skot/MujinaControl-S19/docs/fan-bulk-capacitors.md

# Fan supply bulk capacitors

C289 and C290 are Panasonic EEHZC1E101XP (catalog C178640), 100 uF ±20%, 25 V hybrid aluminum electrolytics. Both positive pins connect to protected +12V_FAN downstream of Q1; negative pins connect to GND. Existing ceramics C283–C285 are retained. C289 serves fans 1–2, C290 fans 3–4.

The manufacturer specifies 30 milliohm maximum ESR and 1.4 A RMS ripple at 100 kHz, -55 to +125 C operation, and 4000 h endurance at 125 C. Ripple rating is frequency-dependent; the catalog's 210 mA at 100 Hz is not the 100 kHz rating. These capacitors reduce fast supply disturbances; they do not supply sustained fan startup current. Check rail transients and capacitor heating with the actual fans and supply, including simultaneous start and hot plug. Added nominal stored energy at 12 V is 14.4 mJ total; no controlled-inrush function is added.

Selected package: D8, 6.3 mm diameter, 7.7 ±0.3 mm body height, 6.6 ±0.2 mm base, 7.8 mm maximum terminal span. Local KiCad footprint Capacitor_SMD:CP_Elec_6.3x7.7 uses 3.5 x 1.6 mm pads at x = ±2.7 mm. It covers the two leads (0.65 ±0.1 mm wide), including the 7.8 mm terminal envelope. Courtyard includes the 6.6 mm base. The included STEP is a generic matching-size KiCad envelope, not a manufacturer-certified detailed model.

Physical polarity map (component/top view): unstriped positive lead = symbol pin 1 = footprint pad 1 at (-2.7,0); striped negative lead = symbol pin 2 = footprint pad 2 at (+2.7,0). Bottom-view manufacturer drawing reverses the view; the positive bevel and negative stripe establish polarity, not left/right in the bottom view. Two electrical leads, two symbol pins, two electrical pads; no duplicated or mechanical pads. Library data was queried, and disposable native symbol/footprint instances were rendered and inspected under build/MujinaControl-S19/fan-bulk/pin-check.

Sources: [manufacturer specifications](https://na.industrial.panasonic.com/products/capacitors/lineup/aluminum-electrolytic-capacitors/series/80/model/126), [ZC datasheet, 2025-09-01, pp. 1–2](https://industrial.panasonic.com/cdbs/www-data/pdf/RDD0000/ABA0000C1228.pdf). Fab lookup on 2026-11-09T19:28:08Z reported 3272 pieces, $0.3848 at quantity 1, extended/economic assembly; availability and price may change.

Schematic saved and verified: all original components and 192 original pin partitions retained; two new passive branches added. ERC has no errors and two existing DISPLAY_SCL/SDA isolated-label warnings. Readability has no errors and 71 retained cross-group-wire advisories.

PCB placement and connections completed on 2026-11-09. Starting from the user's rough placement, C289 is at (128.9,57.5) mm, 180 degrees; C290 is at (117.7,57.42) mm, 0 degrees. C289 is the right-hand bulk capacitor (fan 1/2 bank); C290 is the left-hand capacitor (fan 3/4 bank). Only these two footprints moved. D231, D232, D233 and L210 reference fields were repositioned; their physical placement and all pre-existing traces/vias were preserved.

Each positive pad uses three parallel 0.45/0.30 mm filled/capped vias in the pad and a short 1.0 mm B.Cu branch into the existing +12V_FAN pour. Each ground pad uses three matching vias into both existing GND planes. Four tracks and twelve vias were added. Native connectivity readback confirms both positive pads reach Q1's source and all fan power pins; both negative pads reach all fan ground pins. The two capacitor branches carry ripple/charging current, not the four fans' continuous supply current.

Sizing screen: 1.4 A RMS capacitor ripple rating, 35 um external copper, 1.0 mm trace width, no more than 2 mm branch length, 10 C rise target. The conservative IPC-2221 external-trace relation gives about 2.39 A at 10 C rise. At 20 C copper resistivity, the longest branch is approximately 0.99 milliohm. Three parallel vias add approximately 0.36 milliohm using a 1.6 mm board and an assumed 25 um plated barrel; the combined drop is about 1.88 mV at 1.4 A. This is a screening calculation, not measured thermal/inrush qualification or confirmation of delivered plating thickness.

Verification: 257 footprints; only C289/C290 changed position/orientation. Full native object comparison preserved all original copper; session-generated board/custom-field/custom-pad-shape IDs were normalized when comparing reopened documents. Filled zones were saved. Native DRC: 108 to 85 findings, no new findings, no capacitor-related violations. Unconnected items: 246 to 242; neither capacitor has a remaining airwire. Existing Q1 ki_fp_filters parity warning remains. Schematic was unchanged during PCB work. Board-wide routing remains unfinished.

Evidence: build/MujinaControl-S19/fan-bulk-routing/audit.json, final-drc.json, routing-applied.json and fan-capacitors.png. Saved board was displayed in the canonical viewer and checked against the history checkpoint.
