skot/MujinaControl-S19/3d/kicad/SOT-363_SC-70-6.step

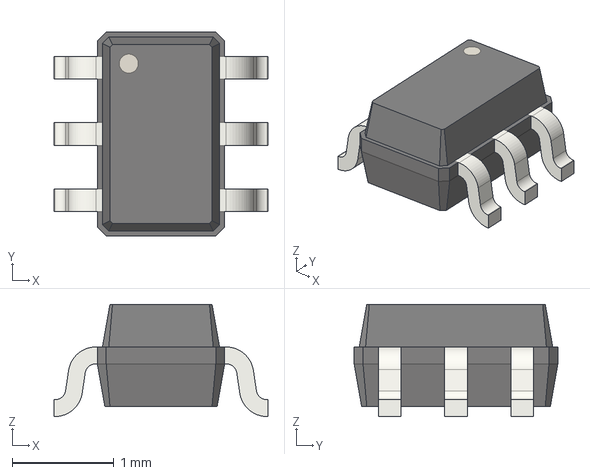
[picture p3: CAD file, 2026-11-10]
3d/kicad/SOT-363_SC-70-6.step
2.10 x 2.00 x 1.10 mm
