skot/MujinaControl-S19/3d/proxies/L_0201_0603Metric.step

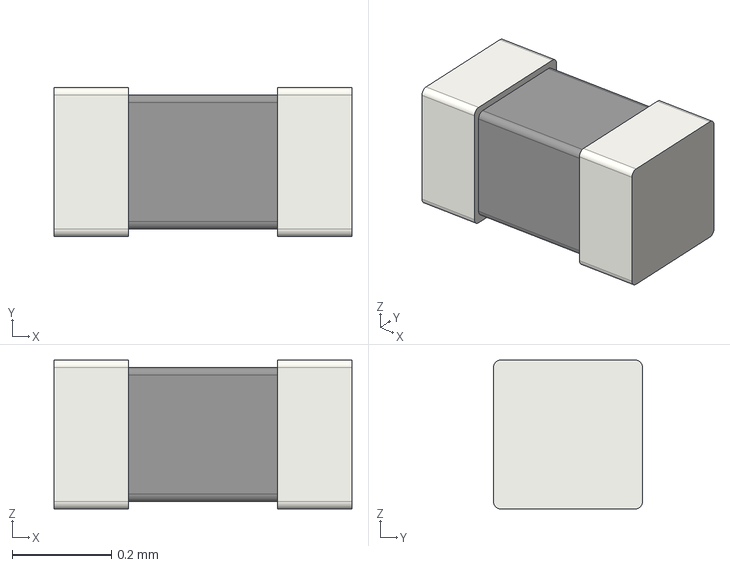
[picture p4: CAD file, 2026-11-07]
3d/proxies/L_0201_0603Metric.step
0.6 x 0.3 x 0.3 mm
