skot/MujinaControl-S19/models/CP_Elec_6.3x7.7.step

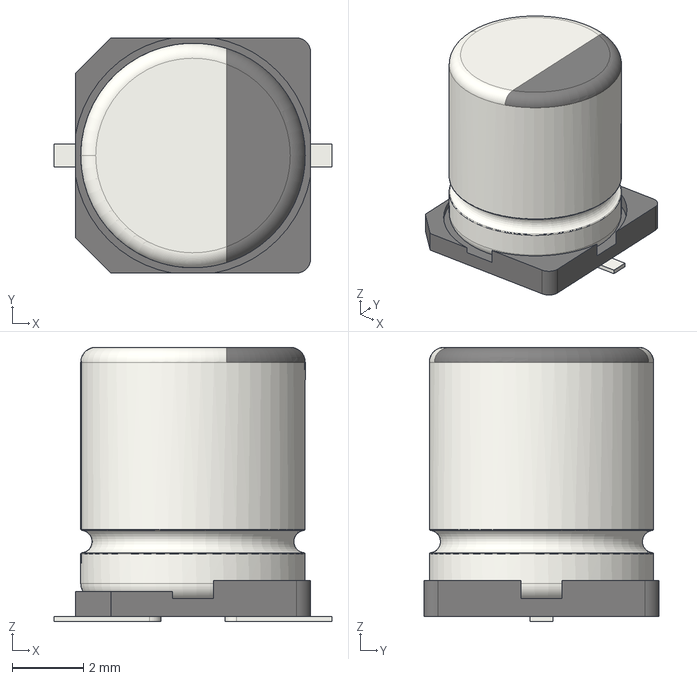
[picture p5: CAD file, 2026-11-10]
models/CP_Elec_6.3x7.7.step
7.80 x 6.60 x 7.70 mm
