skot/MujinaControl-S19/3d/bitcrane/CONN-TH_X2026WV-2-09D-46SN.step

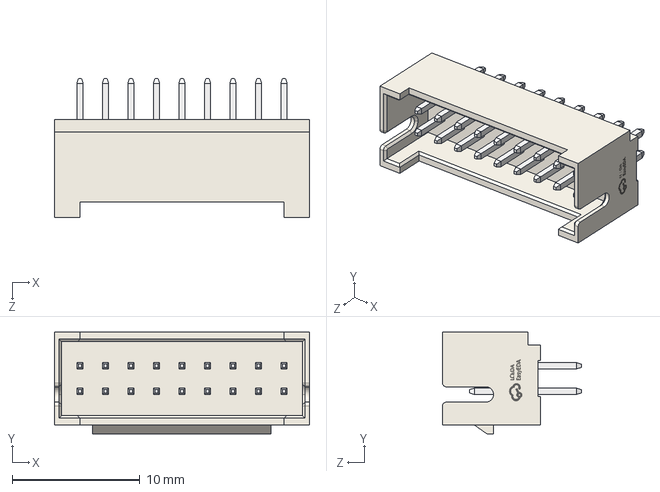
[picture p6: CAD file, 2026-11-07]
3d/bitcrane/CONN-TH_X2026WV-2-09D-46SN.step
20.0 x 8.00 x 10.9 mm
