skot/MujinaControl-S19/3d/kicad/PinHeader_2x20_P2.54mm_Vertical.step

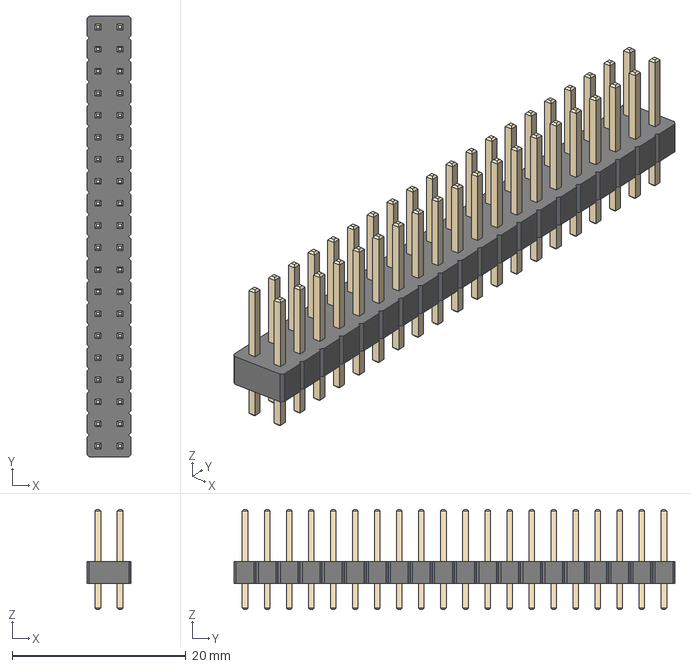
[picture p7: CAD file, 2026-11-10]
3d/kicad/PinHeader_2x20_P2.54mm_Vertical.step
5.08 x 50.8 x 11.5 mm
