skot/MujinaControl-S19/3d/raven/Rockchip_QFN-128-1EP_12.3x12.3mm_P0.35mm_EP7x7mm.step

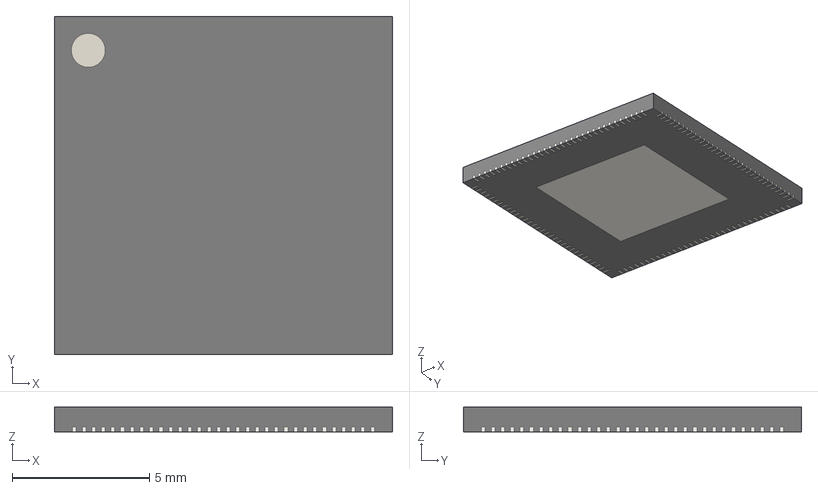
[picture p8: CAD file, 2026-11-02]
3d/raven/Rockchip_QFN-128-1EP_12.3x12.3mm_P0.35mm_EP7x7mm.step
12.3 x 12.3 x 0.9 mm
