skot/MujinaControl-S19/models/IND-SMD_L2.0-W1.6-H1.1.step

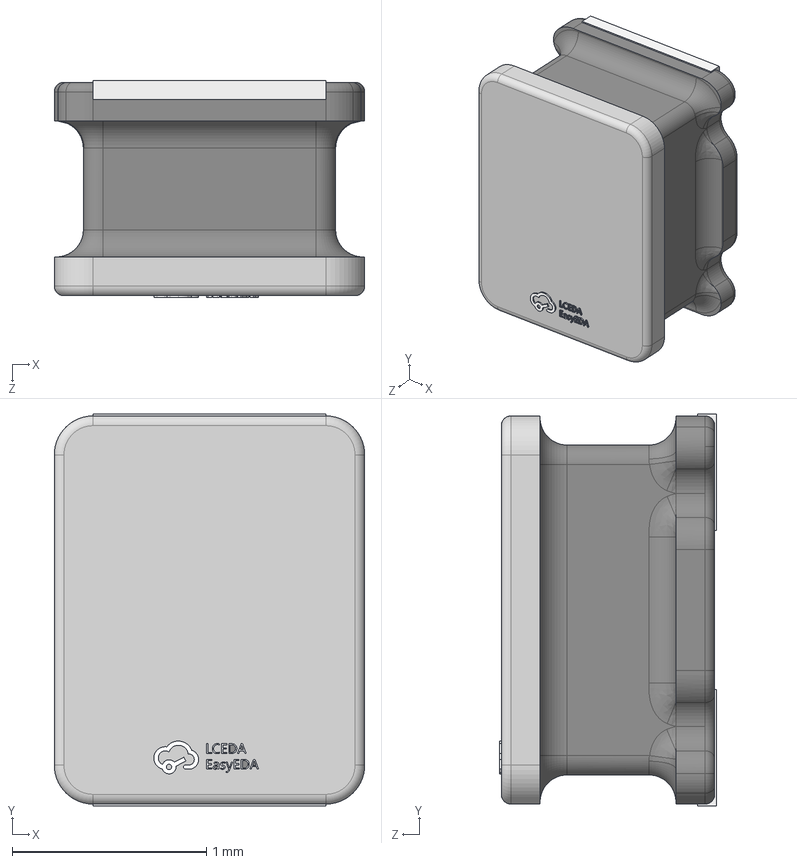
[picture p9: CAD file, 2026-11-10]
models/IND-SMD_L2.0-W1.6-H1.1.step
1.60 x 2.02 x 1.12 mm
