skot/MujinaControl-S19/3d/bitcrane/CONN-TH_MX4.20-WI-2x2P.step

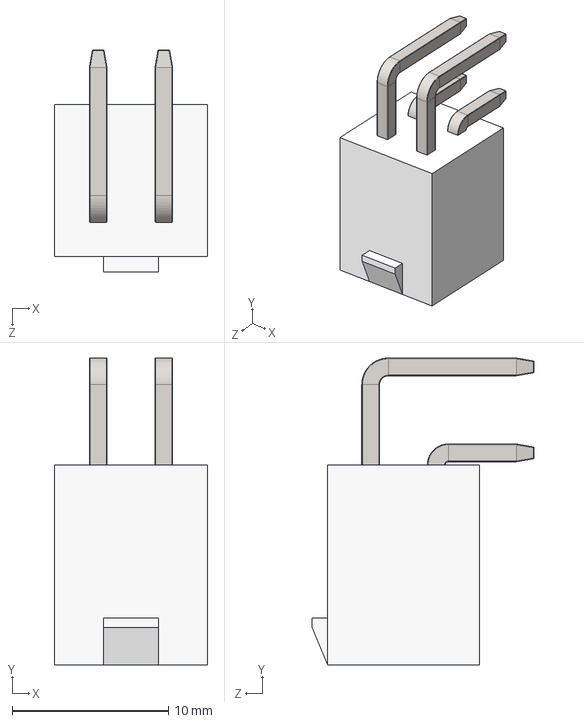
[picture p10: CAD file, 2026-11-07]
3d/bitcrane/CONN-TH_MX4.20-WI-2x2P.step
9.80 x 19.6 x 14.2 mm
