skot/MujinaControl-S19/3d/kicad/R_0402_1005Metric.step

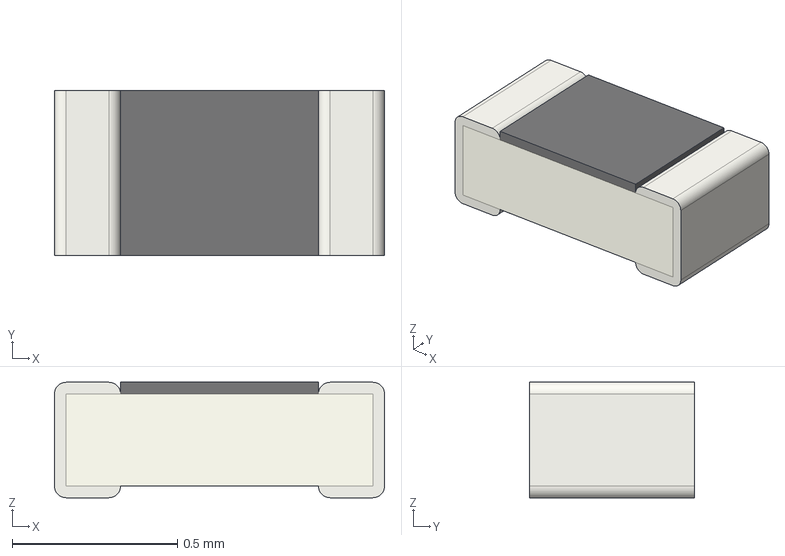
[picture p11: CAD file, 2026-11-07]
3d/kicad/R_0402_1005Metric.step
1.00 x 0.5 x 0.35 mm
