skot/MujinaControl-S19/3d/bitcrane/SW-SMD_L3.9-W2.9-H2.0-LS4.8.step

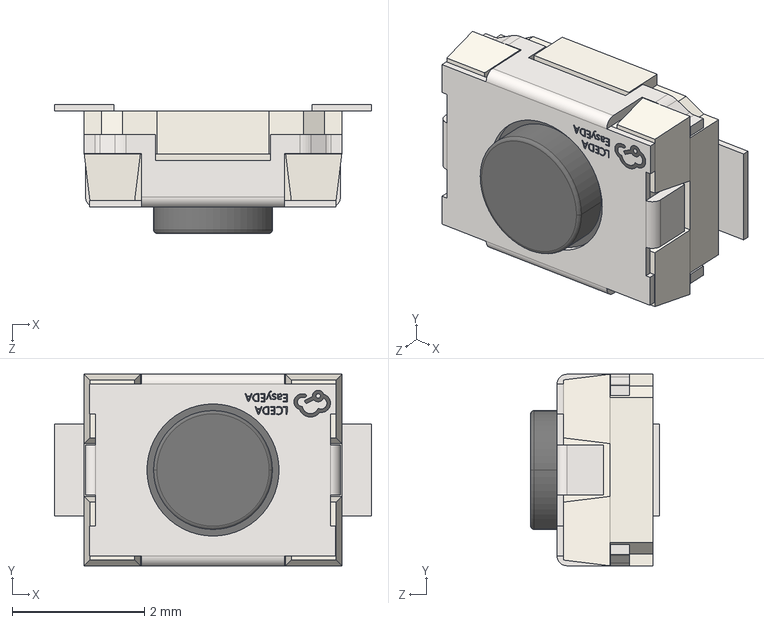
[picture p13: CAD file, 2026-11-07]
3d/bitcrane/SW-SMD_L3.9-W2.9-H2.0-LS4.8.step
4.80 x 2.90 x 1.95 mm
