skot/MujinaControl-S19/3d/kicad/C_1808_4520Metric.step

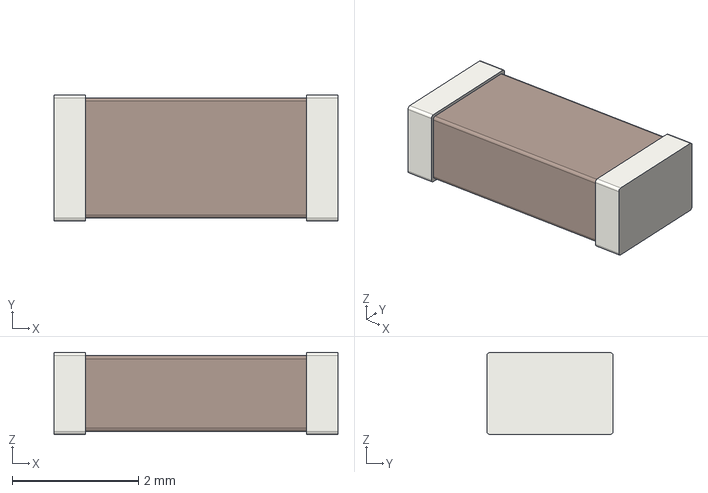
[picture p14: CAD file, 2026-11-07]
3d/kicad/C_1808_4520Metric.step
4.50 x 2.00 x 1.30 mm
