skot/MujinaControl-S19/models/SOT-583-8_L2.1-W1.2-P0.50-LS1.6-BR.step

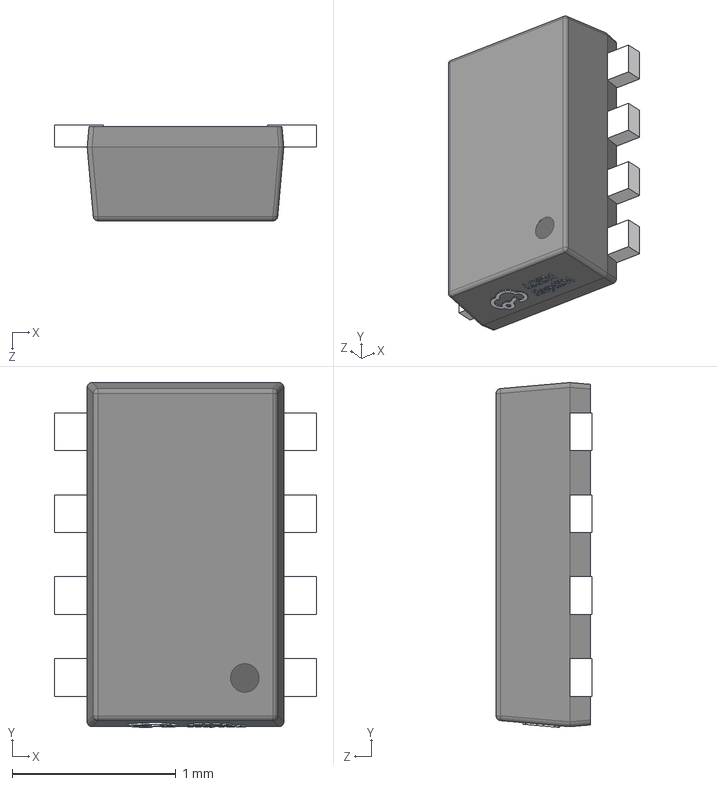
[picture p15: CAD file, 2026-11-10]
models/SOT-583-8_L2.1-W1.2-P0.50-LS1.6-BR.step
1.60 x 2.10 x 0.585 mm
