skot/MujinaControl-S19/3d/bitcrane/CONN-TH_50362462.step

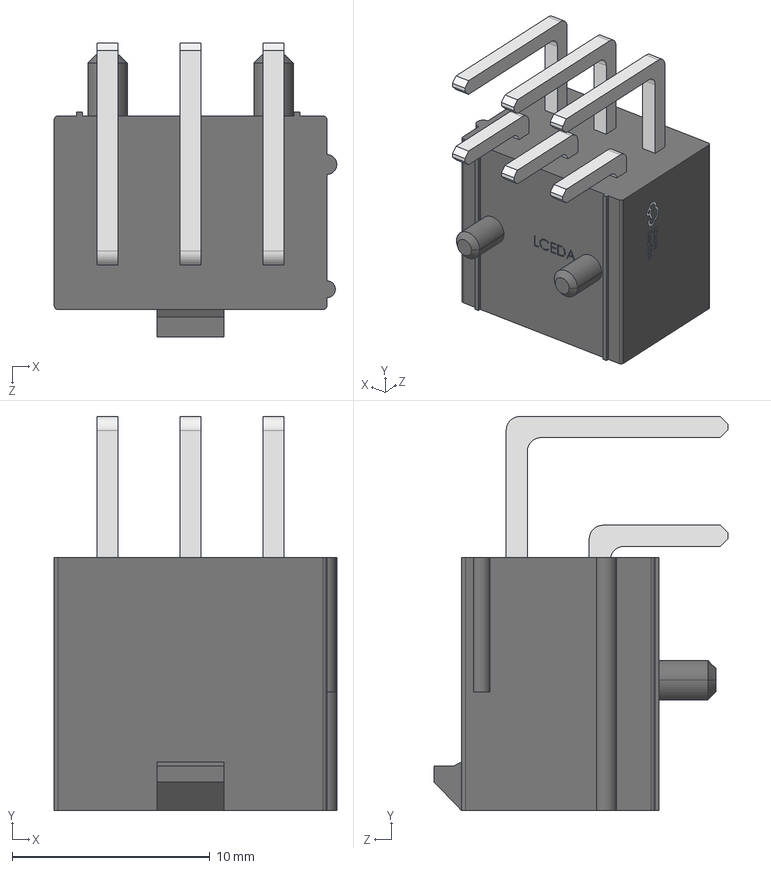
[picture p16: CAD file, 2026-11-07]
3d/bitcrane/CONN-TH_50362462.step
14.3 x 19.9 x 14.9 mm
