skot/MujinaControl-S19/3d/kicad/Crystal_SMD_3225-4Pin_3.2x2.5mm.step

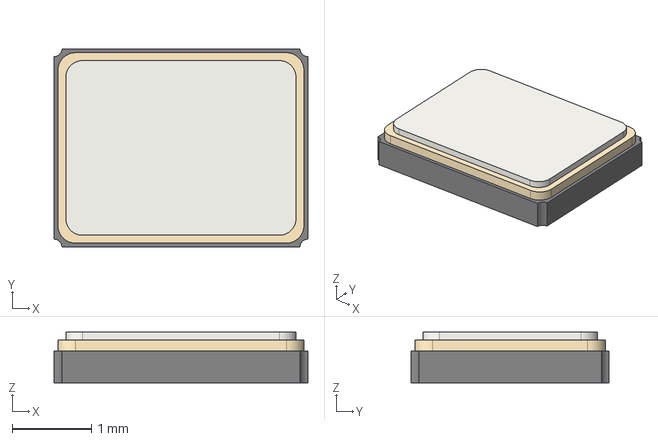
[picture p17: CAD file, 2026-11-07]
3d/kicad/Crystal_SMD_3225-4Pin_3.2x2.5mm.step
3.20 x 2.50 x 0.64 mm
