skot/MujinaControl-S19/3d/bitcrane/CONN-TH_4P-P2.54_HCTL_HC-2510-4AW.step

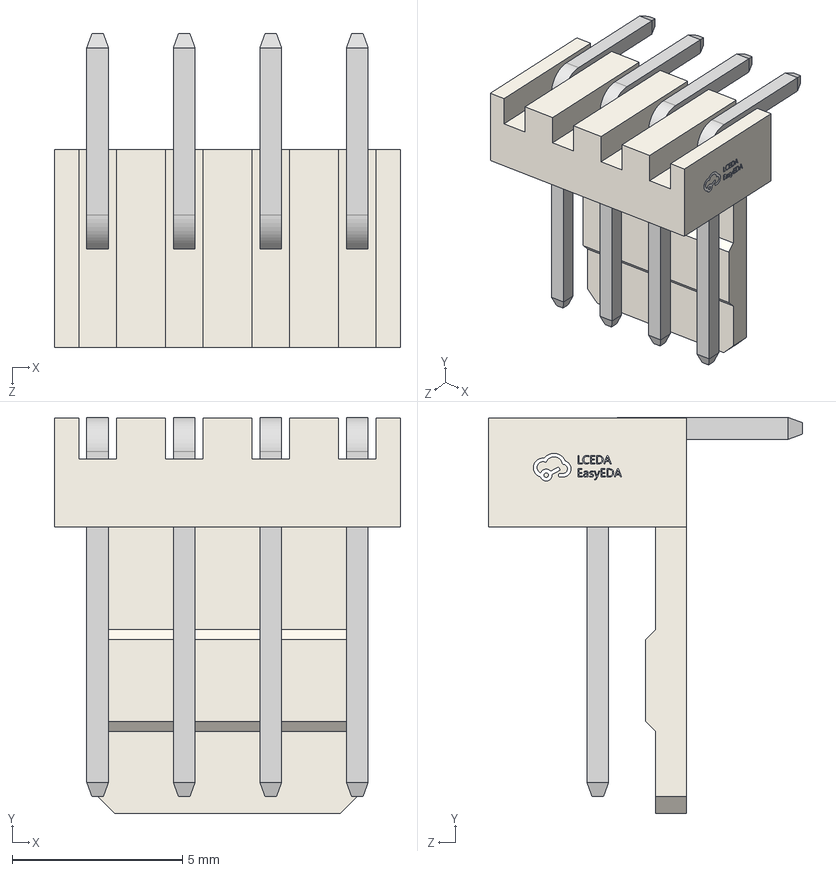
[picture p18: CAD file, 2026-11-07]
3d/bitcrane/CONN-TH_4P-P2.54_HCTL_HC-2510-4AW.step
10.2 x 11.6 x 9.20 mm
