skot/MujinaControl-S19/3d/kicad/C_1210_3225Metric.step

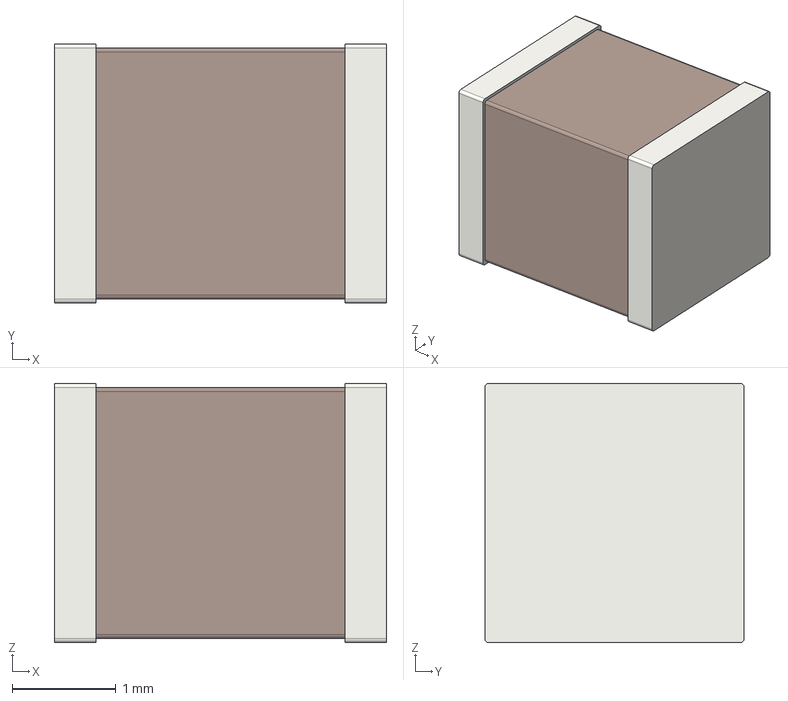
[picture p19: CAD file, 2026-11-07]
3d/kicad/C_1210_3225Metric.step
3.20 x 2.50 x 2.50 mm
