skot/MujinaControl-S19/3d/bitcrane/CONN-TH_6P-P2.00_PHD-2X3A.step

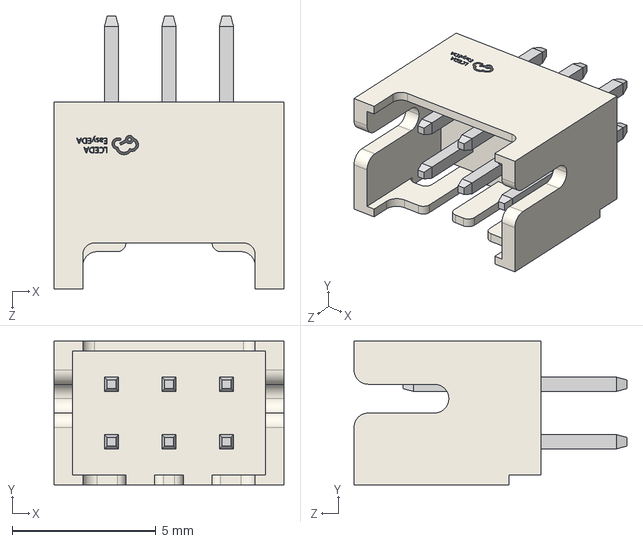
[picture p20: CAD file, 2026-11-07]
3d/bitcrane/CONN-TH_6P-P2.00_PHD-2X3A.step
8.00 x 5.00 x 9.50 mm
