skot/MujinaControl-S19/3d/kicad/C_0805_2012Metric.step

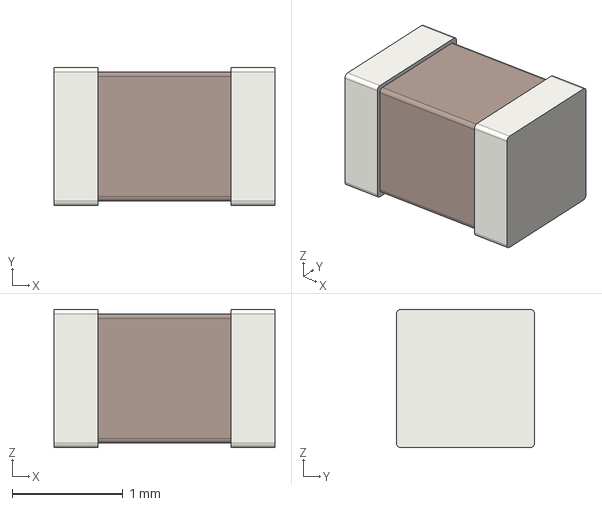
[picture p21: CAD file, 2026-11-07]
3d/kicad/C_0805_2012Metric.step
2.00 x 1.25 x 1.25 mm
