skot/MujinaControl-S19/3d/kicad/TSOT-23-6.step

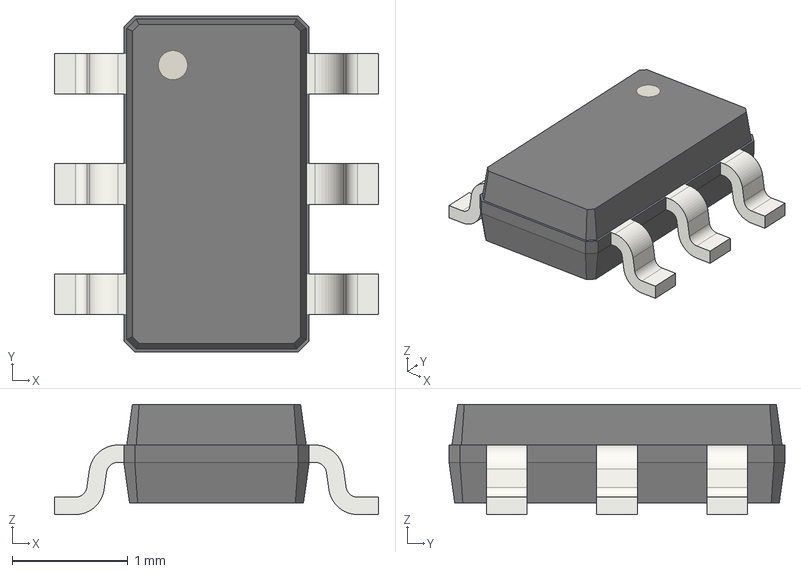
[picture p22: CAD file, 2026-11-07]
3d/kicad/TSOT-23-6.step
2.80 x 2.90 x 0.95 mm
