skot/MujinaControl-S19/3d/kicad/SOT-23.step

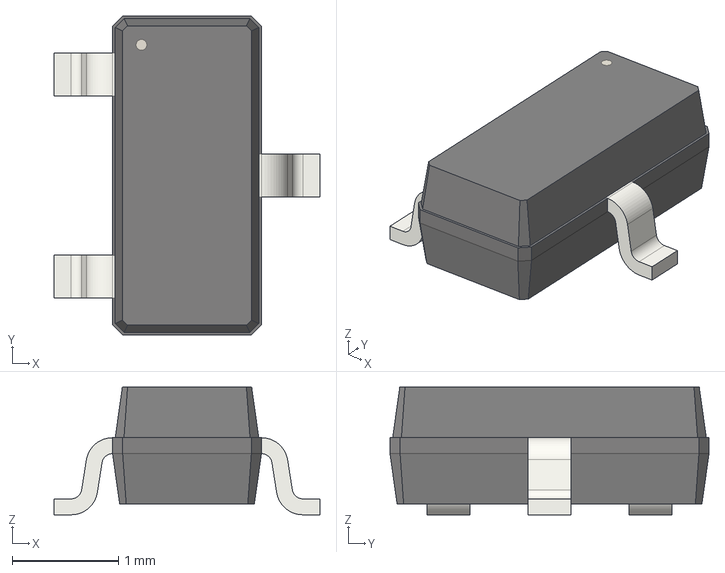
[picture p23: CAD file, 2026-11-07]
3d/kicad/SOT-23.step
2.50 x 3.00 x 1.20 mm
