skot/MujinaControl-S19/3d/kicad/SOT-23-6.step

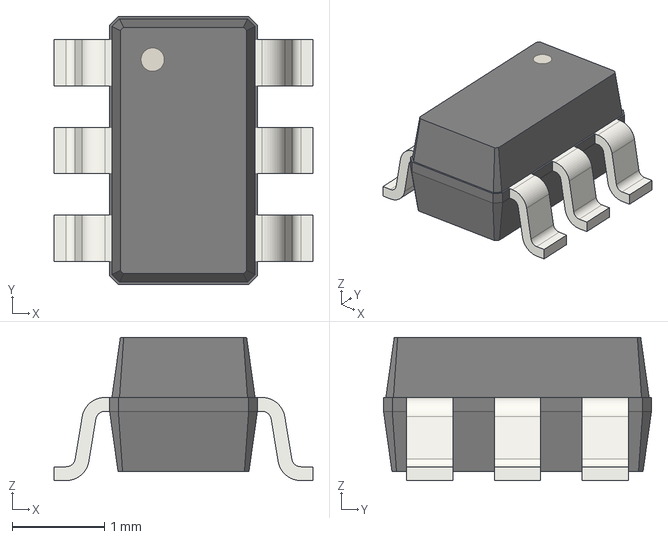
[picture p24: CAD file, 2026-11-07]
3d/kicad/SOT-23-6.step
2.80 x 2.90 x 1.55 mm
