skot/MujinaControl-S19/3d/kicad/L_APV_ANR6028.step

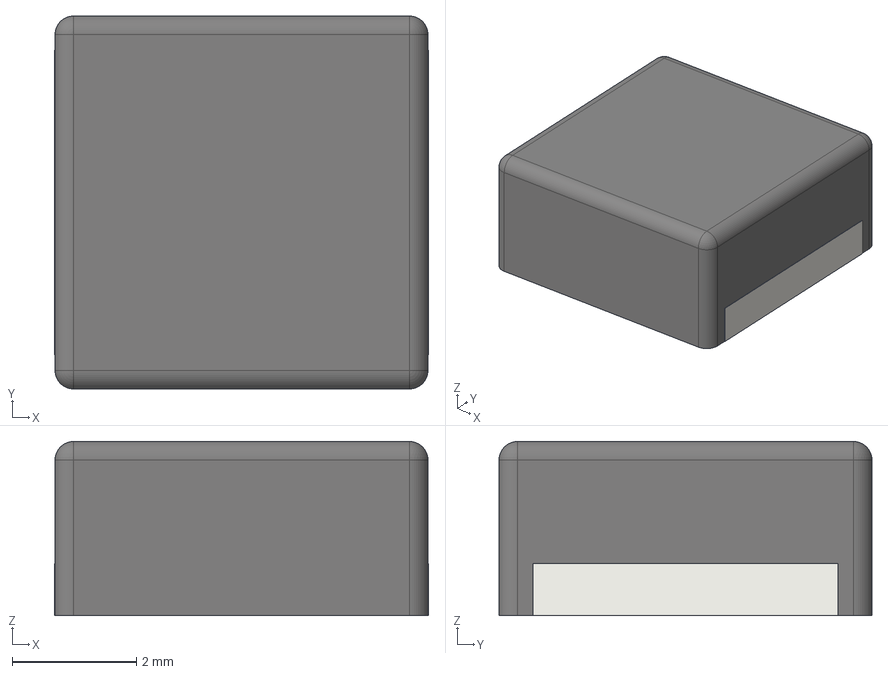
[picture p25: CAD file, 2026-11-07]
3d/kicad/L_APV_ANR6028.step
6.02 x 6.00 x 2.80 mm
