skot/MujinaControl-S19/3d/kicad/Crystal_SMD_3215-2Pin_3.2x1.5mm.step

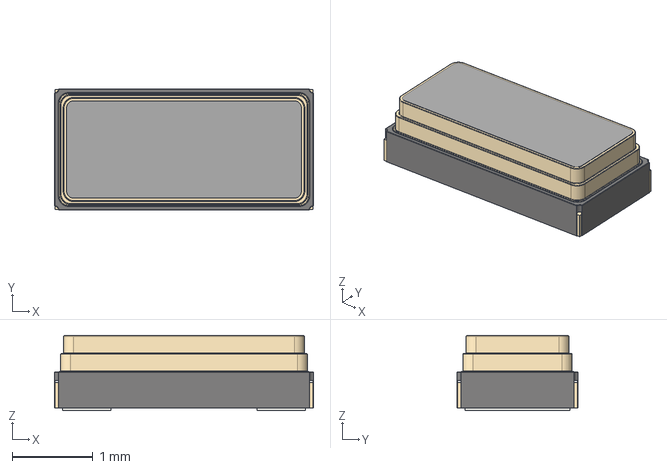
[picture p26: CAD file, 2026-11-07]
3d/kicad/Crystal_SMD_3215-2Pin_3.2x1.5mm.step
3.20 x 1.50 x 0.93 mm
