skot/MujinaControl-S19/3d/kicad/PinHeader_1x03_P2.54mm_Vertical.step

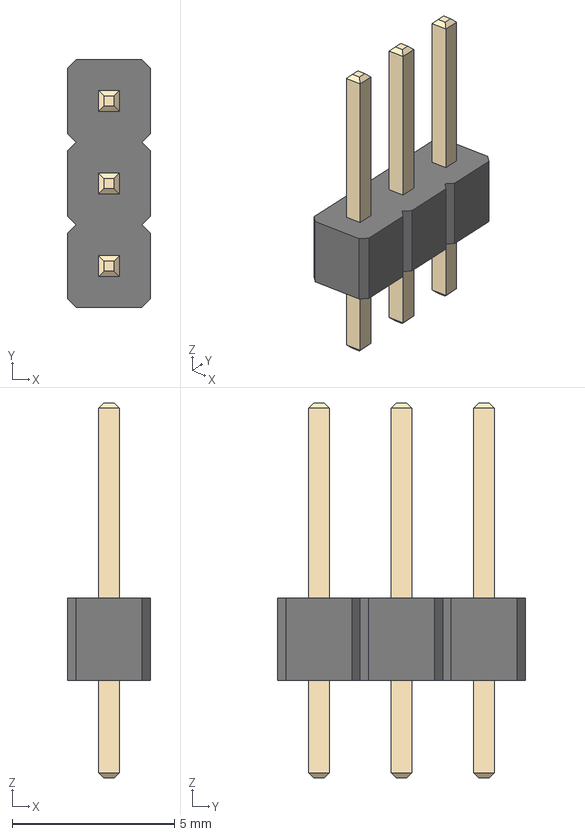
[picture p27: CAD file, 2026-11-07]
3d/kicad/PinHeader_1x03_P2.54mm_Vertical.step
2.54 x 7.62 x 11.5 mm
