skot/MujinaControl-S19/3d/kicad/D_SOD-523.step

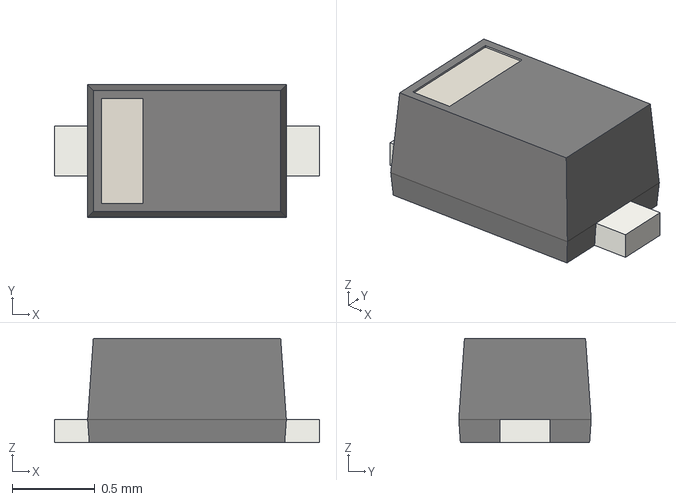
[picture p28: CAD file, 2026-11-07]
3d/kicad/D_SOD-523.step
1.60 x 0.8 x 0.63 mm
