skot/MujinaControl-S19/3d/kicad/D_SOD-123.step

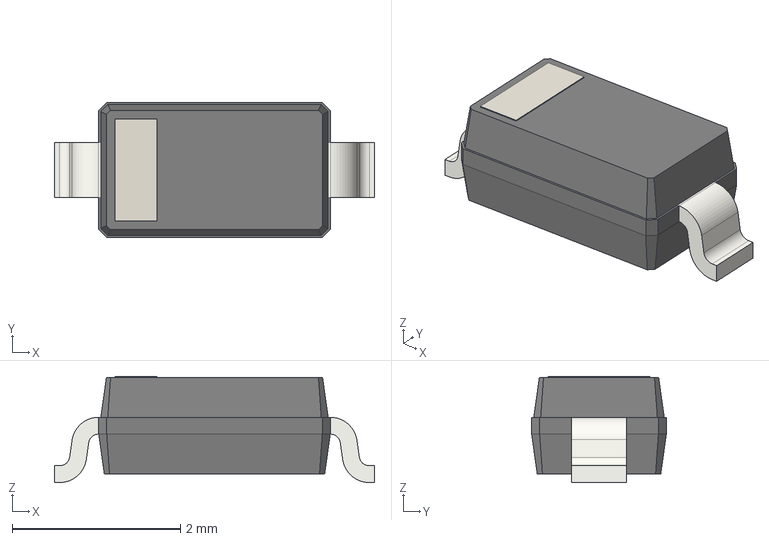
[picture p29: CAD file, 2026-11-07]
3d/kicad/D_SOD-123.step
3.80 x 1.60 x 1.26 mm
