skot/MujinaControl-S19/3d/kicad/microSD_HC_Hirose_DM3D-SF.step

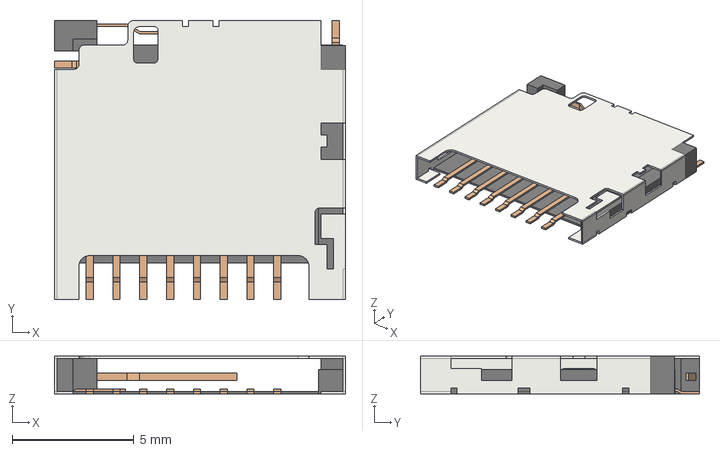
[picture p30: CAD file, 2026-11-07]
3d/kicad/microSD_HC_Hirose_DM3D-SF.step
11.9 x 11.5 x 1.55 mm
