skot/MujinaControl-S19/3d/kicad/C_0402_1005Metric.step

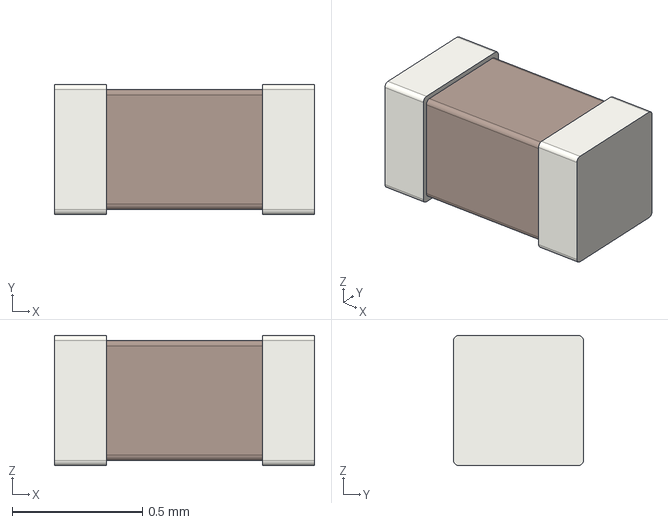
[picture p31: CAD file, 2026-11-07]
3d/kicad/C_0402_1005Metric.step
1.00 x 0.5 x 0.5 mm
