skot/MujinaControl-S19/3d/kicad/LED_0603_1608Metric.step

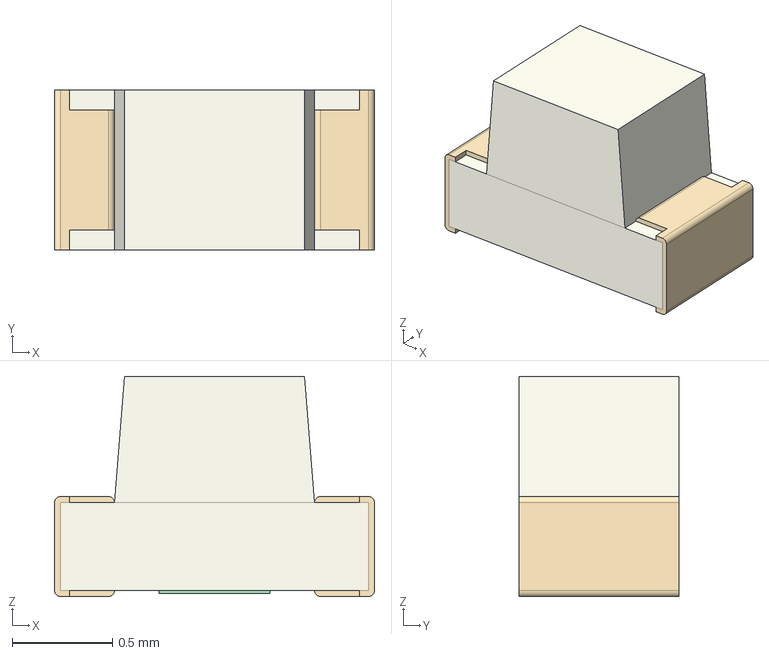
[picture p33: CAD file, 2026-11-07]
3d/kicad/LED_0603_1608Metric.step
1.60 x 0.8 x 1.10 mm
