skot/MujinaControl-S19/3d/kicad/Diodes_PowerDI3333-8.step

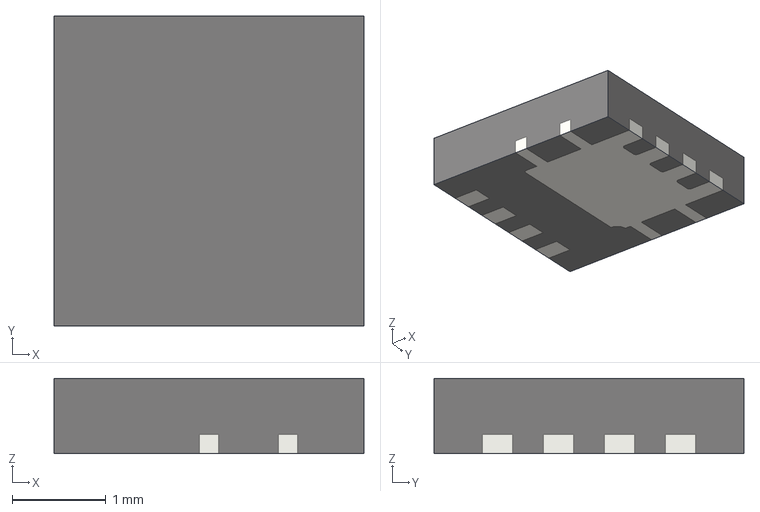
[picture p34: CAD file, 2026-11-07]
3d/kicad/Diodes_PowerDI3333-8.step
3.30 x 3.30 x 0.8 mm
