skot/MujinaControl-S19/3d/kicad/L_Bourns-SRN4018.step

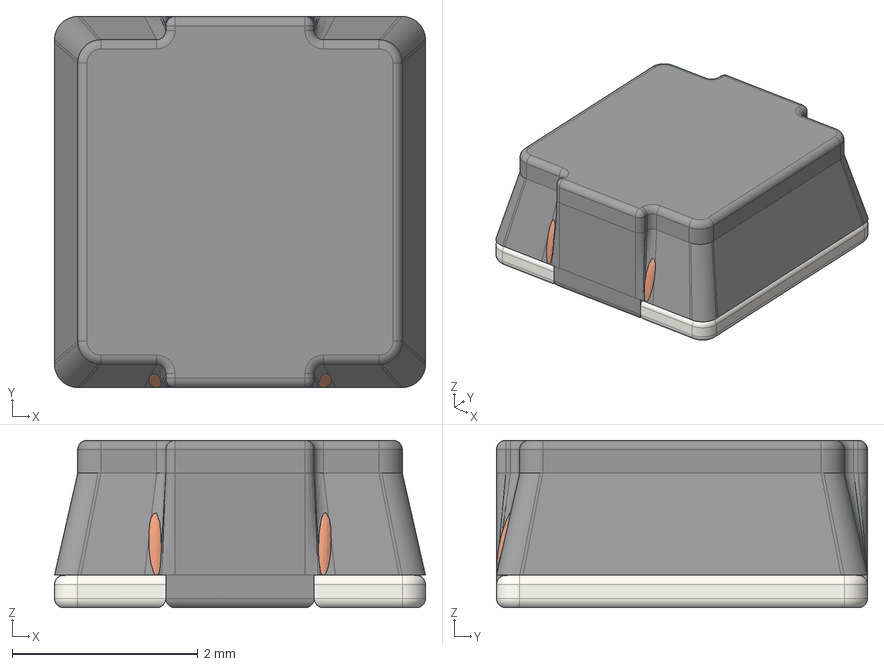
[picture p35: CAD file, 2026-11-07]
3d/kicad/L_Bourns-SRN4018.step
4.00 x 4.00 x 1.80 mm
