skot/MujinaControl-S19/3d/kicad/PinHeader_1x04_P2.54mm_Vertical.step

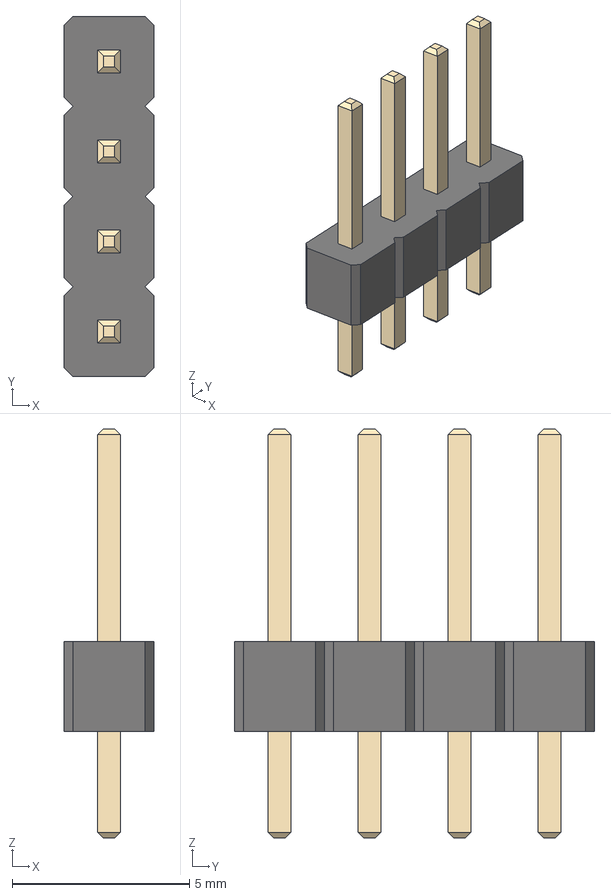
[picture p36: CAD file, 2026-11-07]
3d/kicad/PinHeader_1x04_P2.54mm_Vertical.step
2.54 x 10.2 x 11.5 mm
