skot/MujinaControl-S19/3d/kicad/D_SMB.step

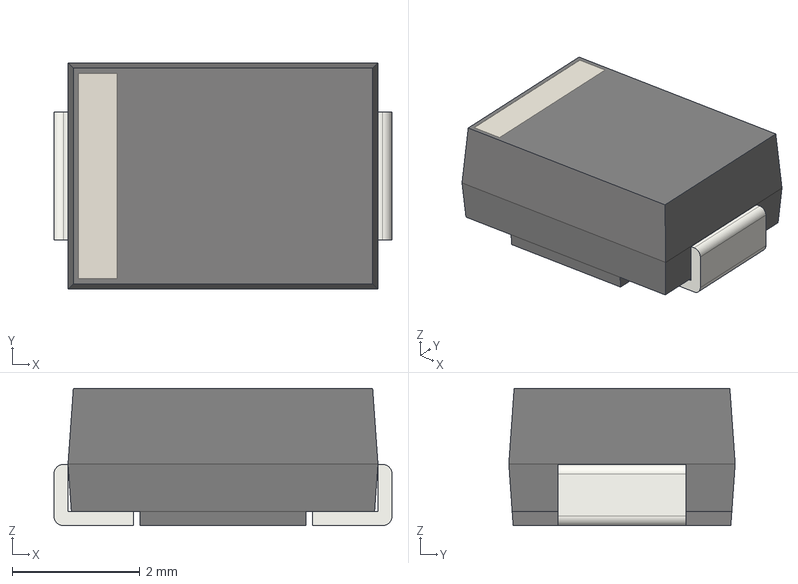
[picture p37: CAD file, 2026-11-07]
3d/kicad/D_SMB.step
5.30 x 3.55 x 2.15 mm
