skot/MujinaControl-S19/(list of files, cad)

Other CAD files:
3d/kicad/L_0402_1005Metric.step
3d/raven/HR911105A.step
