skot/MujinaControl-S19/MujinaControl-S19.kicad_pcb

## KiCad design MujinaControl-S19.kicad_pcb (2026-11-12)

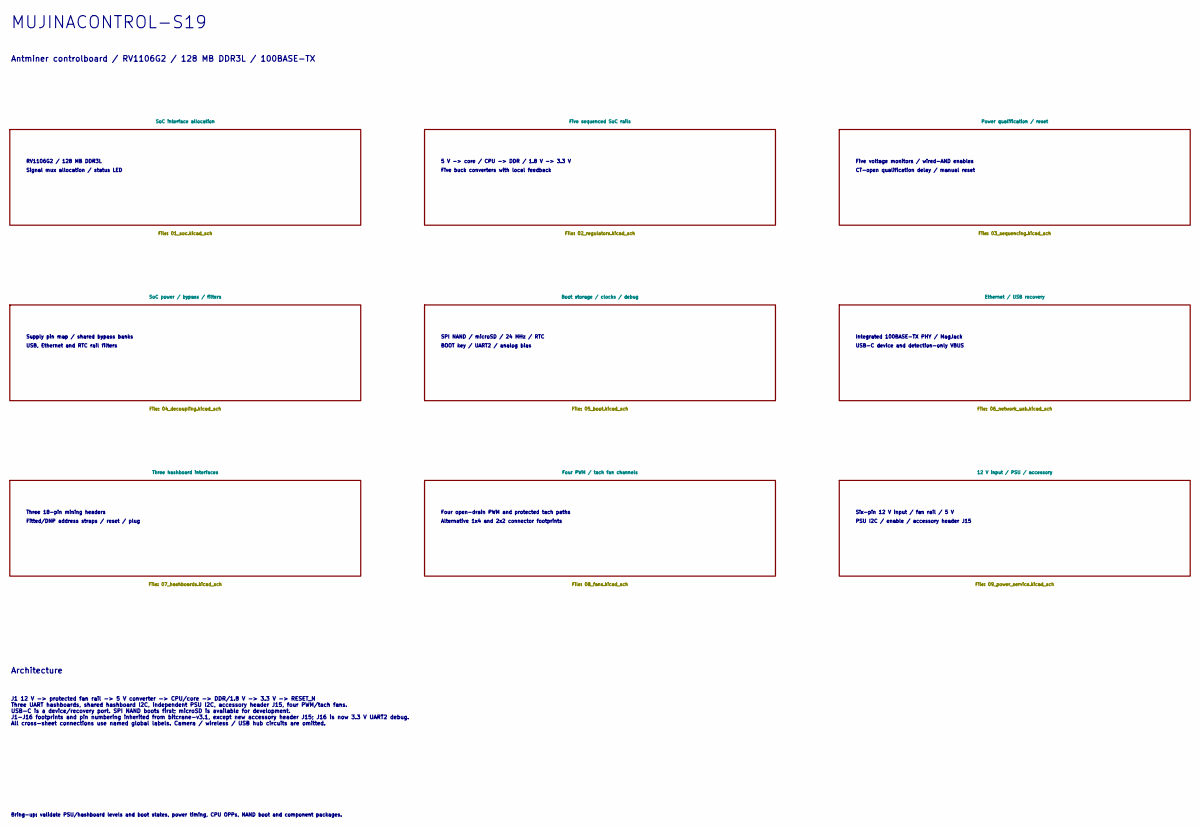
[picture p38: schematic MujinaControl-S19.kicad_sch, MujinaControl-S19 / System overview]

Notes on the sheet:
USB, Ethernet and RTC rail filters
Integrated 100BASE-TX PHY / MagJack
Five voltage monitors / wired-AND enables
PSU I2C / enable / accessory header J15
MUJINACONTROL-S19
5 V -> core / CPU -> DDR / 1.8 V -> 3.3 V
Architecture
Five buck converters with local feedback
BOOT key / UART2 / analog bias
Alternative 1x4 and 2x2 connector footprints
USB-C device and detection-only VBUS
SPI NAND / microSD / 24 MHz / RTC
J1 12 V -> protected fan rail -> 5 V converter -> CPU/core -> DDR/1.8 V -> 3.3 V -> RESET_N Three UART hashboards, shared hashboard I2C, independent PSU I2C, accessory header J15, four PWM/tach fans. USB-C is a device/recovery port. SPI NAND boots first; microSD is available for development. J1-J16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
Supply pin map / shared bypass banks
Antminer controlboard / RV1106G2 / 128 MB DDR3L / 100BASE-TX
CT-open qualification delay / manual reset
Fitted/DNP address straps / reset / plug
RV1106G2 / 128 MB DDR3L
Bring-up: validate PSU/hashboard levels and boot states, power timing, CPU OPPs, NAND boot and component packages.
Signal mux allocation / status LED
Three 18-pin mining headers
Four open-drain PWM and protected tach paths
Six-pin 12 V input / fan rail / 5 V

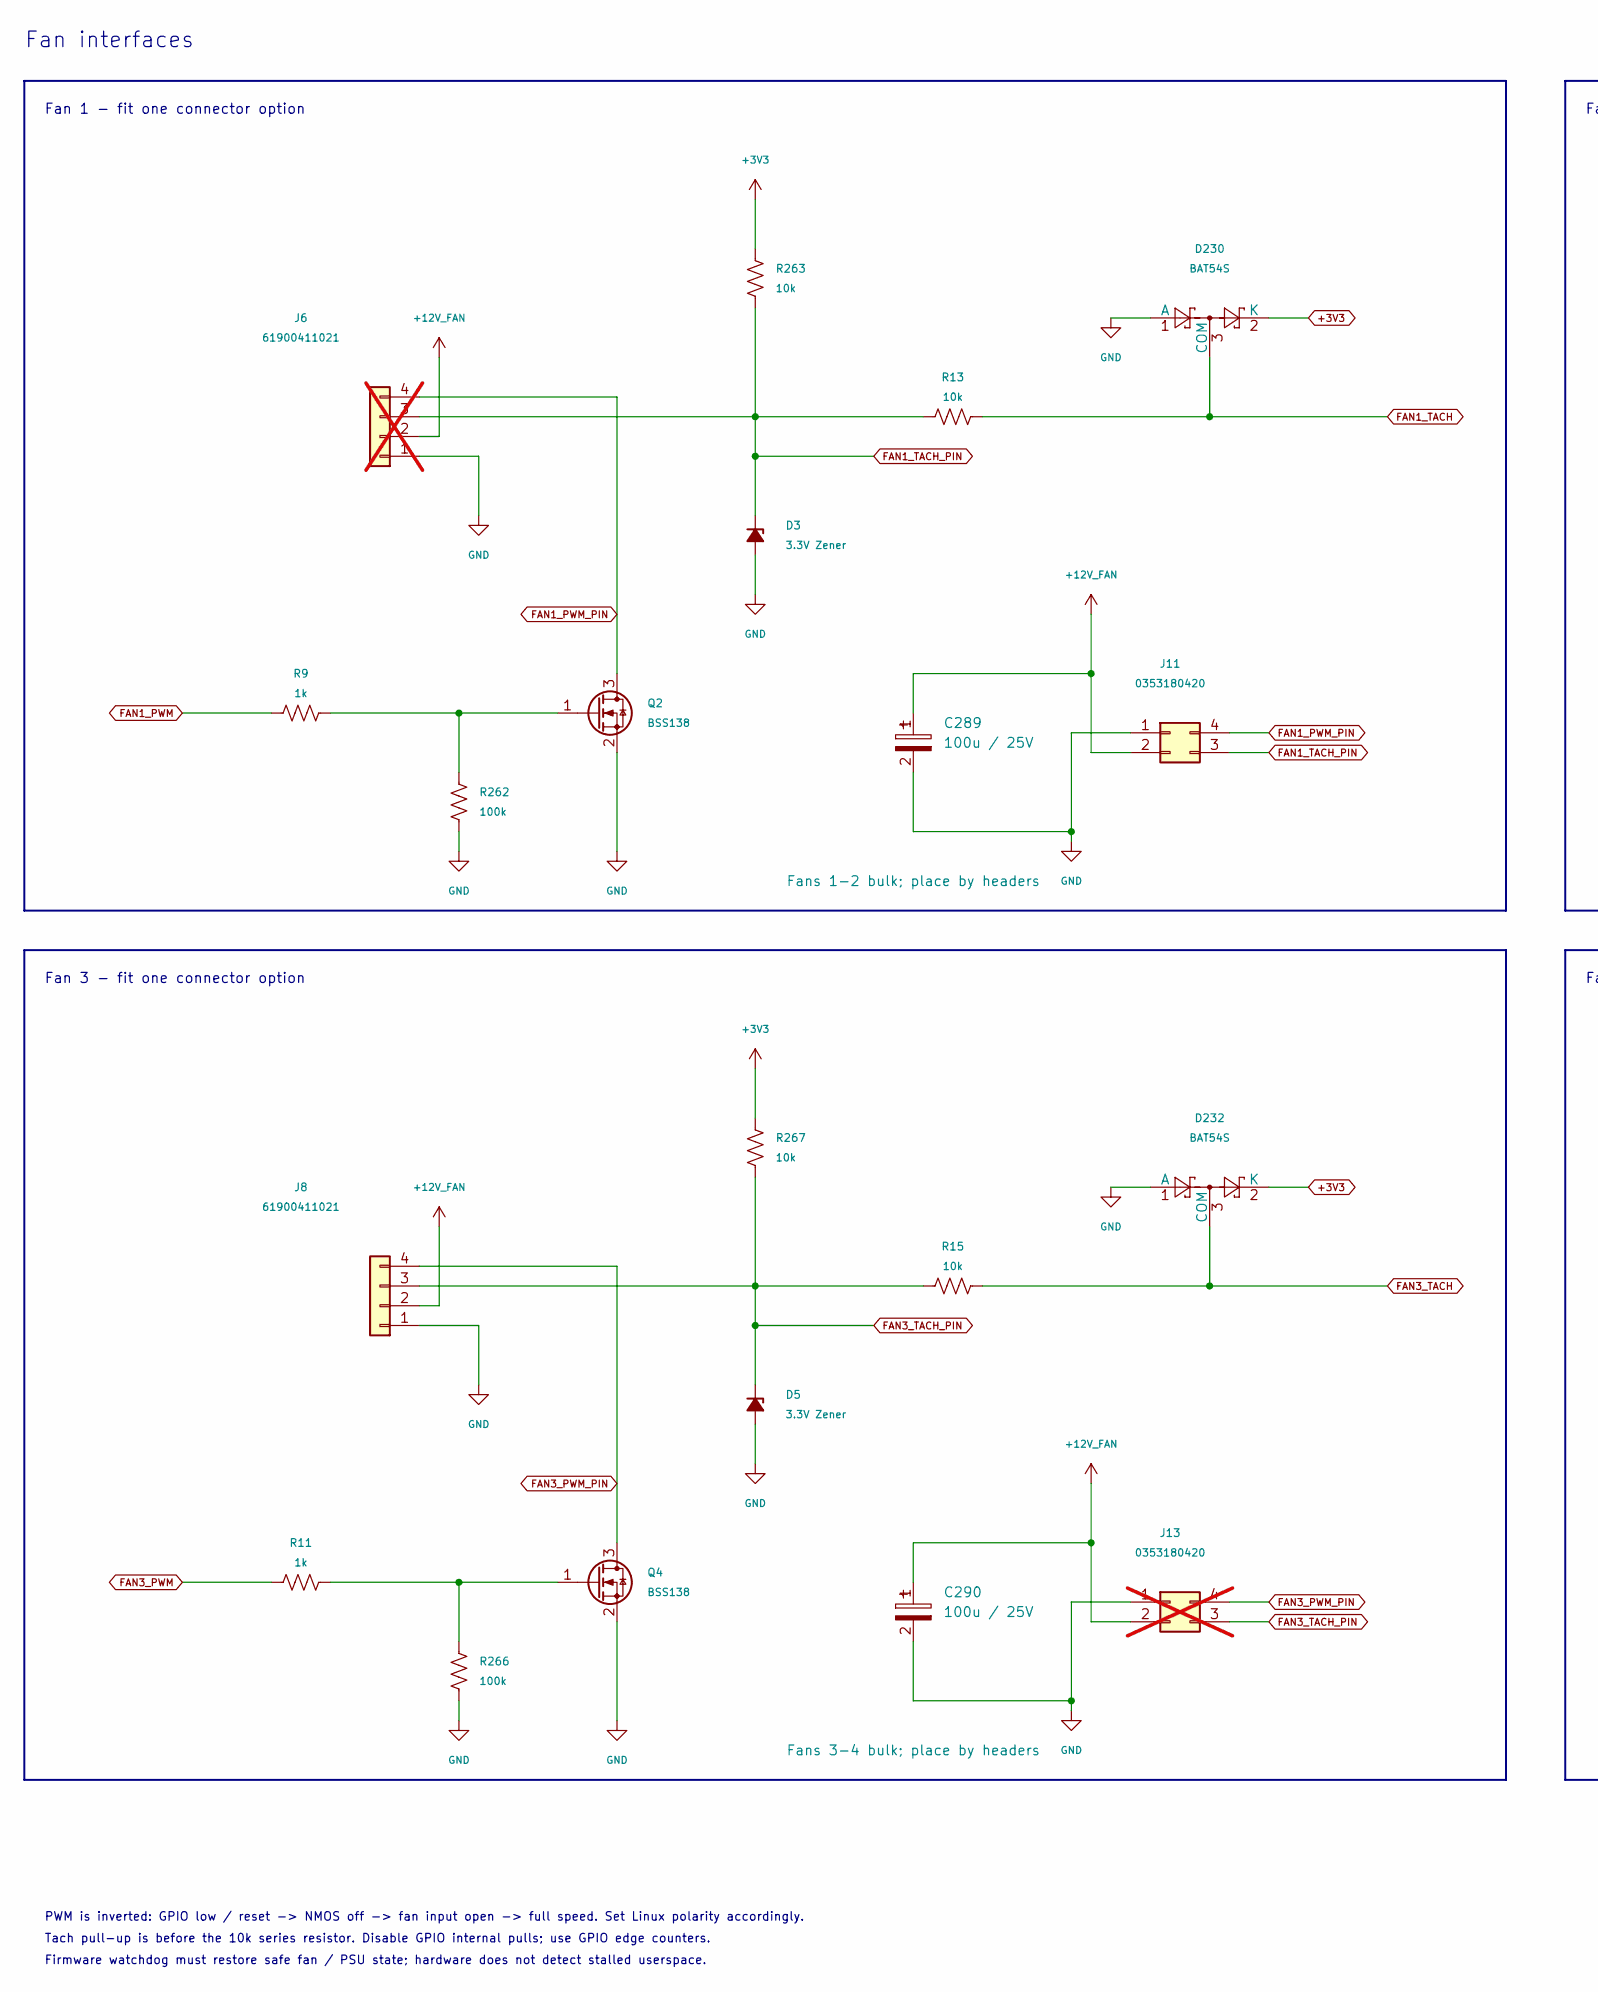
[picture p39: schematic 08_fans.kicad_sch, MujinaControl-S19 / Fan interfaces, part in row 1, column 1]

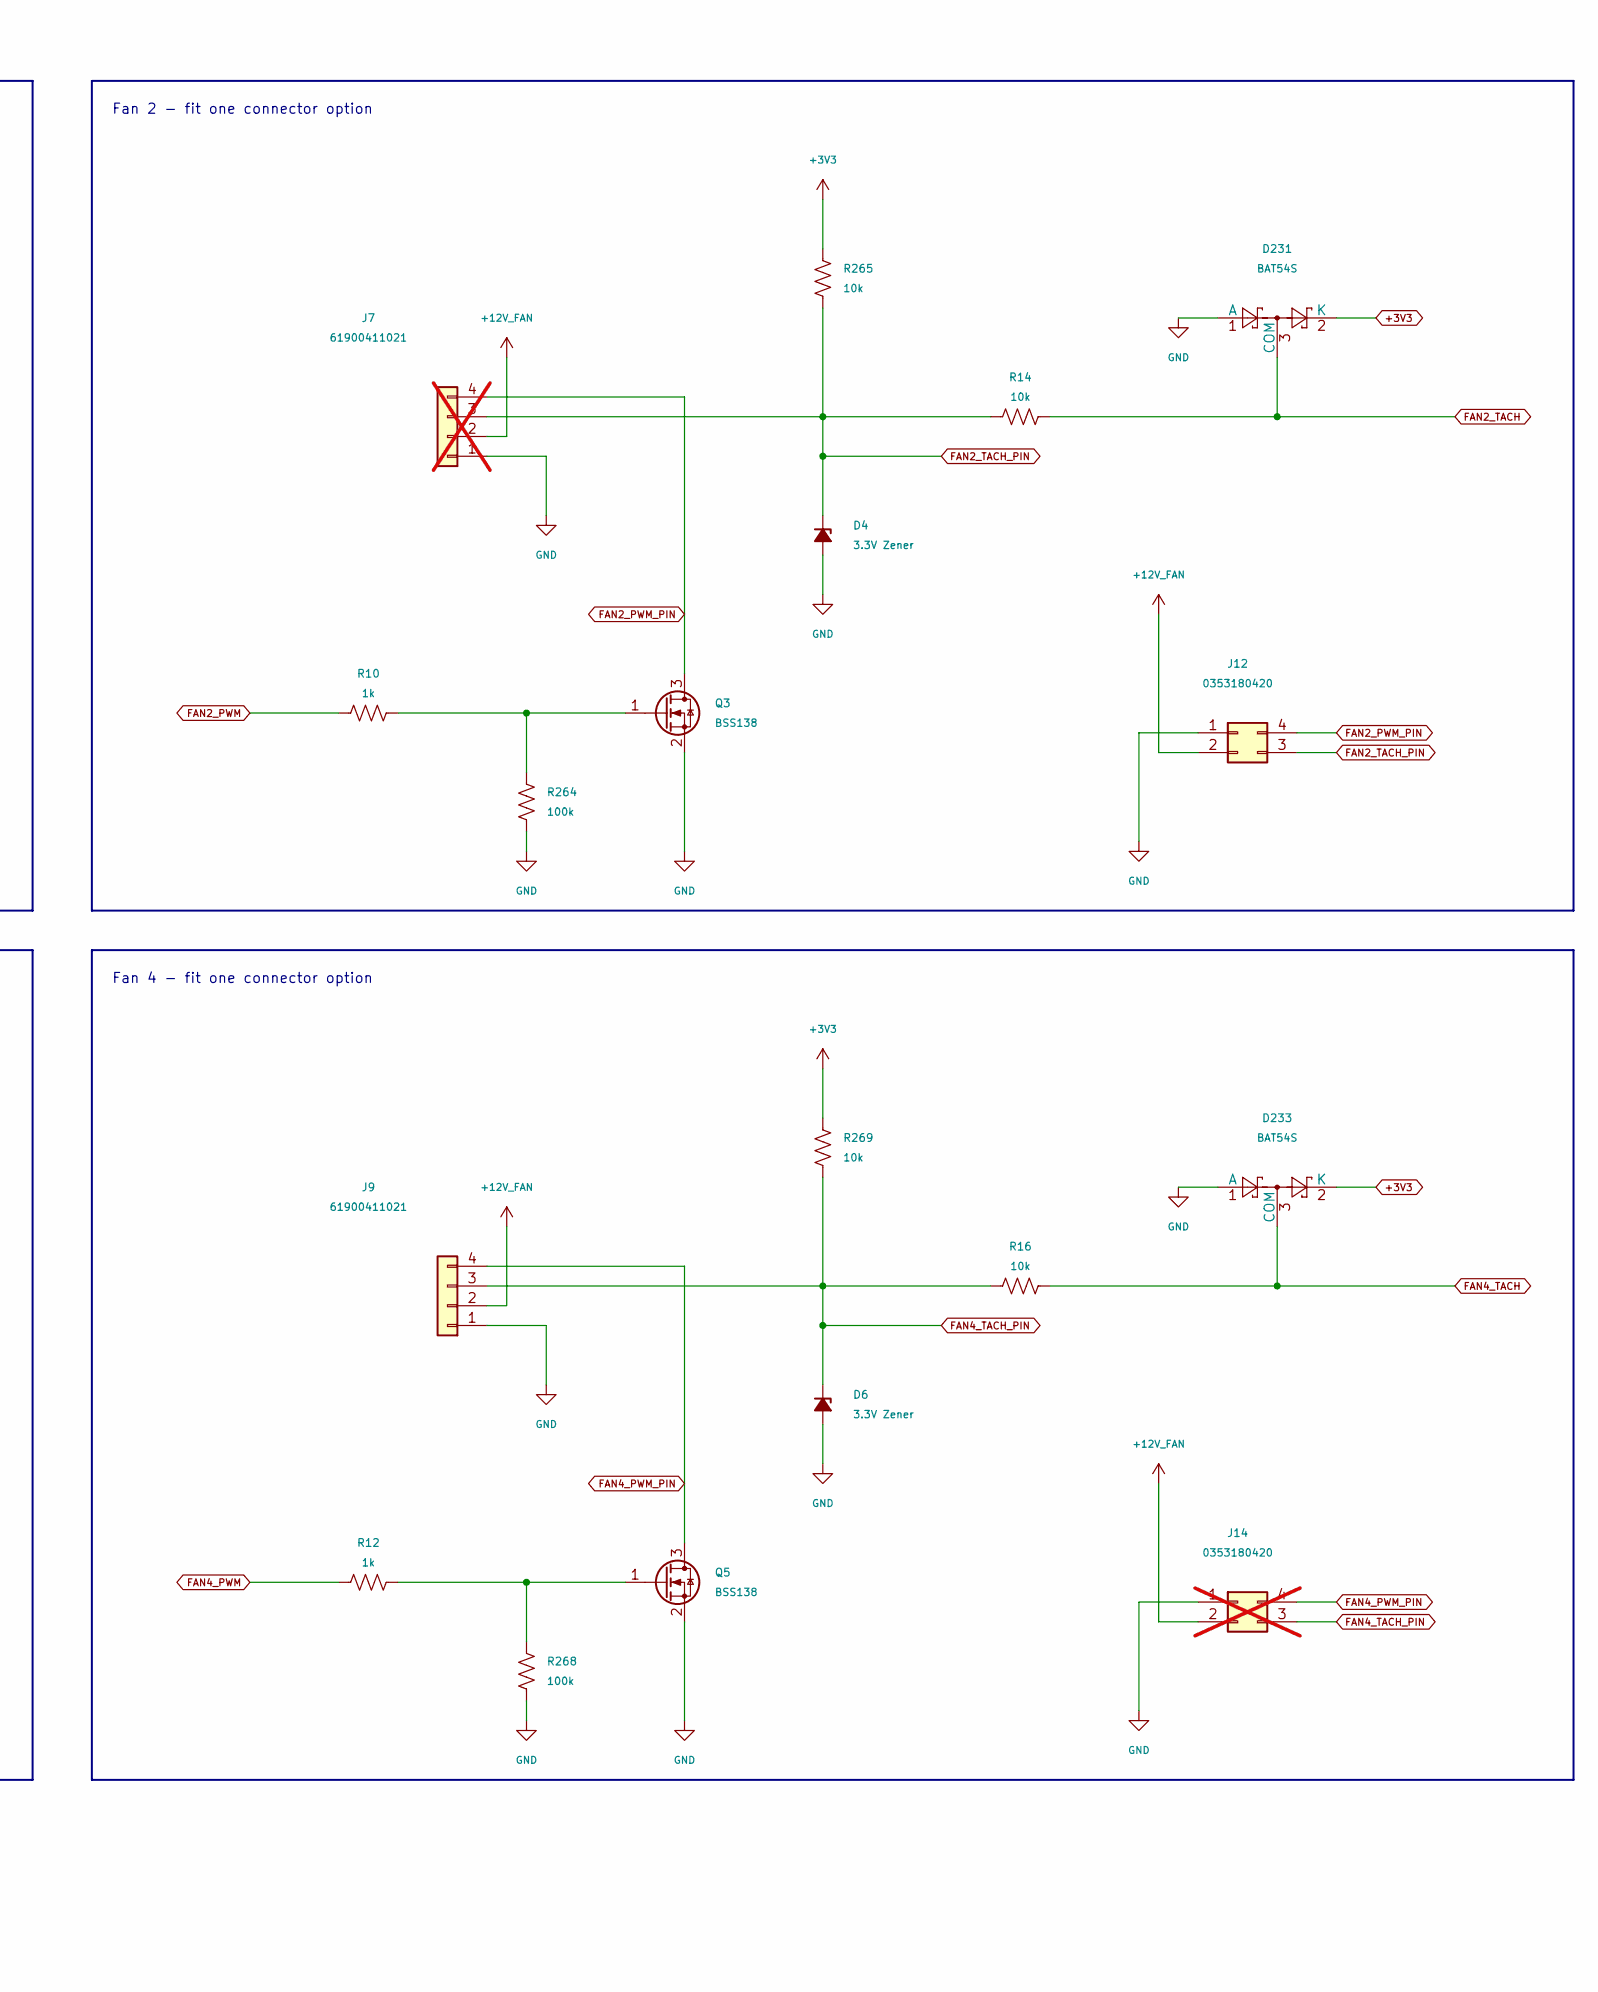
[picture p40: schematic 08_fans.kicad_sch, MujinaControl-S19 / Fan interfaces, part in row 1, column 2]

Parts:
C289, C290: 100u / 25V; CP_Elec_6.3x7.7; MPN EEHZC1E101XP; LCSC C178640
D3, D4, D5, D6: 3.3V Zener; D_SOD-123; MPN BZT52C3V3; LCSC C19077396
D230, D231, D232, D233: BAT54S; SOT-23; MPN BAT54S; LCSC C7420333
J6, J7: 61900411021; CONN-TH_4P-P2.54_HCTL_HC-2510-4AW; MPN HC-2510-4AW; LCSC C2982043; not fitted
J8, J9: 61900411021; CONN-TH_4P-P2.54_HCTL_HC-2510-4AW; MPN HC-2510-4AW; LCSC C2982043
J11, J12: 0353180420; CONN-TH_4P-P4.20_5557-2X2AW; MPN 4.2-2*2AW; LCSC C54909
J13, J14: 0353180420; CONN-TH_4P-P4.20_5557-2X2AW; MPN 4.2-2*2AW; LCSC C54909; not fitted
Q2, Q3, Q4, Q5: BSS138; SOT-23; MPN BSS138; LCSC C7420339
R9, R10, R11, R12: 1k; R_0402_1005Metric; MPN 0402WGF1001TCE; LCSC C11702
R13, R14, R15, R16, R263, R265, R267, R269: 10k; R_0402_1005Metric; MPN 0402WGF1002TCE; LCSC C25744
R262, R264, R266, R268: 100k; R_0402_1005Metric; MPN 0402WGF1003TCE; LCSC C25741

Connections:
+3V3: D230.2 (K), D231.2 (K), D232.2 (K), D233.2 (K), R263.1, R265.1, R267.1, R269.1; also elsewhere on the board
+12V_FAN: C289.1, C290.1, J6.2, J7.2, J8.2, J9.2, J11.2, J12.2, J13.2, J14.2; also elsewhere on the board
FAN1_PWM: R9.1; also elsewhere on the board
FAN1_PWM_PIN: J6.4, J11.4, Q2.3 (D)
FAN1_TACH: D230.3 (COM), R13.2; also elsewhere on the board
FAN1_TACH_PIN: D3.1 (K), J6.3, J11.3, R13.1, R263.2
FAN2_PWM: R10.1; also elsewhere on the board
FAN2_PWM_PIN: J7.4, J12.4, Q3.3 (D)
FAN2_TACH: D231.3 (COM), R14.2; also elsewhere on the board
FAN2_TACH_PIN: D4.1 (K), J7.3, J12.3, R14.1, R265.2
FAN3_PWM: R11.1; also elsewhere on the board
FAN3_PWM_PIN: J8.4, J13.4, Q4.3 (D)
FAN3_TACH: D232.3 (COM), R15.2; also elsewhere on the board
FAN3_TACH_PIN: D5.1 (K), J8.3, J13.3, R15.1, R267.2
FAN4_PWM: R12.1; also elsewhere on the board
FAN4_PWM_PIN: J9.4, J14.4, Q5.3 (D)
FAN4_TACH: D233.3 (COM), R16.2; also elsewhere on the board
FAN4_TACH_PIN: D6.1 (K), J9.3, J14.3, R16.1, R269.2
GND: C289.2, C290.2, D3.2 (A), D4.2 (A), D5.2 (A), D6.2 (A), D230.1 (A), D231.1 (A), D232.1 (A), D233.1 (A), J6.1, J7.1, J8.1, J9.1, J11.1, J12.1, J13.1, J14.1, Q2.2 (S), Q3.2 (S), Q4.2 (S), Q5.2 (S), R262.2, R264.2, R266.2, R268.2; also elsewhere on the board
unnamed: Q2.1 (G), R9.2, R262.1
unnamed: Q3.1 (G), R10.2, R264.1
unnamed: Q4.1 (G), R11.2, R266.1
unnamed: Q5.1 (G), R12.2, R268.1

Notes on the sheet:
Fan 4 - fit one connector option
Tach pull-up is before the 10k series resistor. Disable GPIO internal pulls; use GPIO edge counters.
Firmware watchdog must restore safe fan / PSU state; hardware does not detect stalled userspace.
Fan interfaces
PWM is inverted: GPIO low / reset -> NMOS off -> fan input open -> full speed. Set Linux polarity accordingly.
Fan 2 - fit one connector option
Fan 1 - fit one connector option
Fan 3 - fit one connector option

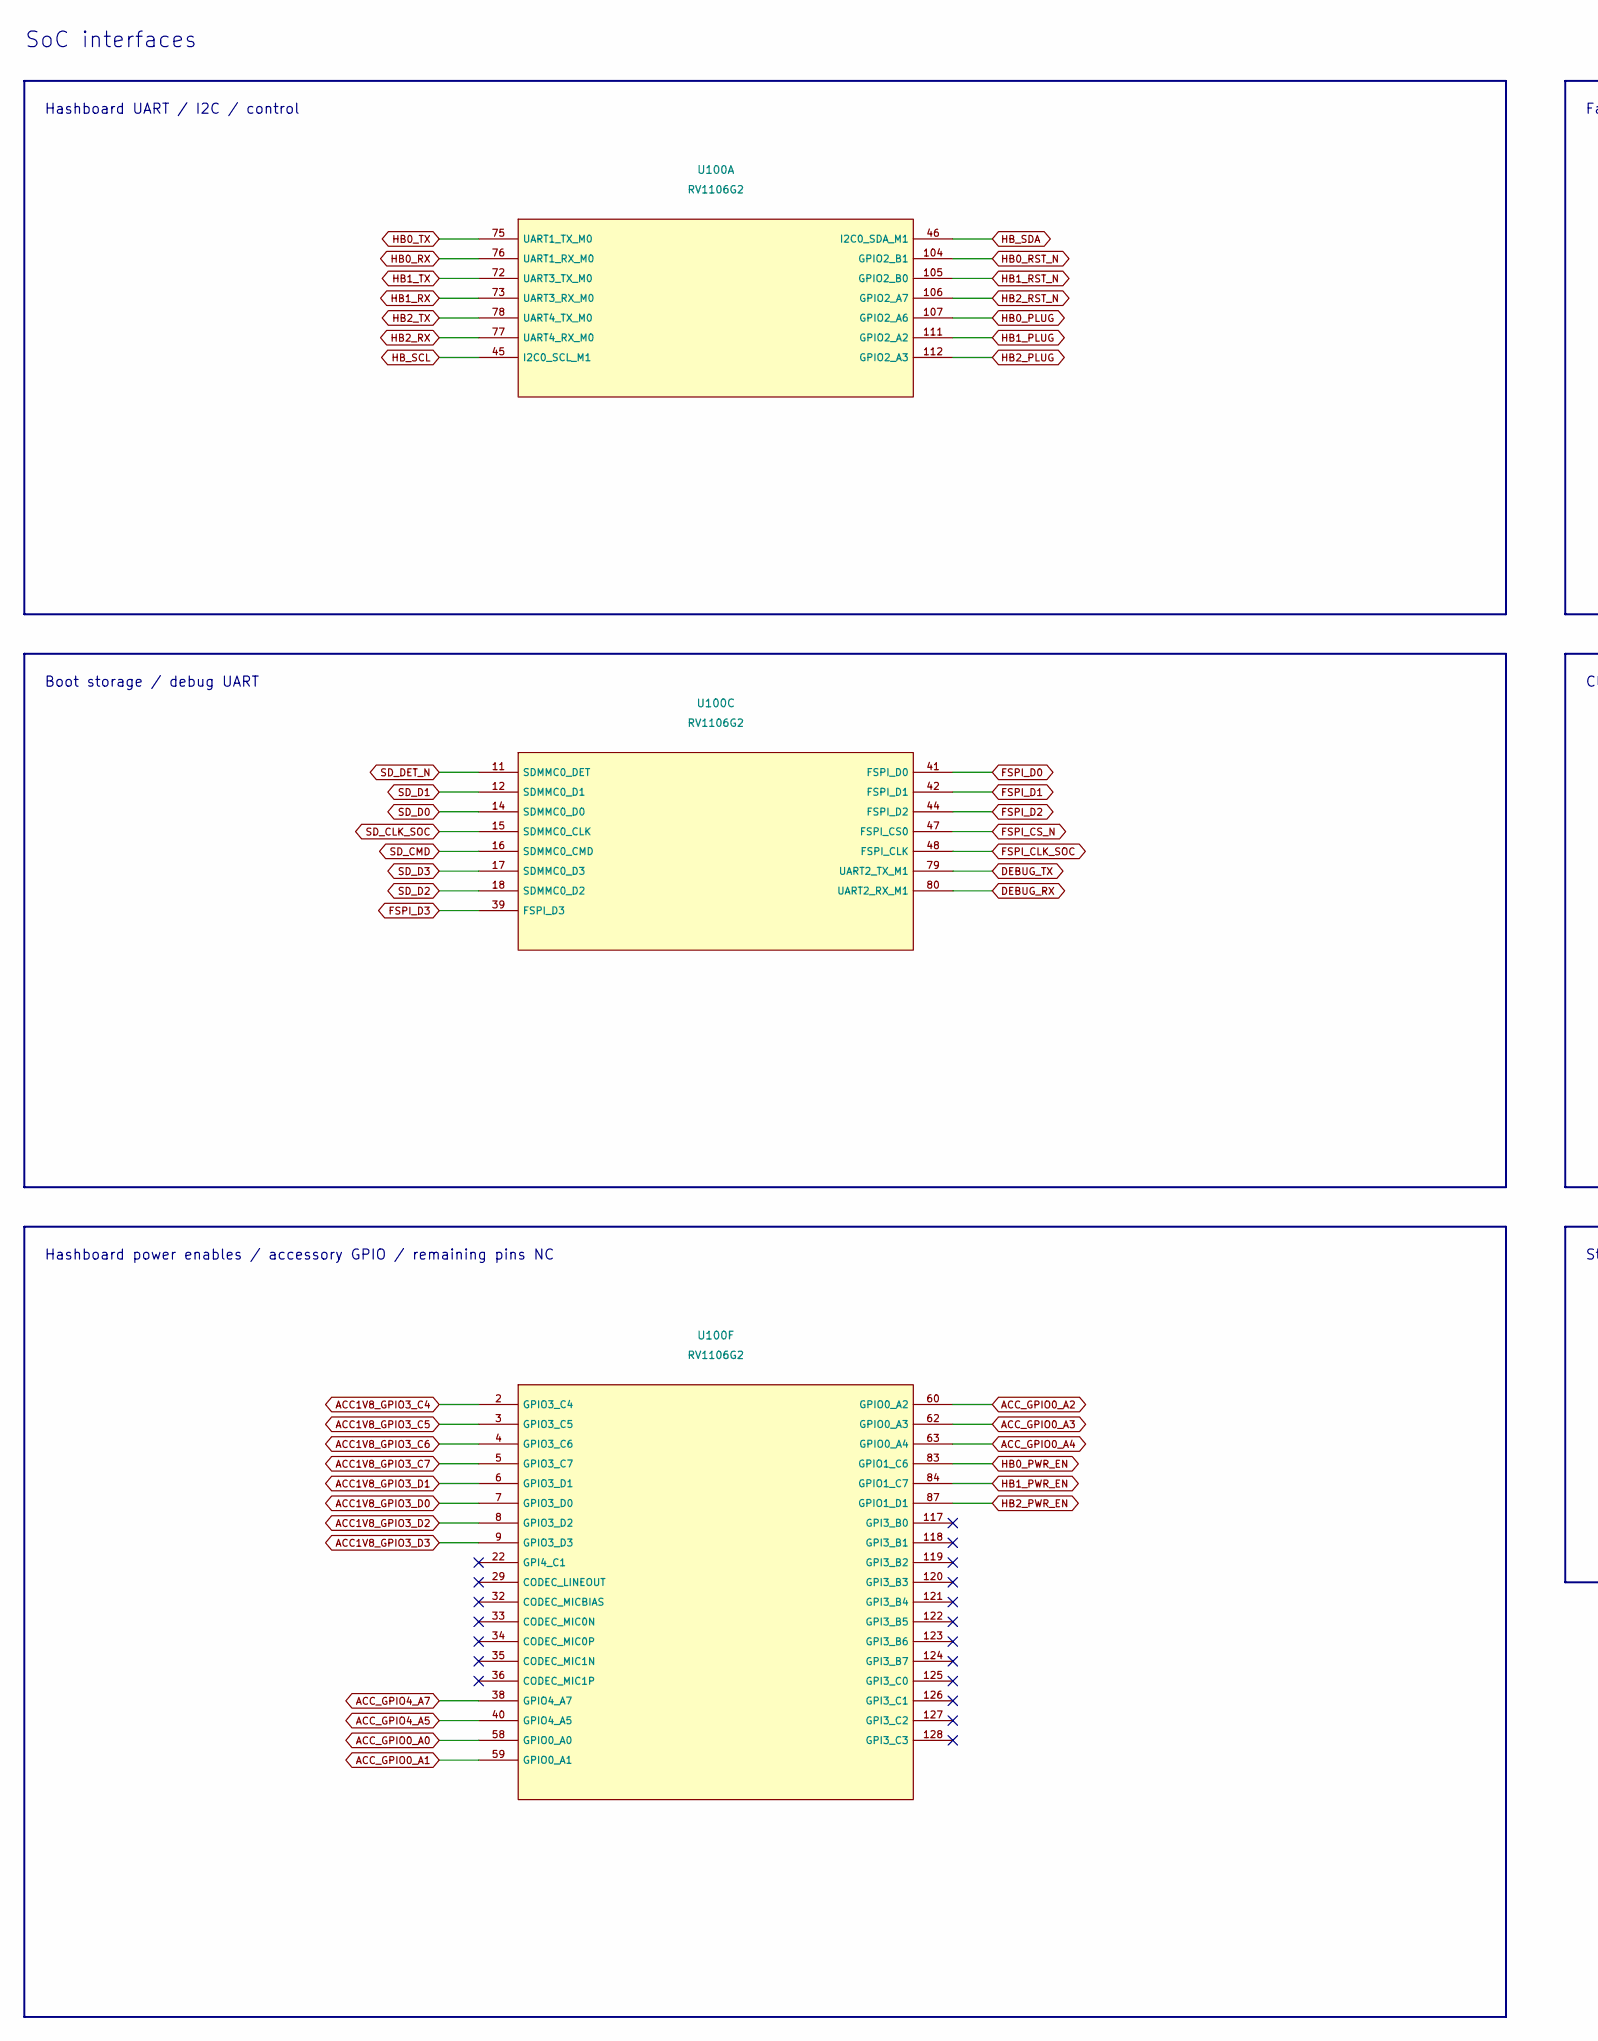
[picture p41: schematic 01_soc.kicad_sch, MujinaControl-S19 / SoC interfaces, part in row 1, column 1]

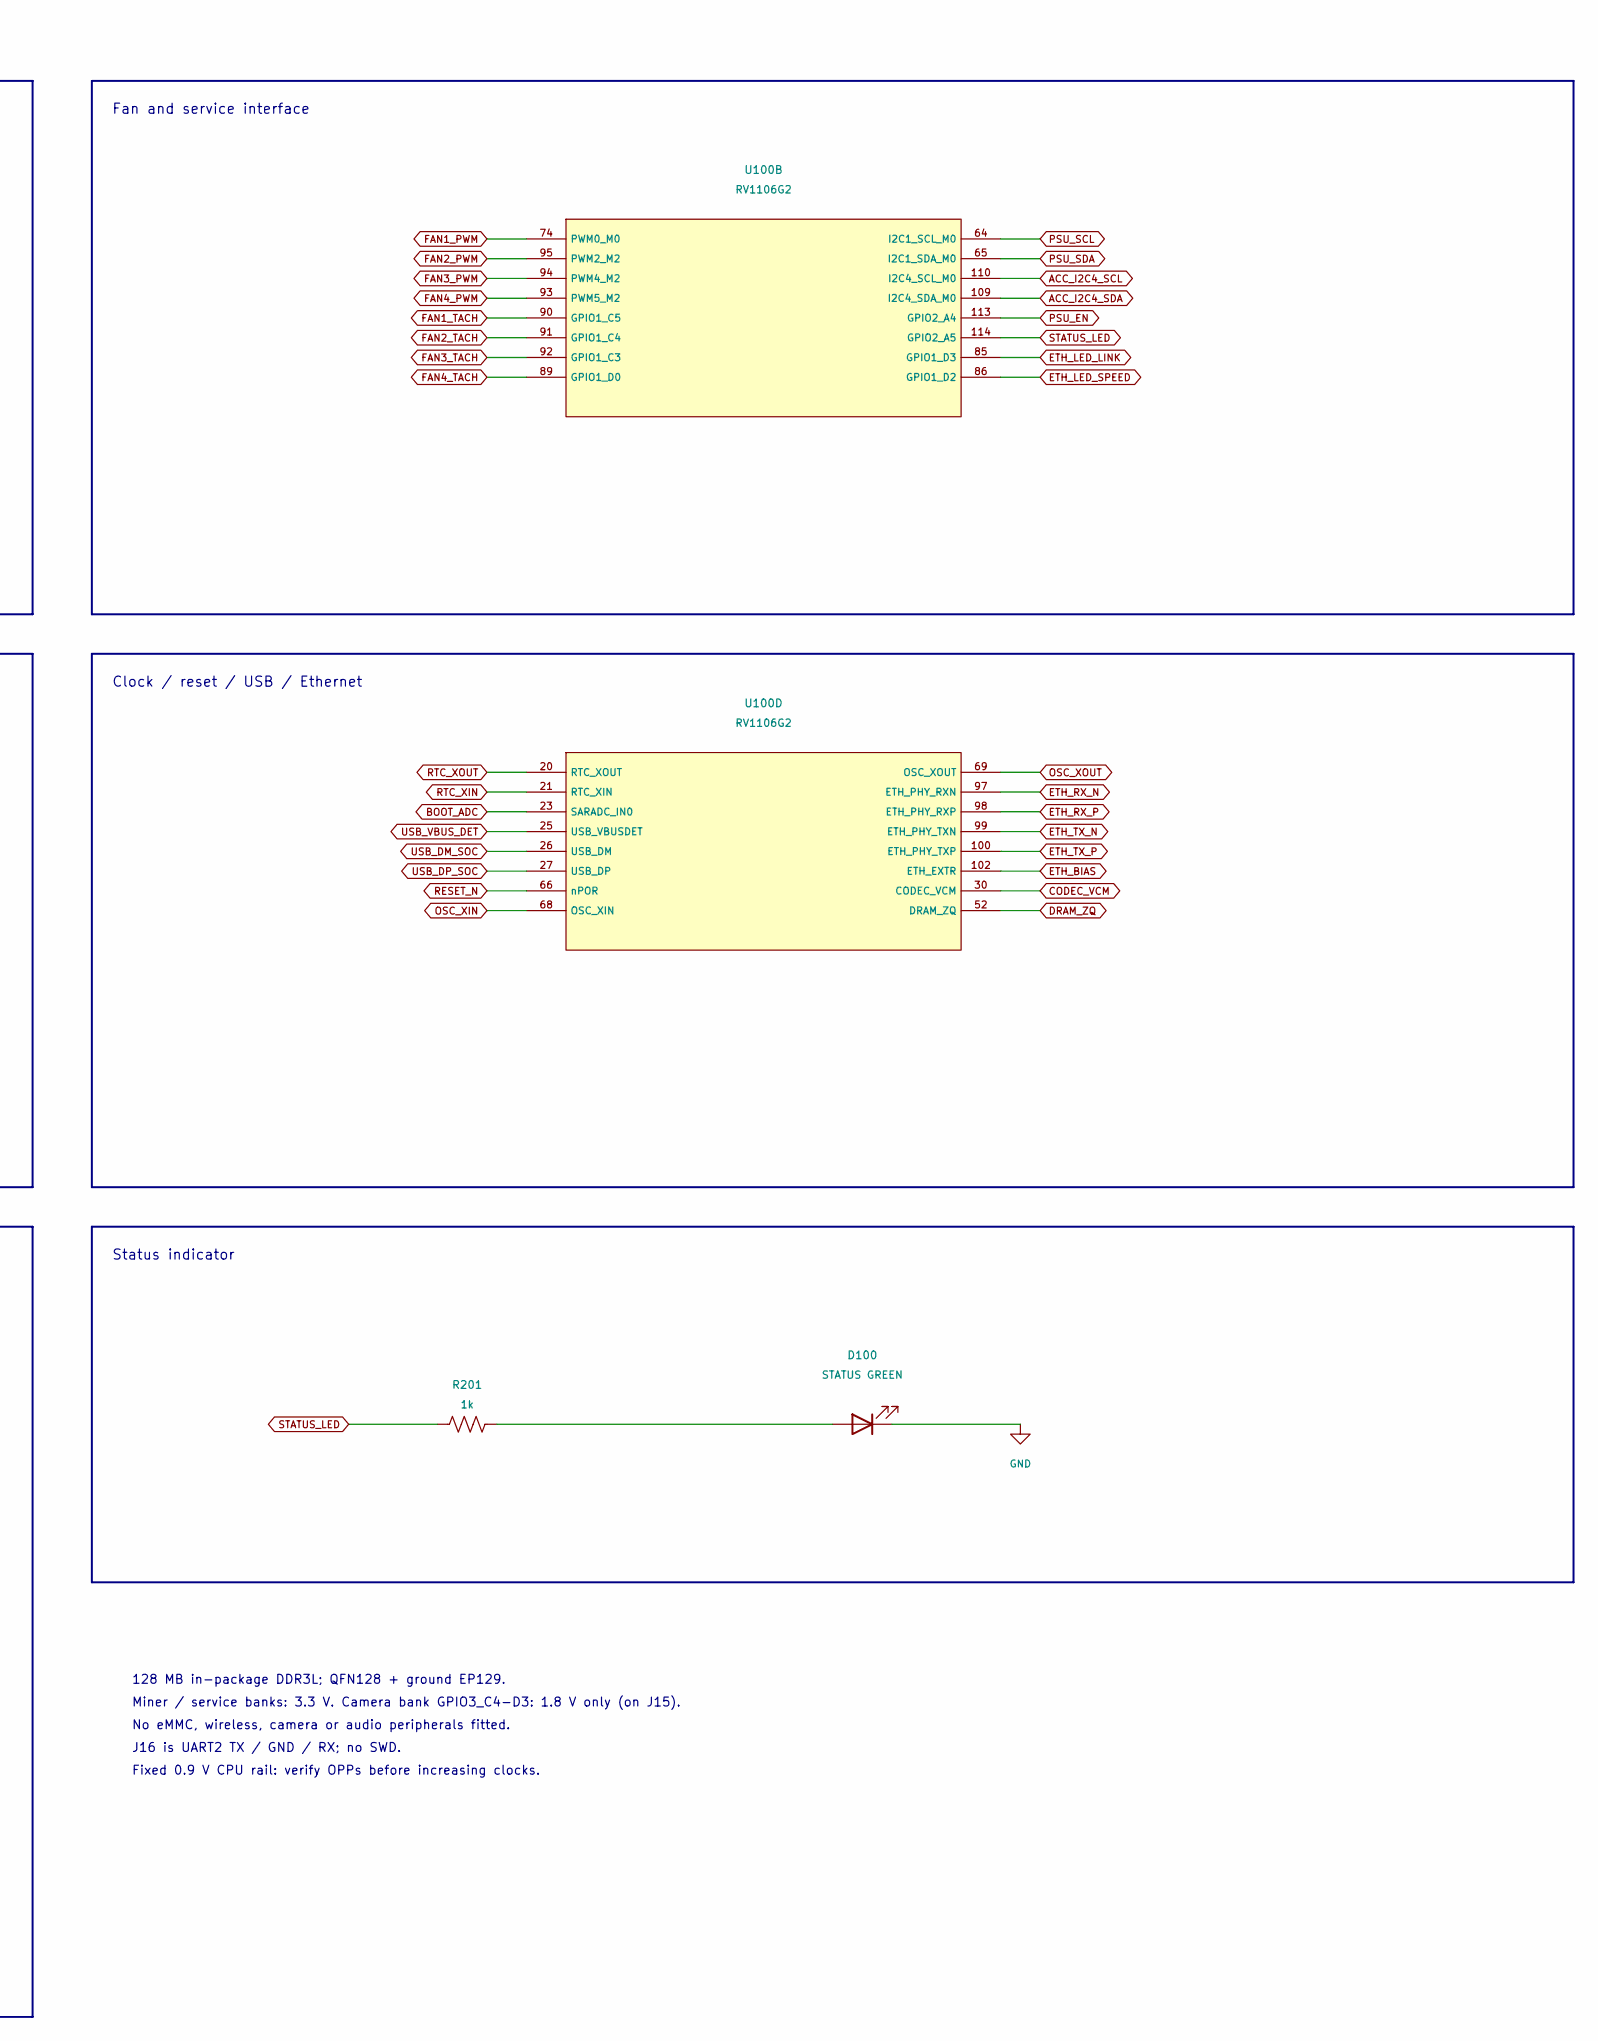
[picture p42: schematic 01_soc.kicad_sch, MujinaControl-S19 / SoC interfaces, part in row 1, column 2]

Parts:
D100: STATUS GREEN; LED_0603_1608Metric; MPN LTST-C190KGKT; LCSC C125094
R201: 1k; R_0402_1005Metric; MPN 0402WGF1001TCE; LCSC C11702
U100: RV1106G2; Rockchip_QFN-128-1EP_12.3x12.3mm_P0.35mm_EP7x7mm; MPN RV1106G2; LCSC C5272606

Connections:
ACC1V8_GPIO3_C4: U100.2 (GPIO3_C4); also elsewhere on the board
ACC1V8_GPIO3_C5: U100.3 (GPIO3_C5); also elsewhere on the board
ACC1V8_GPIO3_C6: U100.4 (GPIO3_C6); also elsewhere on the board
ACC1V8_GPIO3_C7: U100.5 (GPIO3_C7); also elsewhere on the board
ACC1V8_GPIO3_D0: U100.7 (GPIO3_D0); also elsewhere on the board
ACC1V8_GPIO3_D1: U100.6 (GPIO3_D1); also elsewhere on the board
ACC1V8_GPIO3_D2: U100.8 (GPIO3_D2); also elsewhere on the board
ACC1V8_GPIO3_D3: U100.9 (GPIO3_D3); also elsewhere on the board
ACC_GPIO0_A0: U100.58 (GPIO0_A0); also elsewhere on the board
ACC_GPIO0_A1: U100.59 (GPIO0_A1); also elsewhere on the board
ACC_GPIO0_A2: U100.60 (GPIO0_A2); also elsewhere on the board
ACC_GPIO0_A3: U100.62 (GPIO0_A3); also elsewhere on the board
ACC_GPIO0_A4: U100.63 (GPIO0_A4); also elsewhere on the board
ACC_GPIO4_A5: U100.40 (GPIO4_A5); also elsewhere on the board
ACC_GPIO4_A7: U100.38 (GPIO4_A7); also elsewhere on the board
ACC_I2C4_SCL: U100.110 (I2C4_SCL_M0); also elsewhere on the board
ACC_I2C4_SDA: U100.109 (I2C4_SDA_M0); also elsewhere on the board
BOOT_ADC: U100.23 (SARADC_IN0); also elsewhere on the board
CODEC_VCM: U100.30 (CODEC_VCM); also elsewhere on the board
DEBUG_RX: U100.80 (UART2_RX_M1); also elsewhere on the board
DEBUG_TX: U100.79 (UART2_TX_M1); also elsewhere on the board
DRAM_ZQ: U100.52 (DRAM_ZQ); also elsewhere on the board
ETH_BIAS: U100.102 (ETH_EXTR); also elsewhere on the board
ETH_LED_LINK: U100.85 (GPIO1_D3); also elsewhere on the board
ETH_LED_SPEED: U100.86 (GPIO1_D2); also elsewhere on the board
ETH_RX_N: U100.97 (ETH_PHY_RXN); also elsewhere on the board
ETH_RX_P: U100.98 (ETH_PHY_RXP); also elsewhere on the board
ETH_TX_N: U100.99 (ETH_PHY_TXN); also elsewhere on the board
ETH_TX_P: U100.100 (ETH_PHY_TXP); also elsewhere on the board
FAN1_PWM: U100.74 (PWM0_M0); also elsewhere on the board
FAN1_TACH: U100.90 (GPIO1_C5); also elsewhere on the board
FAN2_PWM: U100.95 (PWM2_M2); also elsewhere on the board
FAN2_TACH: U100.91 (GPIO1_C4); also elsewhere on the board
FAN3_PWM: U100.94 (PWM4_M2); also elsewhere on the board
FAN3_TACH: U100.92 (GPIO1_C3); also elsewhere on the board
FAN4_PWM: U100.93 (PWM5_M2); also elsewhere on the board
FAN4_TACH: U100.89 (GPIO1_D0); also elsewhere on the board
FSPI_CLK_SOC: U100.48 (FSPI_CLK); also elsewhere on the board
FSPI_CS_N: U100.47 (FSPI_CS0); also elsewhere on the board
FSPI_D0: U100.41 (FSPI_D0); also elsewhere on the board
FSPI_D1: U100.42 (FSPI_D1); also elsewhere on the board
FSPI_D2: U100.44 (FSPI_D2); also elsewhere on the board
FSPI_D3: U100.39 (FSPI_D3); also elsewhere on the board
GND: D100.1 (K); also elsewhere on the board
HB0_PLUG: U100.107 (GPIO2_A6); also elsewhere on the board
HB0_PWR_EN: U100.83 (GPIO1_C6); also elsewhere on the board
HB0_RST_N: U100.104 (GPIO2_B1); also elsewhere on the board
HB0_RX: U100.76 (UART1_RX_M0); also elsewhere on the board
HB0_TX: U100.75 (UART1_TX_M0); also elsewhere on the board
HB1_PLUG: U100.111 (GPIO2_A2); also elsewhere on the board
HB1_PWR_EN: U100.84 (GPIO1_C7); also elsewhere on the board
HB1_RST_N: U100.105 (GPIO2_B0); also elsewhere on the board
HB1_RX: U100.73 (UART3_RX_M0); also elsewhere on the board
HB1_TX: U100.72 (UART3_TX_M0); also elsewhere on the board
HB2_PLUG: U100.112 (GPIO2_A3); also elsewhere on the board
HB2_PWR_EN: U100.87 (GPIO1_D1); also elsewhere on the board
HB2_RST_N: U100.106 (GPIO2_A7); also elsewhere on the board
HB2_RX: U100.77 (UART4_RX_M0); also elsewhere on the board
HB2_TX: U100.78 (UART4_TX_M0); also elsewhere on the board
HB_SCL: U100.45 (I2C0_SCL_M1); also elsewhere on the board
HB_SDA: U100.46 (I2C0_SDA_M1); also elsewhere on the board
unnamed: D100.2 (A), R201.2
OSC_XIN: U100.68 (OSC_XIN); also elsewhere on the board
OSC_XOUT: U100.69 (OSC_XOUT); also elsewhere on the board
PSU_EN: U100.113 (GPIO2_A4); also elsewhere on the board
PSU_SCL: U100.64 (I2C1_SCL_M0); also elsewhere on the board
PSU_SDA: U100.65 (I2C1_SDA_M0); also elsewhere on the board
RESET_N: U100.66 (nPOR); also elsewhere on the board
RTC_XIN: U100.21 (RTC_XIN); also elsewhere on the board
RTC_XOUT: U100.20 (RTC_XOUT); also elsewhere on the board
SD_CLK_SOC: U100.15 (SDMMC0_CLK); also elsewhere on the board
SD_CMD: U100.16 (SDMMC0_CMD); also elsewhere on the board
SD_D0: U100.14 (SDMMC0_D0); also elsewhere on the board
SD_D1: U100.12 (SDMMC0_D1); also elsewhere on the board
SD_D2: U100.18 (SDMMC0_D2); also elsewhere on the board
SD_D3: U100.17 (SDMMC0_D3); also elsewhere on the board
SD_DET_N: U100.11 (SDMMC0_DET); also elsewhere on the board
STATUS_LED: R201.1, U100.114 (GPIO2_A5)
USB_DM_SOC: U100.26 (USB_DM); also elsewhere on the board
USB_DP_SOC: U100.27 (USB_DP); also elsewhere on the board
USB_VBUS_DET: U100.25 (USB_VBUSDET); also elsewhere on the board

Notes on the sheet:
Clock / reset / USB / Ethernet
Status indicator
Fixed 0.9 V CPU rail: verify OPPs before increasing clocks.
Miner / service banks: 3.3 V. Camera bank GPIO3_C4-D3: 1.8 V only (on J15).
Hashboard UART / I2C / control
No eMMC, wireless, camera or audio peripherals fitted.
Boot storage / debug UART
Hashboard power enables / accessory GPIO / remaining pins NC
J16 is UART2 TX / GND / RX; no SWD.
Fan and service interface
128 MB in-package DDR3L; QFN128 + ground EP129.
SoC interfaces
