skot/MujinaControl-S19/MujinaControl-S19.kicad_pcb

## KiCad design MujinaControl-S19.kicad_pcb (continued)

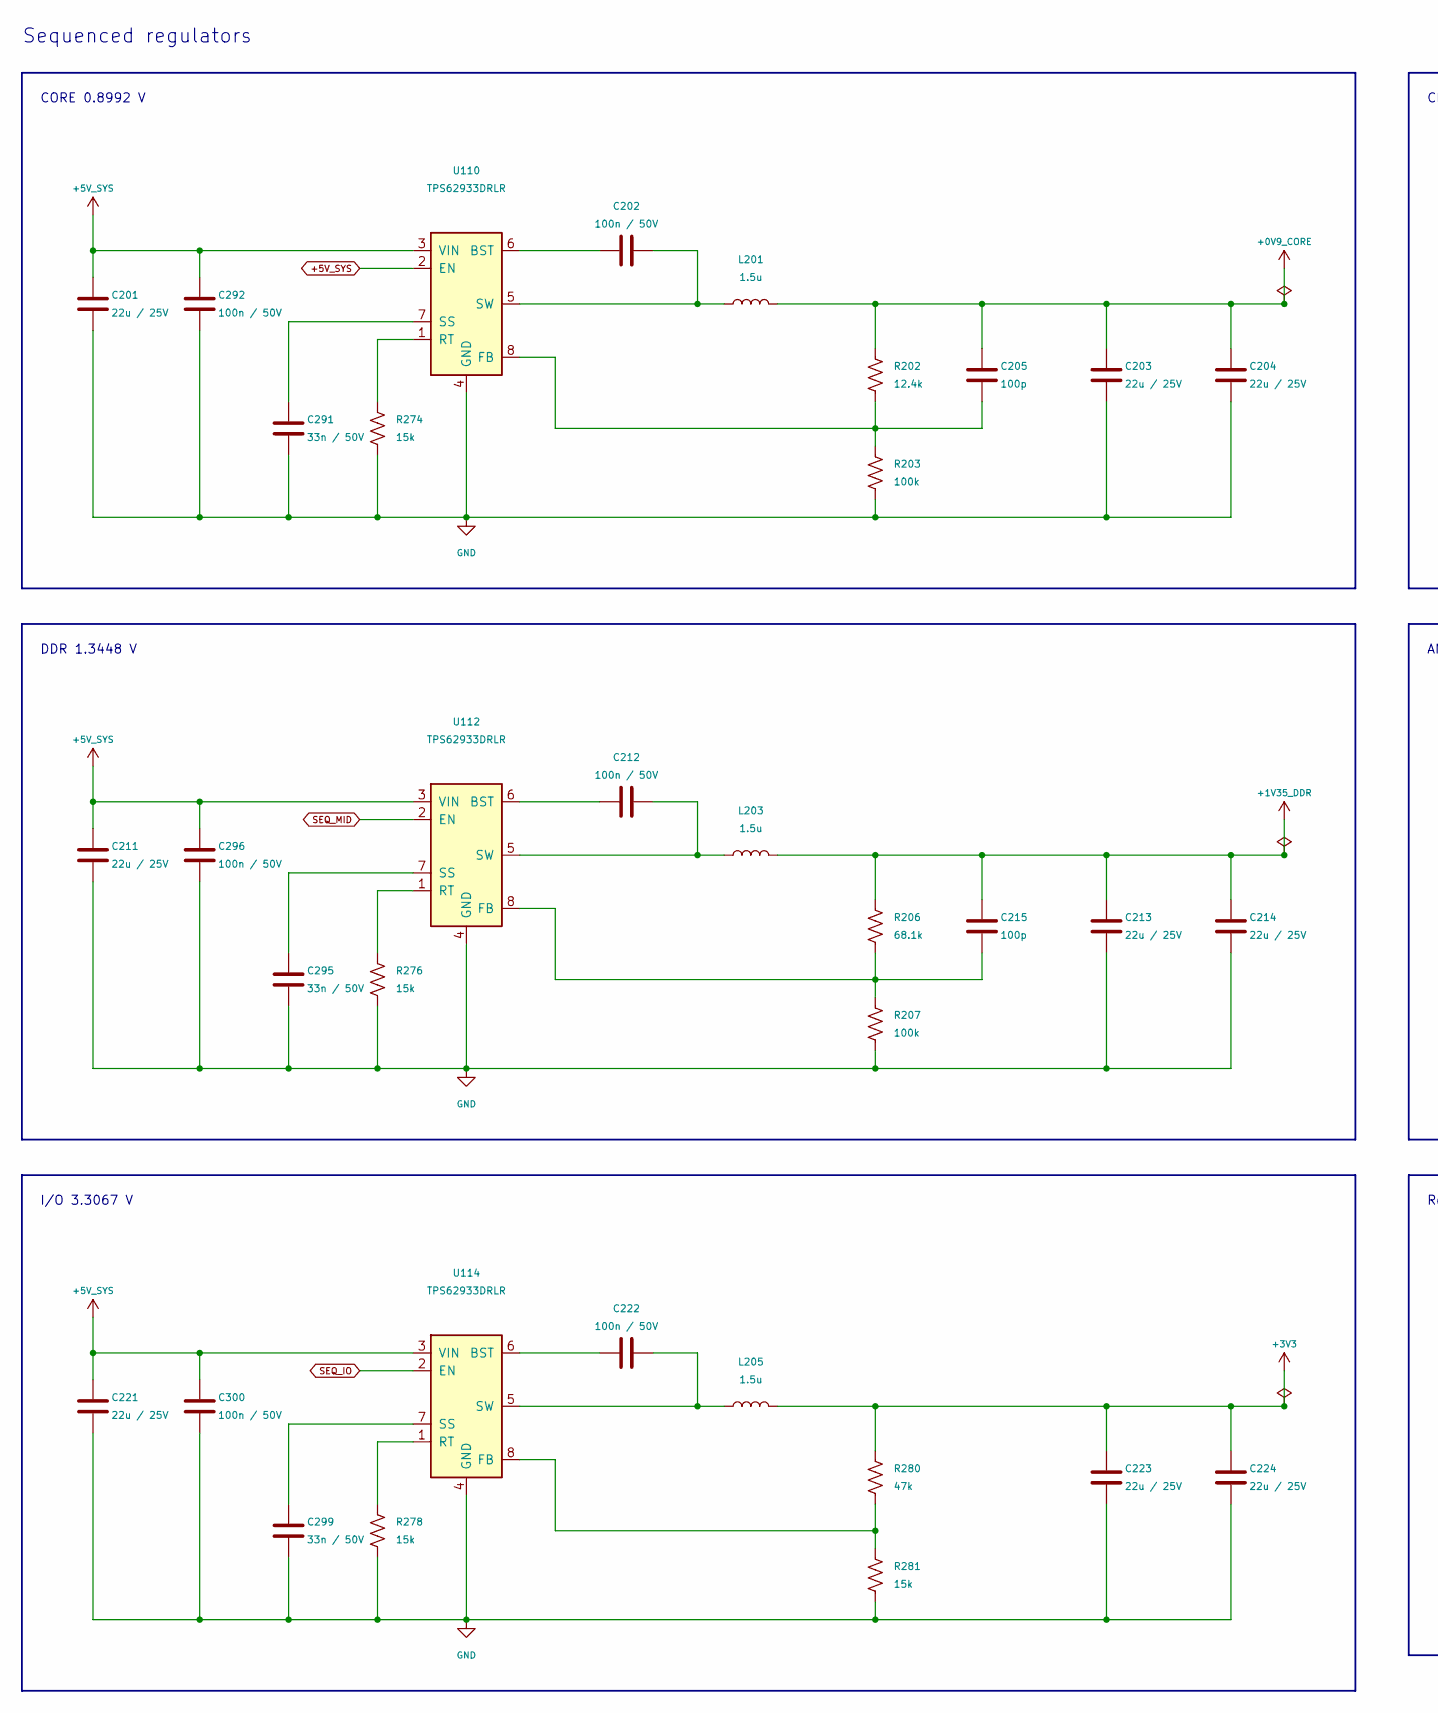
[picture p43: schematic 02_regulators.kicad_sch, MujinaControl-S19 / Sequenced regulators, part in row 1, column 1]

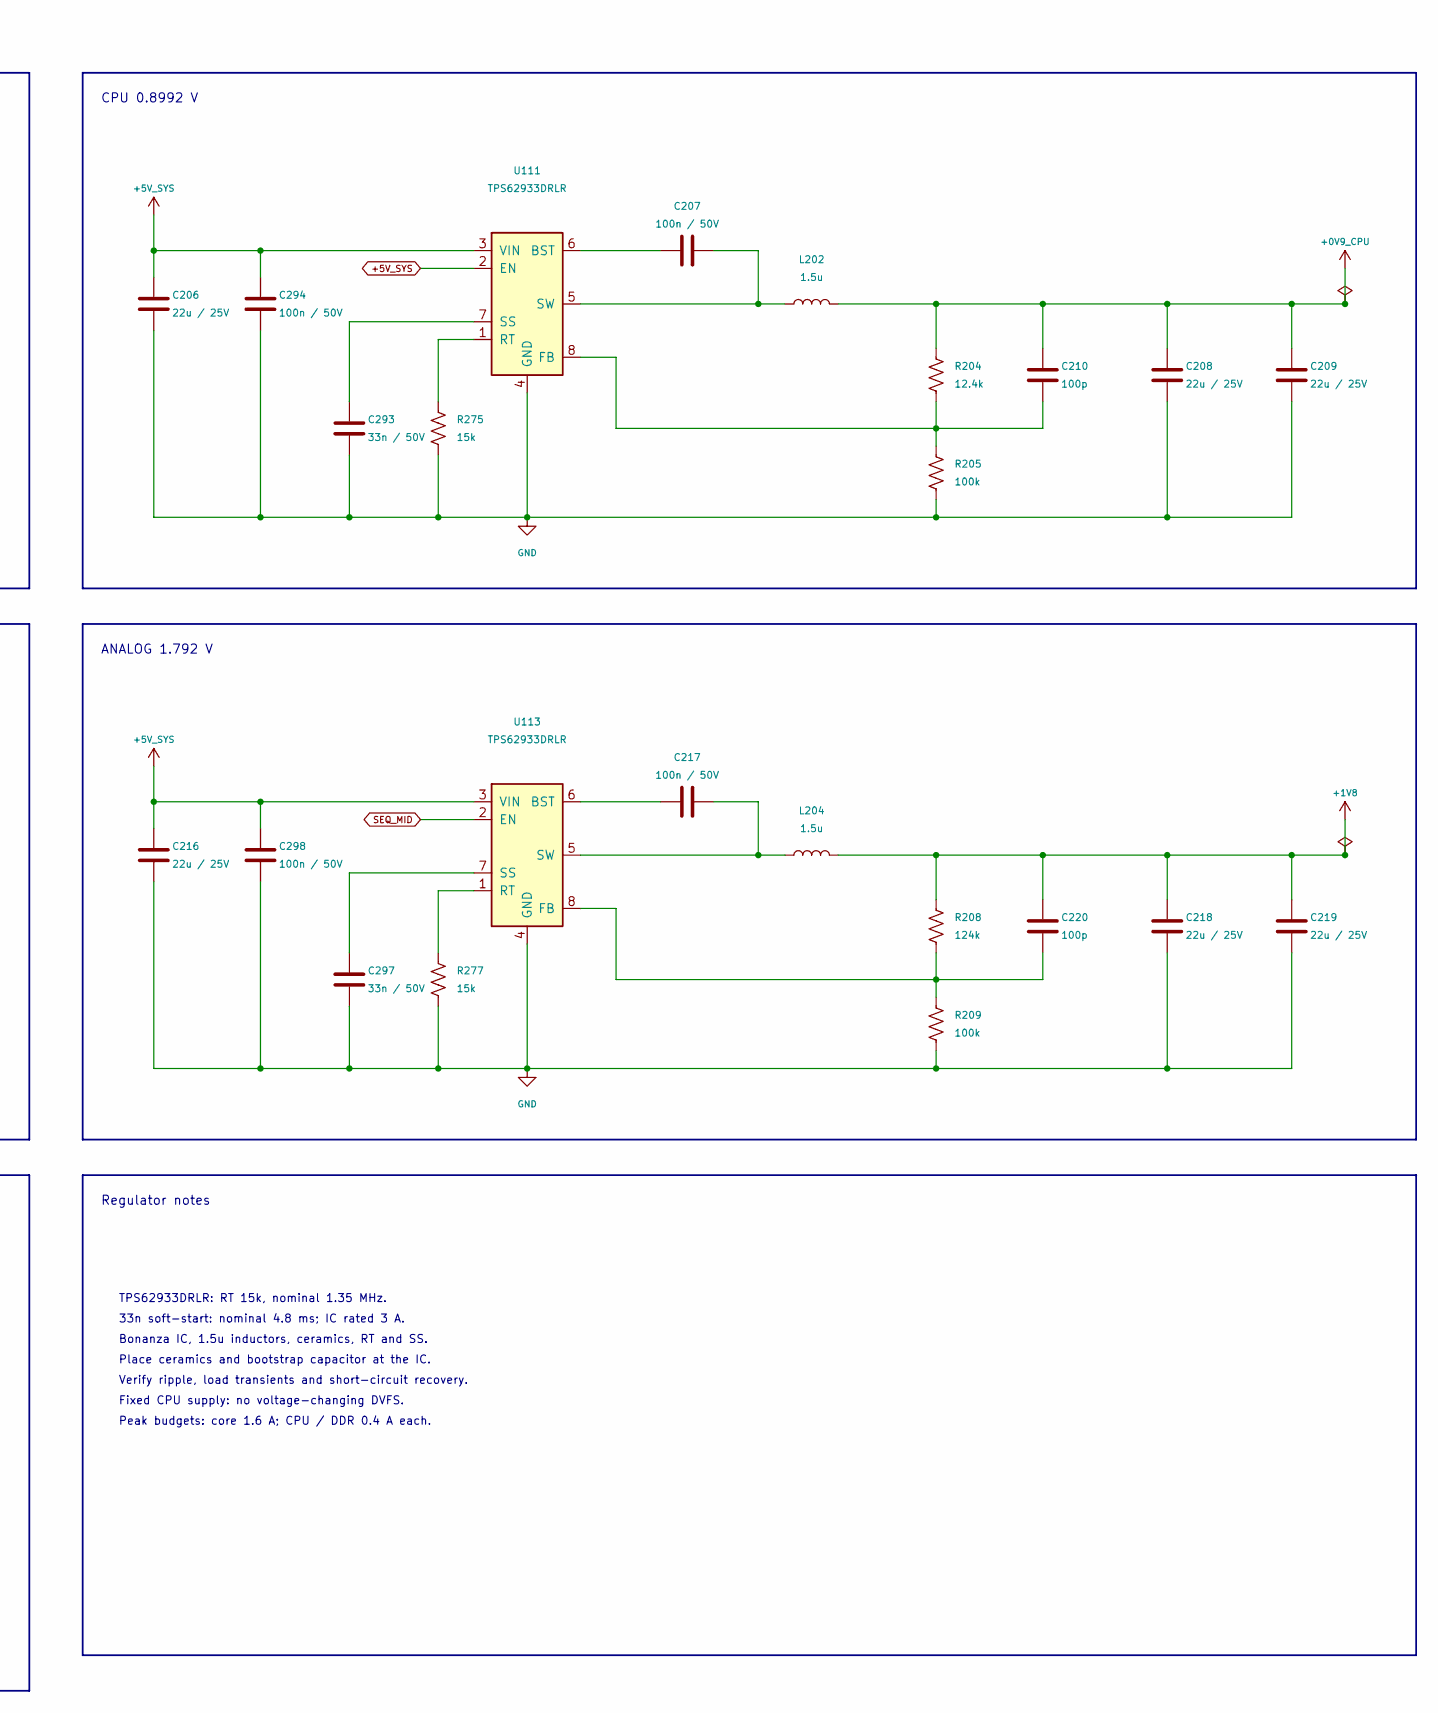
[picture p44: schematic 02_regulators.kicad_sch, MujinaControl-S19 / Sequenced regulators, part in row 1, column 2]

Parts:
C201, C203, C204, C206, C208, C209, C211, C213, C214, C216, C218, C219, C221, C223, C224: 22u / 25V; C_0805_2012Metric; MPN CL21A226MAQNNNE; LCSC C45783
C202, C207, C212, C217, C222, C292, C294, C296, C298, C300: 100n / 50V; C_0402_1005Metric; MPN CL05B104KB54PNC; LCSC C307331
C205, C210, C215, C220: 100p; C_0402_1005Metric; MPN 0402CG101J500NT; LCSC C1546
C291, C293, C295, C297, C299: 33n / 50V; C_0603_1608Metric; MPN CL10B333KB8NNNC; LCSC C21117
L201, L202, L203, L204, L205: 1.5u; IND-SMD_L2.0-W1.6; MPN FTC201612S1R5MBCA; LCSC C5832350
R202, R204: 12.4k; R_0402_1005Metric; MPN RC0402FR-0712K4L; LCSC C138060
R203, R205, R207, R209: 100k; R_0402_1005Metric; MPN 0402WGF1003TCE; LCSC C25741
R206: 68.1k; R_0402_1005Metric; MPN RC0402FR-0768K1L; LCSC C276276
R208: 124k; R_0402_1005Metric; MPN 0402WGF1243TCE; LCSC C36777
R274, R275, R276, R277, R278, R281: 15k; R_0402_1005Metric; MPN 0402WGF1502TCE; LCSC C25756
R280: 47k; R_0402_1005Metric; MPN 0402WGF4702TCE; LCSC C25792
U110, U111, U112, U113, U114: TPS62933DRLR; SOT-583-8_L2.1-W1.2-P0.50-LS1.6-BR; MPN TPS62933DRLR; LCSC C3200405

Connections:
+0V9_CORE: C203.1, C204.1, C205.1, L201.2, R202.1; also elsewhere on the board
+0V9_CPU: C208.1, C209.1, C210.1, L202.2, R204.1; also elsewhere on the board
+1V8: C218.1, C219.1, C220.1, L204.2, R208.1; also elsewhere on the board
+1V35_DDR: C213.1, C214.1, C215.1, L203.2, R206.1; also elsewhere on the board
+3V3: C223.1, C224.1, L205.2, R280.1; also elsewhere on the board
+5V_SYS: C201.1, C206.1, C211.1, C216.1, C221.1, C292.1, C294.1, C296.1, C298.1, C300.1, U110.2 (EN), U110.3 (VIN), U111.2 (EN), U111.3 (VIN), U112.3 (VIN), U113.3 (VIN), U114.3 (VIN); also elsewhere on the board
GND: C201.2, C203.2, C204.2, C206.2, C208.2, C209.2, C211.2, C213.2, C214.2, C216.2, C218.2, C219.2, C221.2, C223.2, C224.2, C291.2, C292.2, C293.2, C294.2, C295.2, C296.2, C297.2, C298.2, C299.2, C300.2, R203.2, R205.2, R207.2, R209.2, R274.2, R275.2, R276.2, R277.2, R278.2, R281.2, U110.4 (GND), U111.4 (GND), U112.4 (GND), U113.4 (GND), U114.4 (GND); also elsewhere on the board
unnamed: C202.1, U110.6 (BST)
unnamed: C205.2, R202.2, R203.1, U110.8 (FB)
unnamed: R274.1, U110.1 (RT)
unnamed: C291.1, U110.7 (SS)
unnamed: C202.2, L201.1, U110.5 (SW)
unnamed: C207.1, U111.6 (BST)
unnamed: C210.2, R204.2, R205.1, U111.8 (FB)
unnamed: R275.1, U111.1 (RT)
unnamed: C293.1, U111.7 (SS)
unnamed: C207.2, L202.1, U111.5 (SW)
unnamed: C212.1, U112.6 (BST)
unnamed: C215.2, R206.2, R207.1, U112.8 (FB)
unnamed: R276.1, U112.1 (RT)
unnamed: C295.1, U112.7 (SS)
unnamed: C212.2, L203.1, U112.5 (SW)
unnamed: C217.1, U113.6 (BST)
unnamed: C220.2, R208.2, R209.1, U113.8 (FB)
unnamed: R277.1, U113.1 (RT)
unnamed: C297.1, U113.7 (SS)
unnamed: C217.2, L204.1, U113.5 (SW)
unnamed: C222.1, U114.6 (BST)
unnamed: R280.2, R281.1, U114.8 (FB)
unnamed: R278.1, U114.1 (RT)
unnamed: C299.1, U114.7 (SS)
unnamed: C222.2, L205.1, U114.5 (SW)
SEQ_IO: U114.2 (EN); also elsewhere on the board
SEQ_MID: U112.2 (EN), U113.2 (EN); also elsewhere on the board

Notes on the sheet:
CPU 0.8992 V
DDR 1.3448 V
Peak budgets: core 1.6 A; CPU / DDR 0.4 A each.
CORE 0.8992 V
Verify ripple, load transients and short-circuit recovery.
ANALOG 1.792 V
Place ceramics and bootstrap capacitor at the IC.
Bonanza IC, 1.5u inductors, ceramics, RT and SS.
Sequenced regulators
I/O 3.3067 V
Fixed CPU supply: no voltage-changing DVFS.
TPS62933DRLR: RT 15k, nominal 1.35 MHz.
Regulator notes
33n soft-start: nominal 4.8 ms; IC rated 3 A.

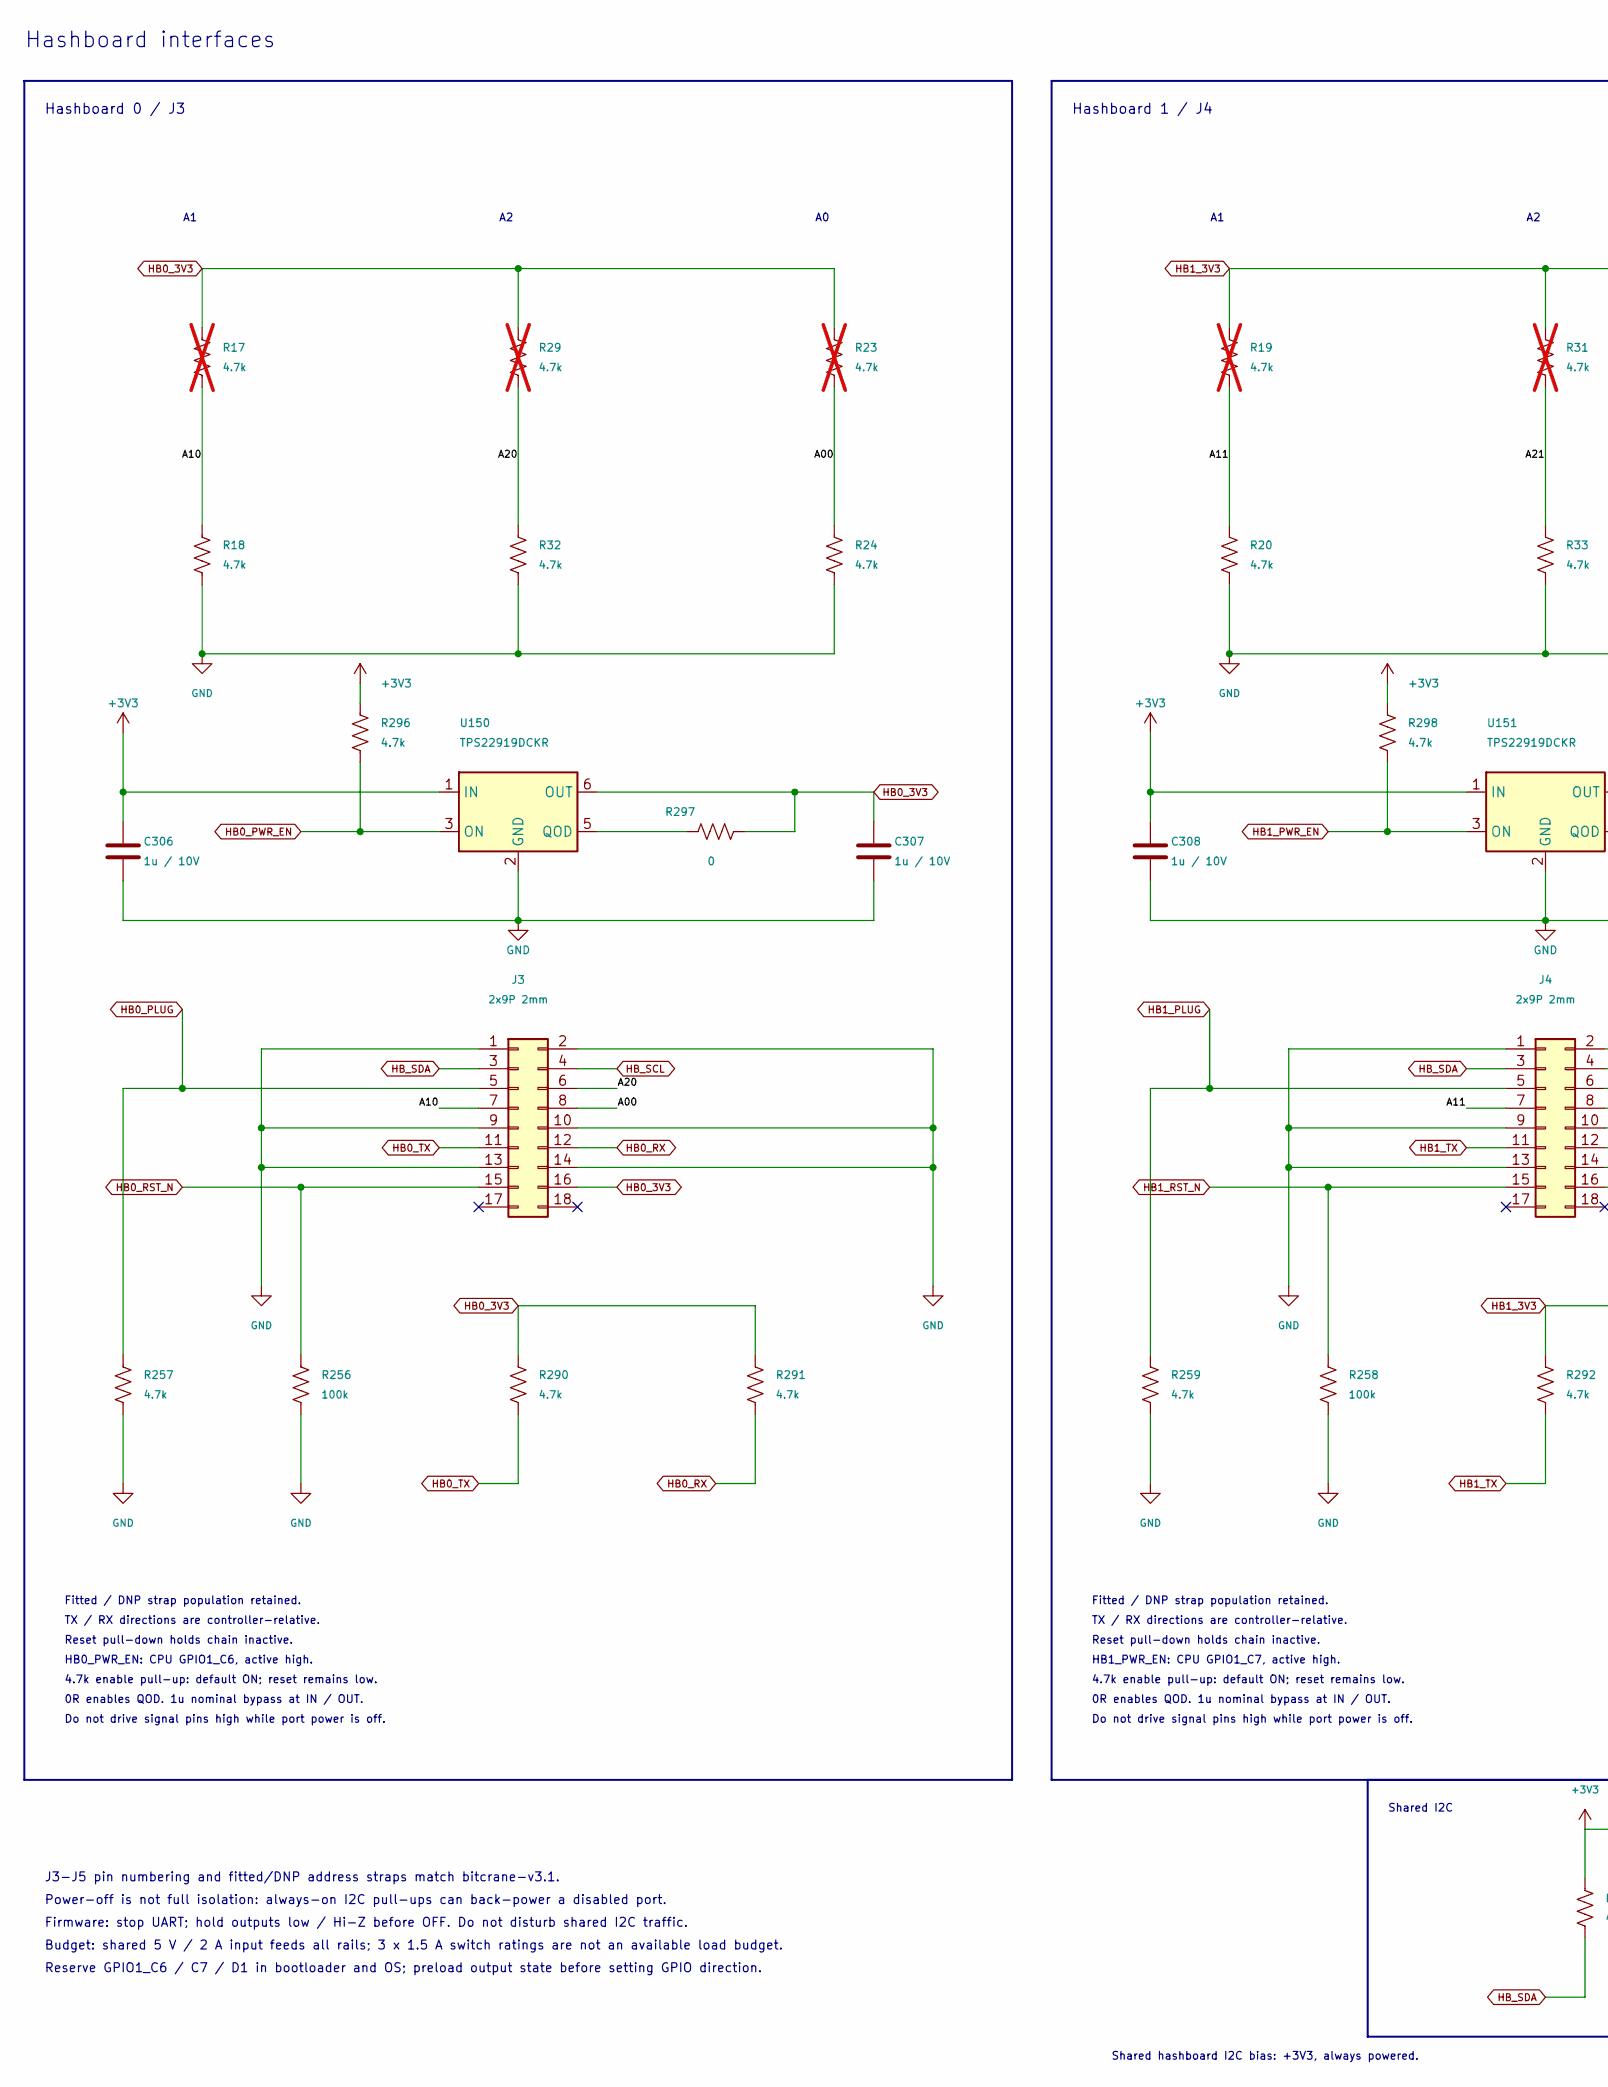
[picture p45: schematic 07_hashboards.kicad_sch, MujinaControl-S19 / Hashboard interfaces, part in row 1, column 1]

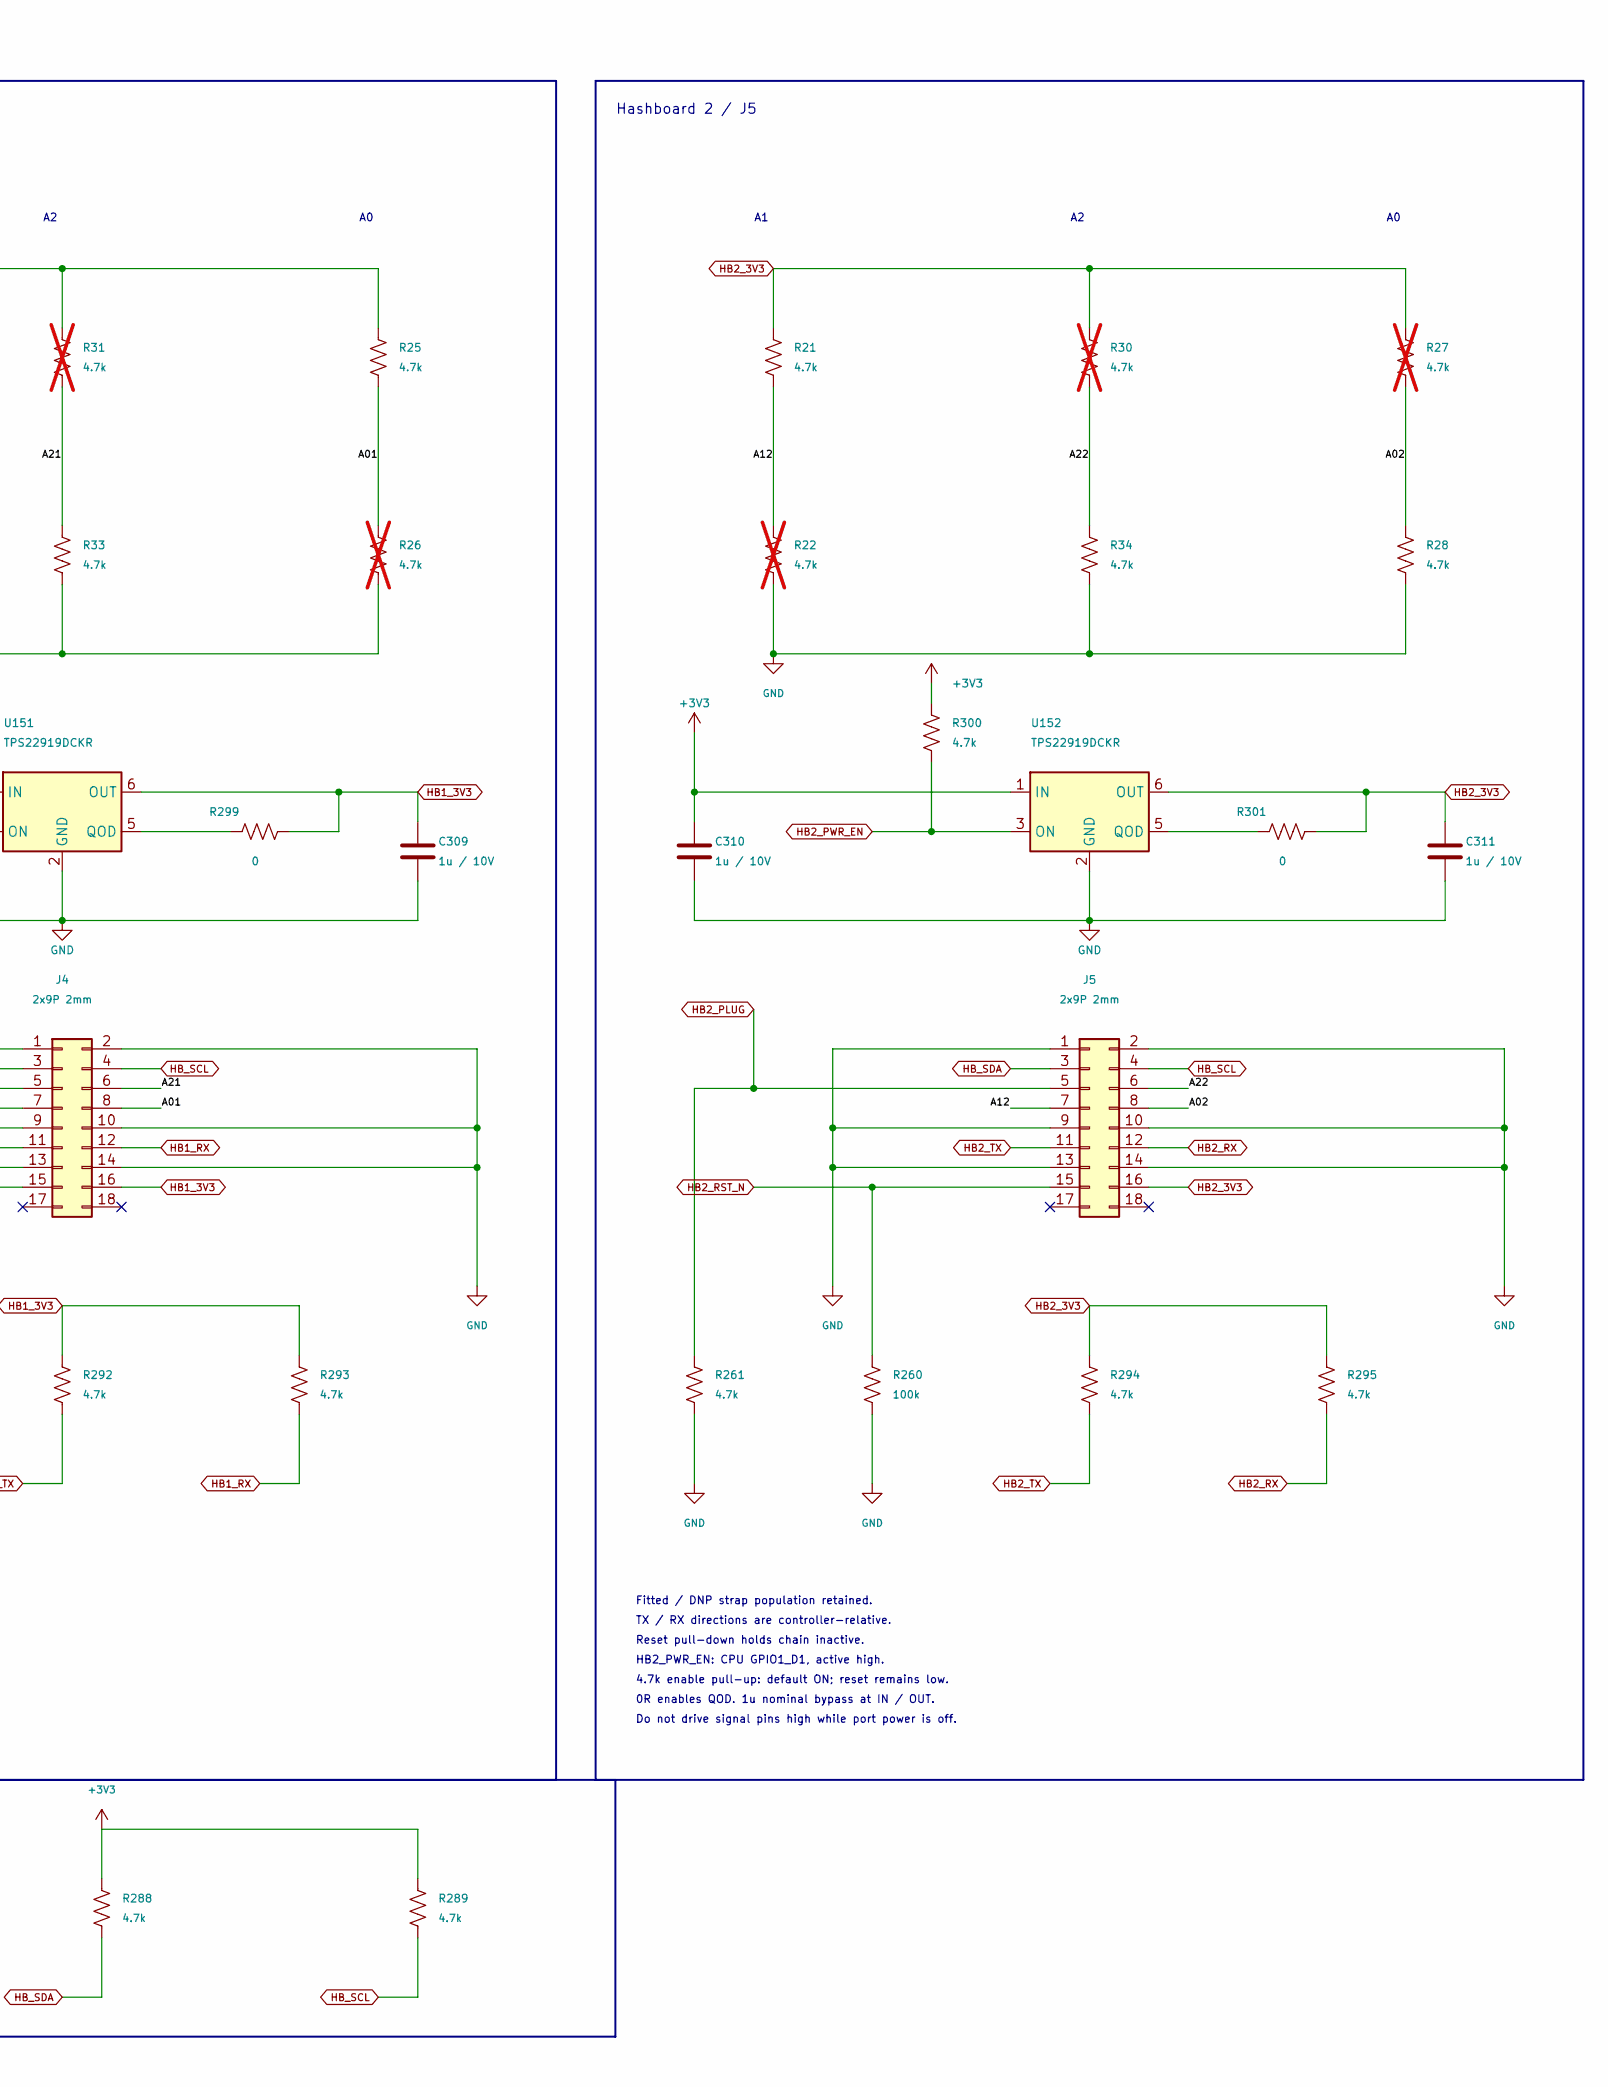
[picture p46: schematic 07_hashboards.kicad_sch, MujinaControl-S19 / Hashboard interfaces, part in row 1, column 2]

Parts:
C306, C307, C308, C309, C310, C311: 1u / 10V; C_0402_1005Metric; MPN CL05A105KA5NQNC; LCSC C52923
J3, J4, J5: 2x9P 2mm; CONN-TH_X2026WV-2-09D-46SN; MPN X2026WV-2x09D-46SN; LCSC C437089
R17, R19, R22, R23, R26, R27, R29, R30, R31: 4.7k; R_0402_1005Metric; MPN 0402WGF4701TCE; LCSC C25900; not fitted
R18, R20, R21, R24, R25, R28, R32, R33, R34, R257, R259, R261, R288, R289, R290, R291, R292, R293, R294, R295, R296, R298, R300: 4.7k; R_0402_1005Metric; MPN 0402WGF4701TCE; LCSC C25900
R256, R258, R260: 100k; R_0402_1005Metric; MPN 0402WGF1003TCE; LCSC C25741
R297, R299, R301: 0; R_0402_1005Metric; MPN 0402WGF0000TCE; LCSC C17168
U150, U151, U152: TPS22919DCKR; SOT-363_SC-70-6; MPN TPS22919DCKR; LCSC C2149796

Connections:
+3V3: C306.1, C308.1, C310.1, R288.1, R289.1, R296.1, R298.1, R300.1, U150.1 (IN), U151.1 (IN), U152.1 (IN); also elsewhere on the board
/Three hashboard interfaces/A00: J3.8, R23.2, R24.1
/Three hashboard interfaces/A01: J4.8, R25.2, R26.1
/Three hashboard interfaces/A02: J5.8, R27.2, R28.1
/Three hashboard interfaces/A10: J3.7, R17.2, R18.1
/Three hashboard interfaces/A11: J4.7, R19.2, R20.1
/Three hashboard interfaces/A12: J5.7, R21.2, R22.1
/Three hashboard interfaces/A20: J3.6, R29.2, R32.1
/Three hashboard interfaces/A21: J4.6, R31.2, R33.1
/Three hashboard interfaces/A22: J5.6, R30.2, R34.1
GND: C306.2, C307.2, C308.2, C309.2, C310.2, C311.2, J3.1, J3.2, J3.9, J3.10, J3.13, J3.14, J4.1, J4.2, J4.9, J4.10, J4.13, J4.14, J5.1, J5.2, J5.9, J5.10, J5.13, J5.14, R18.2, R20.2, R22.2, R24.2, R26.2, R28.2, R32.2, R33.2, R34.2, R256.2, R257.2, R258.2, R259.2, R260.2, R261.2, U150.2 (GND), U151.2 (GND), U152.2 (GND); also elsewhere on the board
HB0_3V3: C307.1, J3.16, R17.1, R23.1, R29.1, R290.1, R291.1, R297.2, U150.6 (OUT)
HB0_PLUG: J3.5, R257.1; also elsewhere on the board
HB0_PWR_EN: R296.2, U150.3 (ON); also elsewhere on the board
HB0_RST_N: J3.15, R256.1; also elsewhere on the board
HB0_RX: J3.12, R291.2; also elsewhere on the board
HB0_TX: J3.11, R290.2; also elsewhere on the board
HB1_3V3: C309.1, J4.16, R19.1, R25.1, R31.1, R292.1, R293.1, R299.2, U151.6 (OUT)
HB1_PLUG: J4.5, R259.1; also elsewhere on the board
HB1_PWR_EN: R298.2, U151.3 (ON); also elsewhere on the board
HB1_RST_N: J4.15, R258.1; also elsewhere on the board
HB1_RX: J4.12, R293.2; also elsewhere on the board
HB1_TX: J4.11, R292.2; also elsewhere on the board
HB2_3V3: C311.1, J5.16, R21.1, R27.1, R30.1, R294.1, R295.1, R301.2, U152.6 (OUT)
HB2_PLUG: J5.5, R261.1; also elsewhere on the board
HB2_PWR_EN: R300.2, U152.3 (ON); also elsewhere on the board
HB2_RST_N: J5.15, R260.1; also elsewhere on the board
HB2_RX: J5.12, R295.2; also elsewhere on the board
HB2_TX: J5.11, R294.2; also elsewhere on the board
HB_SCL: J3.4, J4.4, J5.4, R289.2; also elsewhere on the board
HB_SDA: J3.3, J4.3, J5.3, R288.2; also elsewhere on the board
unnamed: R297.1, U150.5 (QOD)
unnamed: R299.1, U151.5 (QOD)
unnamed: R301.1, U152.5 (QOD)

Notes on the sheet:
Fitted / DNP strap population retained.
Hashboard 1 / J4
Reset pull-down holds chain inactive.
HB0_PWR_EN: CPU GPIO1_C6, active high.
Power-off is not full isolation: always-on I2C pull-ups can back-power a disabled port.
TX / RX directions are controller-relative.
Do not drive signal pins high while port power is off.
HB1_PWR_EN: CPU GPIO1_C7, active high.
J3-J5 pin numbering and fitted/DNP address straps match bitcrane-v3.1.
4.7k enable pull-up: default ON; reset remains low.
0R enables QOD. 1u nominal bypass at IN / OUT.
Hashboard 0 / J3
Shared I2C
Hashboard 2 / J5
Hashboard interfaces
HB2_PWR_EN: CPU GPIO1_D1, active high.
Budget: shared 5 V / 2 A input feeds all rails; 3 x 1.5 A switch ratings are not an available load budget.
Reserve GPIO1_C6 / C7 / D1 in bootloader and OS; preload output state before setting GPIO direction.
Firmware: stop UART; hold outputs low / Hi-Z before OFF. Do not disturb shared I2C traffic.
Shared hashboard I2C bias: +3V3, always powered.
