skot/MujinaControl-S19/MujinaControl-S19.kicad_pcb

## KiCad design MujinaControl-S19.kicad_pcb (continued)

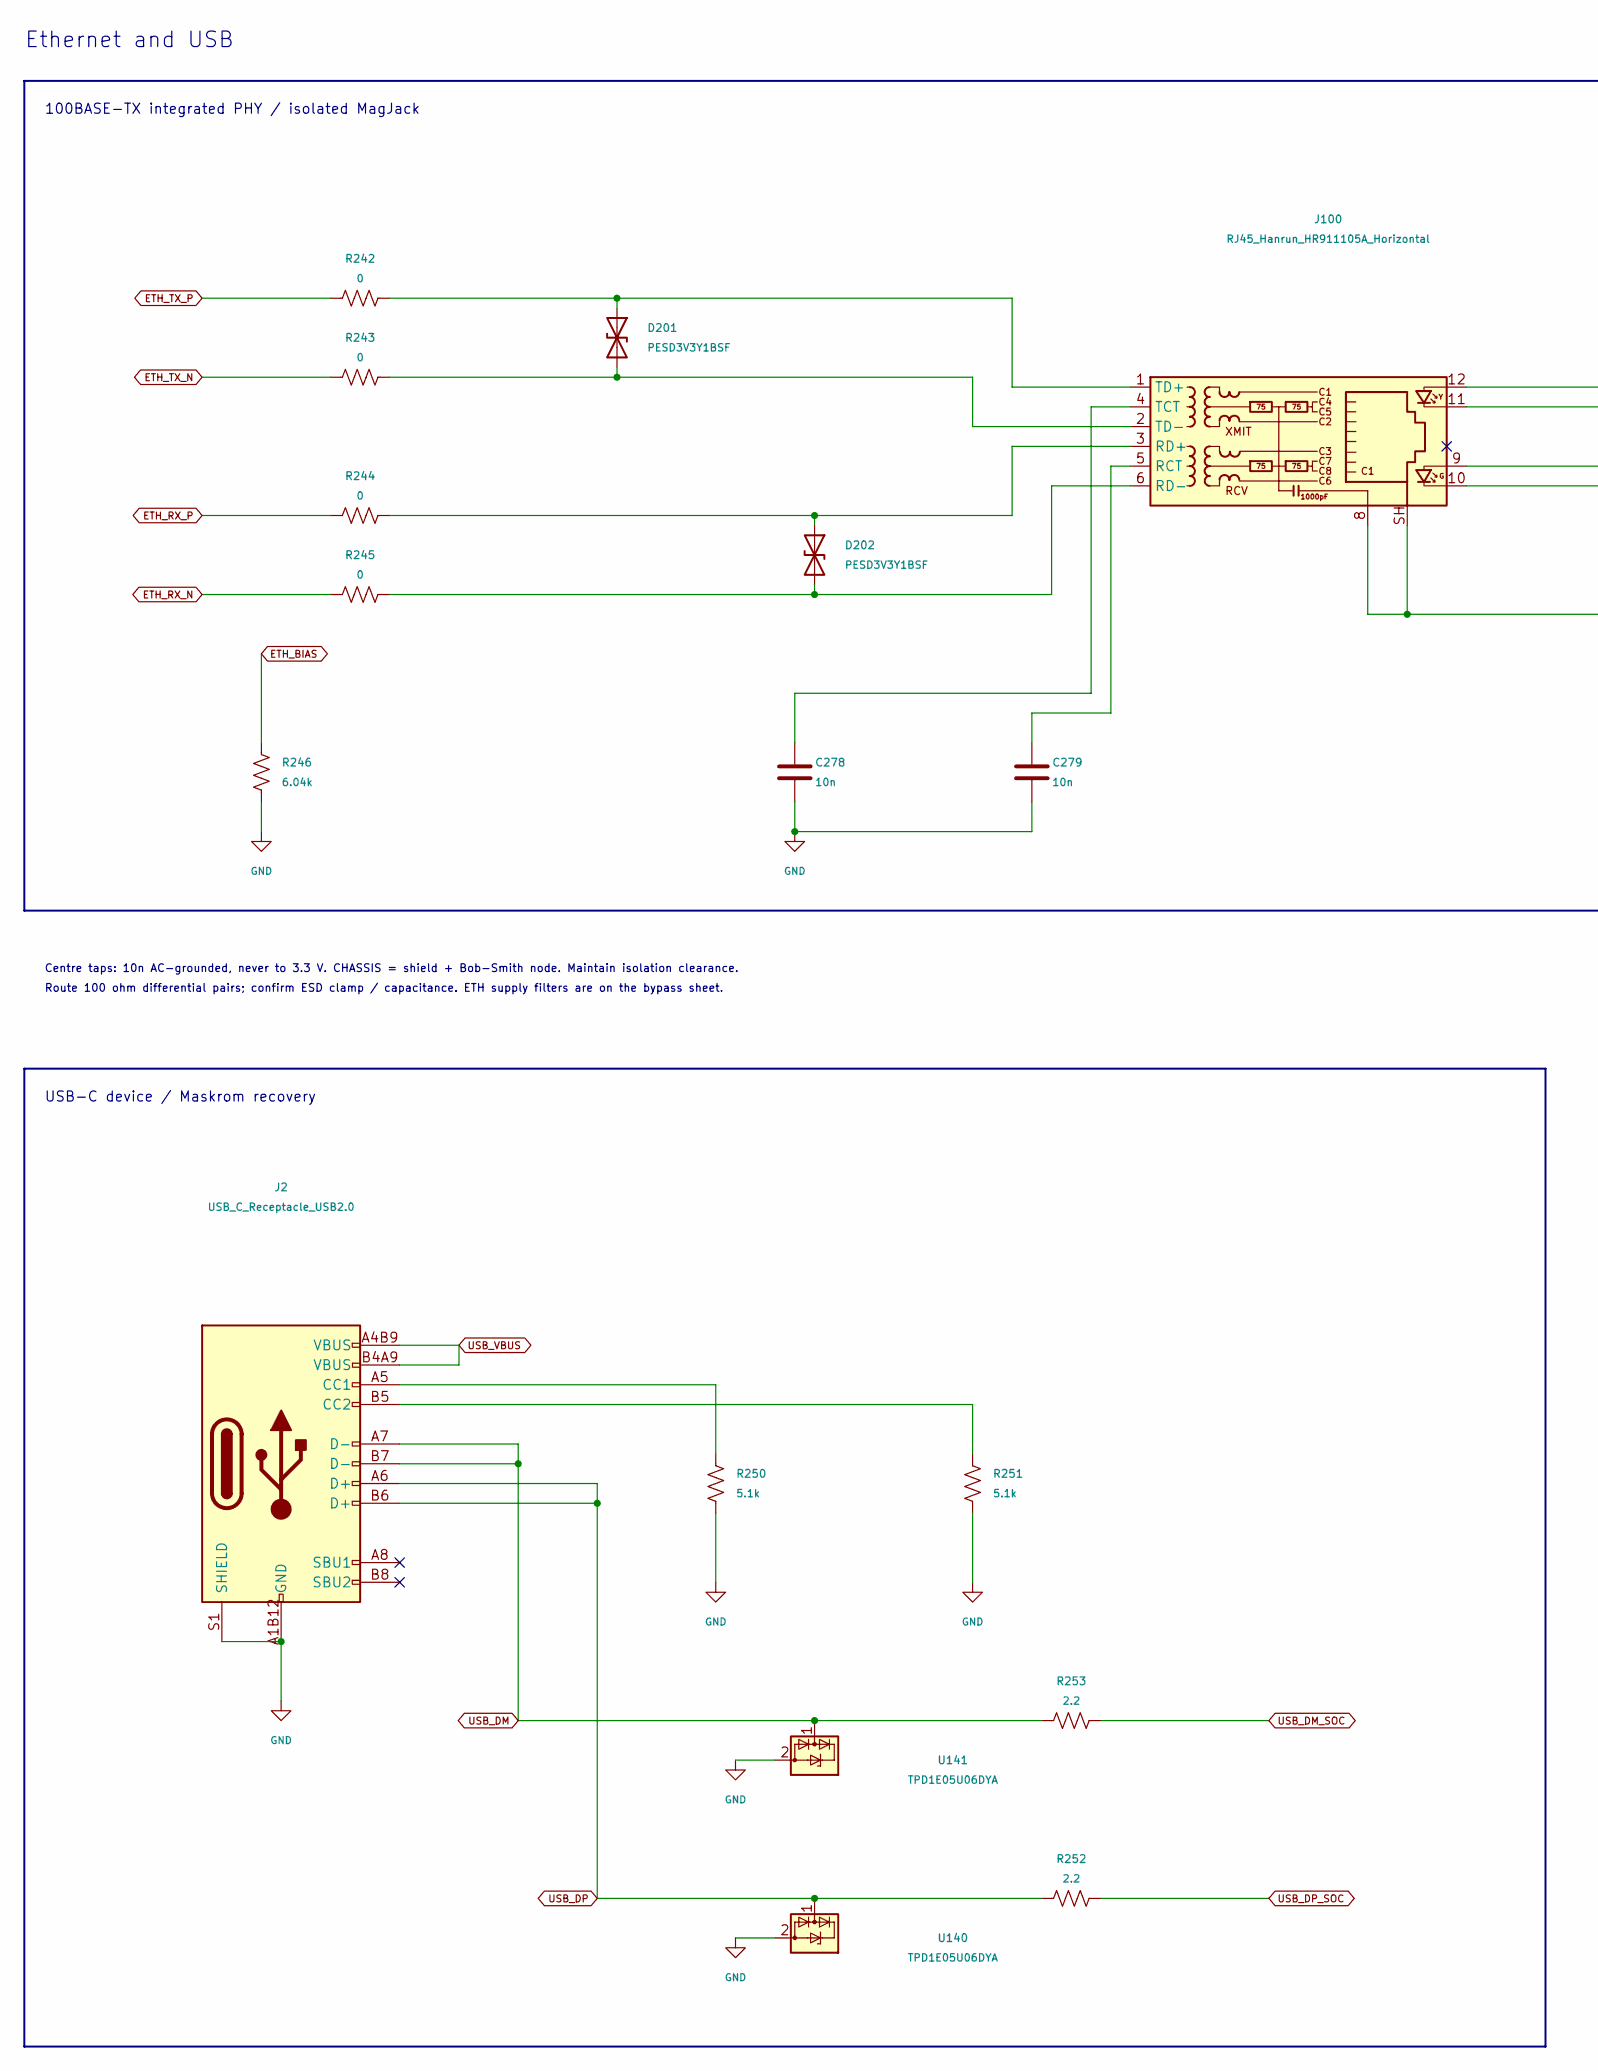
[picture p47: schematic 06_network_usb.kicad_sch, MujinaControl-S19 / Ethernet and USB, part in row 1, column 1]

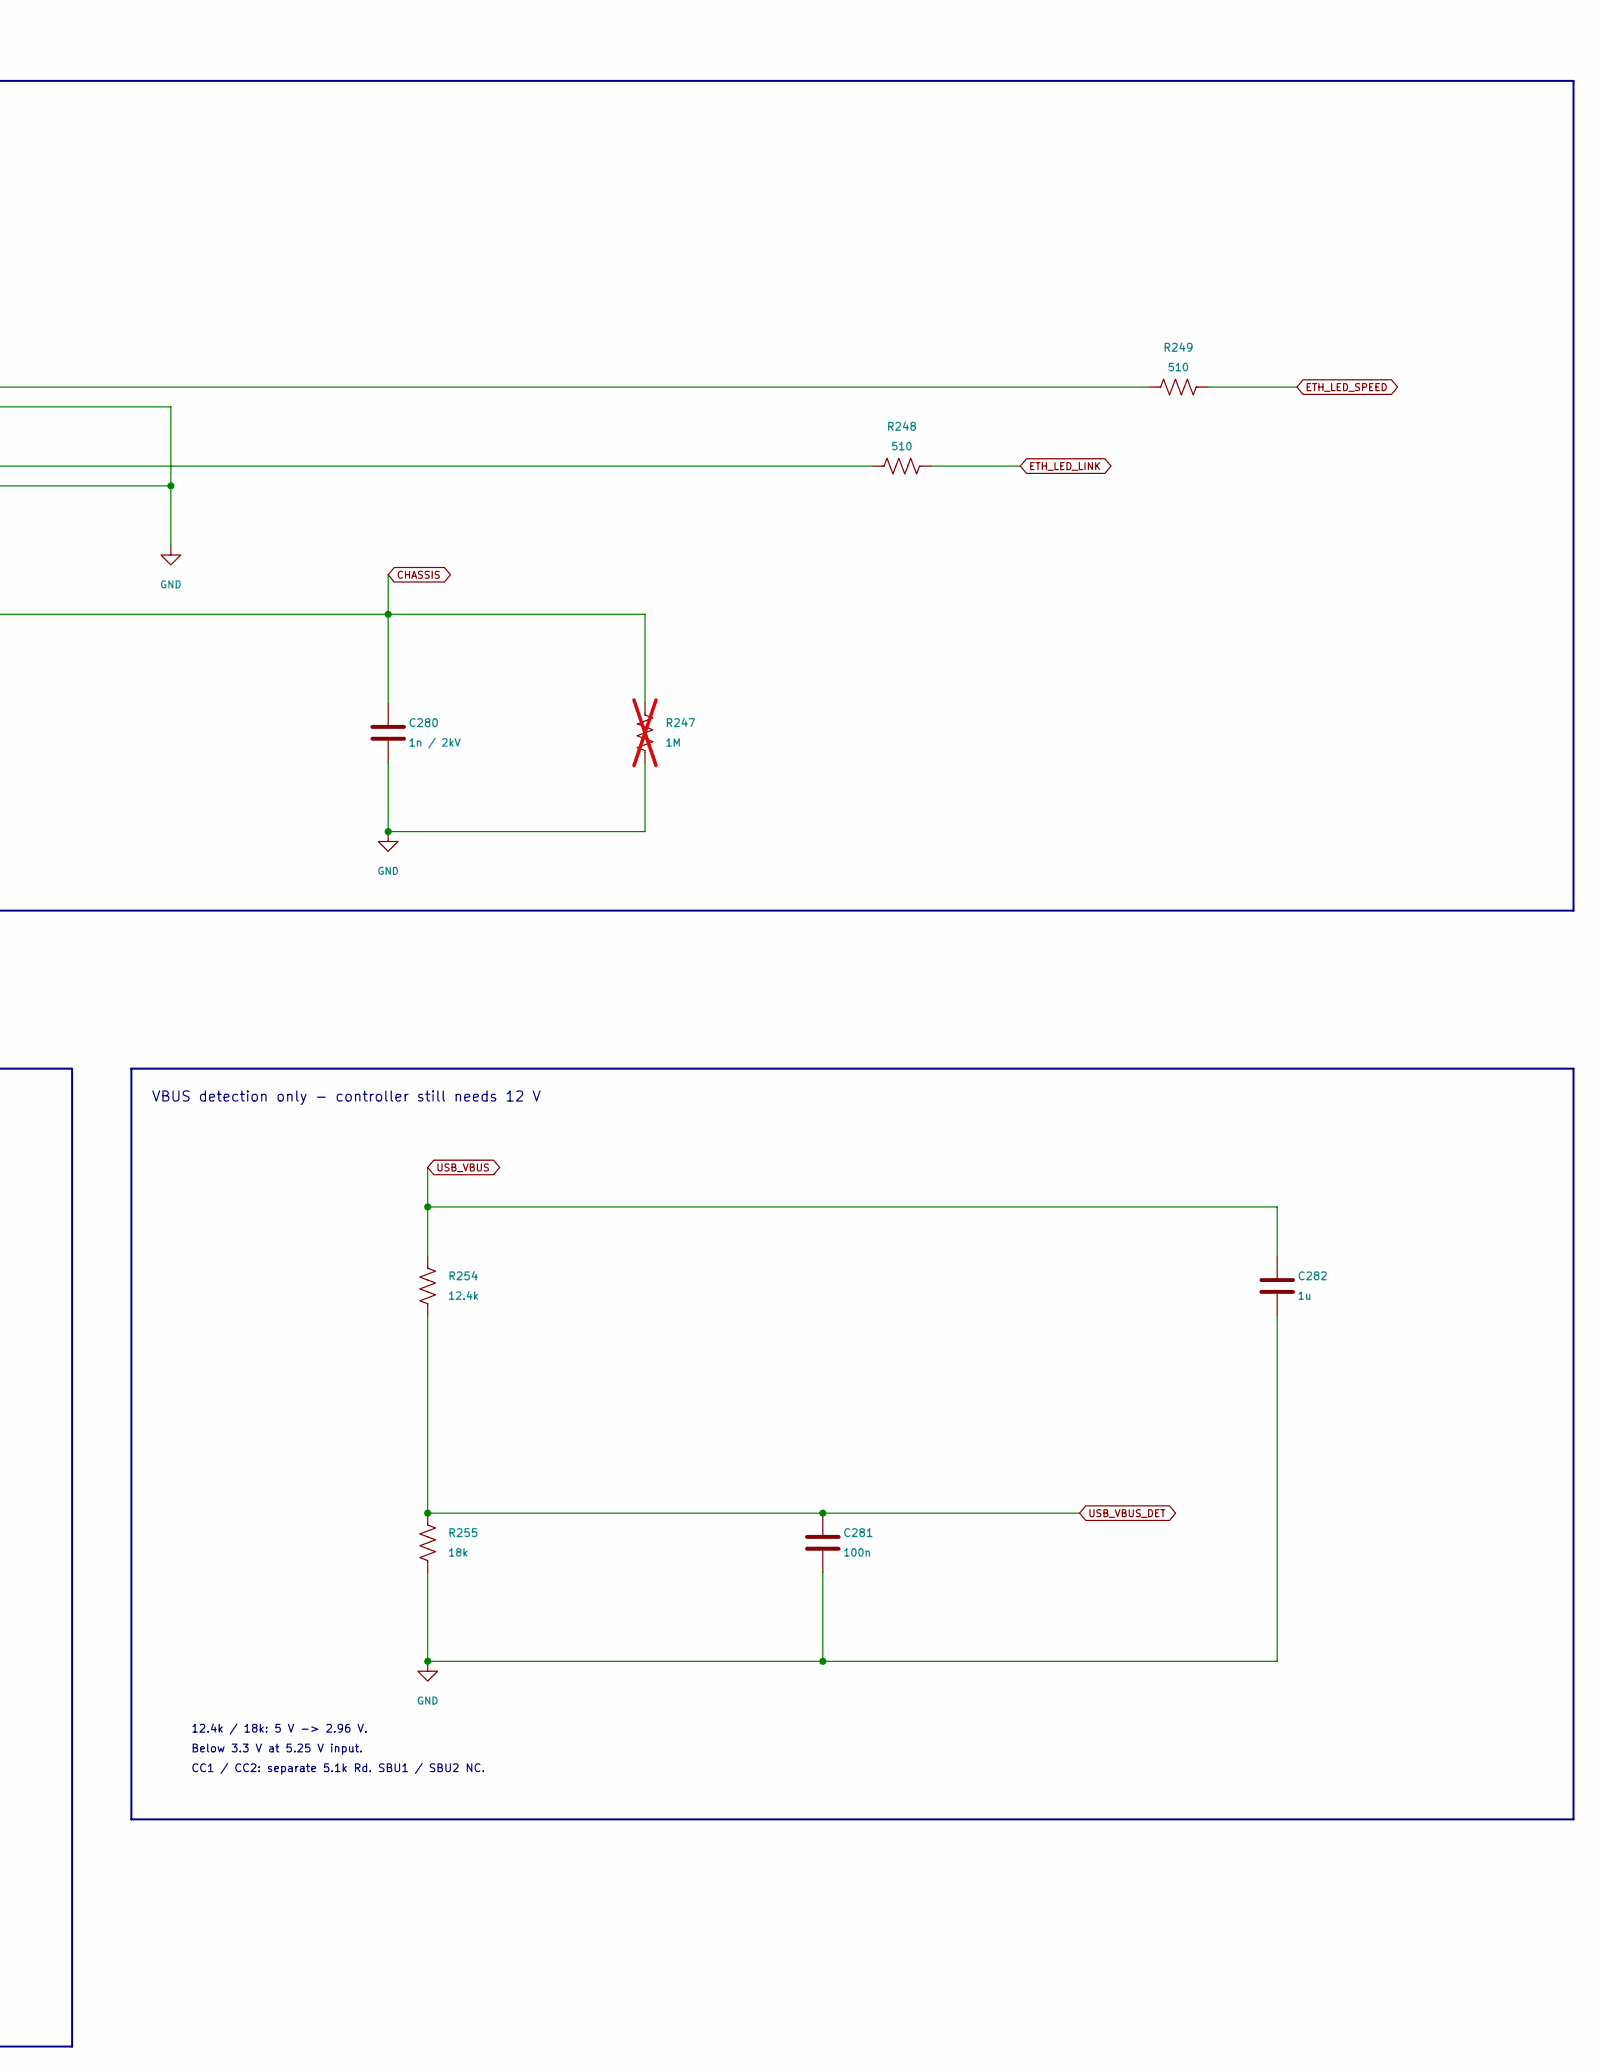
[picture p48: schematic 06_network_usb.kicad_sch, MujinaControl-S19 / Ethernet and USB, part in row 1, column 2]

Parts:
C278, C279: 10n; C_0402_1005Metric; MPN CL05B103KB5NNNC; LCSC C15195
C280: 1n / 2kV; C_1808_4520Metric; MPN C1808C102KGRACTU; LCSC C2167485
C281: 100n; C_0402_1005Metric; MPN CL05B104KO5NNNC; LCSC C1525
C282: 1u; C_0402_1005Metric; MPN CL05A105KA5NQNC; LCSC C52923
D201, D202: PESD3V3Y1BSF; Nexperia_DSN0603-2_0.6x0.3mm_P0.4mm; MPN PESD3V3Y1BSFYL; LCSC C552535
J2: USB_C_Receptacle_USB2.0; USB_C_Receptacle_GCT_USB4105-xx-A_16P_TopMnt_Horizontal; MPN USB4105-GF-A; LCSC C3020560
J100: RJ45_Hanrun_HR911105A_Horizontal; MPN HR911105A; LCSC C12074
R242, R243, R244, R245: 0; R_0402_1005Metric; MPN 0402WGF0000TCE; LCSC C17168
R246: 6.04k; R_0402_1005Metric; MPN RC0402FR-076K04L; LCSC C97819
R247: 1M; R_0402_1005Metric; MPN 0402WGF1004TCE; LCSC C26083; not fitted
R248, R249: 510; R_0402_1005Metric; MPN 0402WGF5100TCE; LCSC C25123
R250, R251: 5.1k; R_0402_1005Metric; MPN 0402WGF5101TCE; LCSC C25905
R252, R253: 2.2; R_0402_1005Metric; MPN RC0402FR-072R2L; LCSC C327251
R254: 12.4k; R_0402_1005Metric; MPN RC0402FR-0712K4L; LCSC C138060
R255: 18k; R_0402_1005Metric; MPN 0402WGF1802TCE; LCSC C25762
U140, U141: TPD1E05U06DYA; D_SOD-523; MPN TPD1E05U06DYA; LCSC C3702980

Connections:
CHASSIS: C280.1, J100.8, J100.SH, R247.1
ETH_BIAS: R246.1; also elsewhere on the board
ETH_LED_LINK: R248.1; also elsewhere on the board
ETH_LED_SPEED: R249.1; also elsewhere on the board
ETH_RX_N: R245.1; also elsewhere on the board
ETH_RX_P: R244.1; also elsewhere on the board
ETH_TX_N: R243.1; also elsewhere on the board
ETH_TX_P: R242.1; also elsewhere on the board
GND: C278.2, C279.2, C280.2, C281.2, C282.2, J2.A1B12 (GND), J2.B1A12 (GND), J2.S1 (SHIELD), J100.10, J100.11, R246.2, R247.2, R250.2, R251.2, R255.2, U140.2 (GND), U141.2 (GND); also elsewhere on the board
unnamed: D201.1 (A1), J100.1 (TD+), R242.2
unnamed: D201.2 (A2), J100.2 (TD-), R243.2
unnamed: D202.1 (A1), J100.3 (RD+), R244.2
unnamed: D202.2 (A2), J100.6 (RD-), R245.2
unnamed: J2.A5 (CC1), R250.1
unnamed: J2.B5 (CC2), R251.1
unnamed: J100.9, R248.2
unnamed: J100.12, R249.2
unnamed: C279.1, J100.5 (RCT)
unnamed: C278.1, J100.4 (TCT)
USB_DM: J2.A7 (D-), J2.B7 (D-), R253.2, U141.1 (I/O)
USB_DM_SOC: R253.1; also elsewhere on the board
USB_DP: J2.A6 (D+), J2.B6 (D+), R252.2, U140.1 (I/O)
USB_DP_SOC: R252.1; also elsewhere on the board
USB_VBUS: C282.1, J2.A4B9 (VBUS), J2.B4A9 (VBUS), R254.1
USB_VBUS_DET: C281.1, R254.2, R255.1; also elsewhere on the board

Notes on the sheet:
Ethernet and USB
100BASE-TX integrated PHY / isolated MagJack
12.4k / 18k: 5 V -> 2.96 V.
Centre taps: 10n AC-grounded, never to 3.3 V. CHASSIS = shield + Bob-Smith node. Maintain isolation clearance.
Route 100 ohm differential pairs; confirm ESD clamp / capacitance. ETH supply filters are on the bypass sheet.
Below 3.3 V at 5.25 V input.
CC1 / CC2: separate 5.1k Rd. SBU1 / SBU2 NC.
VBUS detection only - controller still needs 12 V
USB-C device / Maskrom recovery

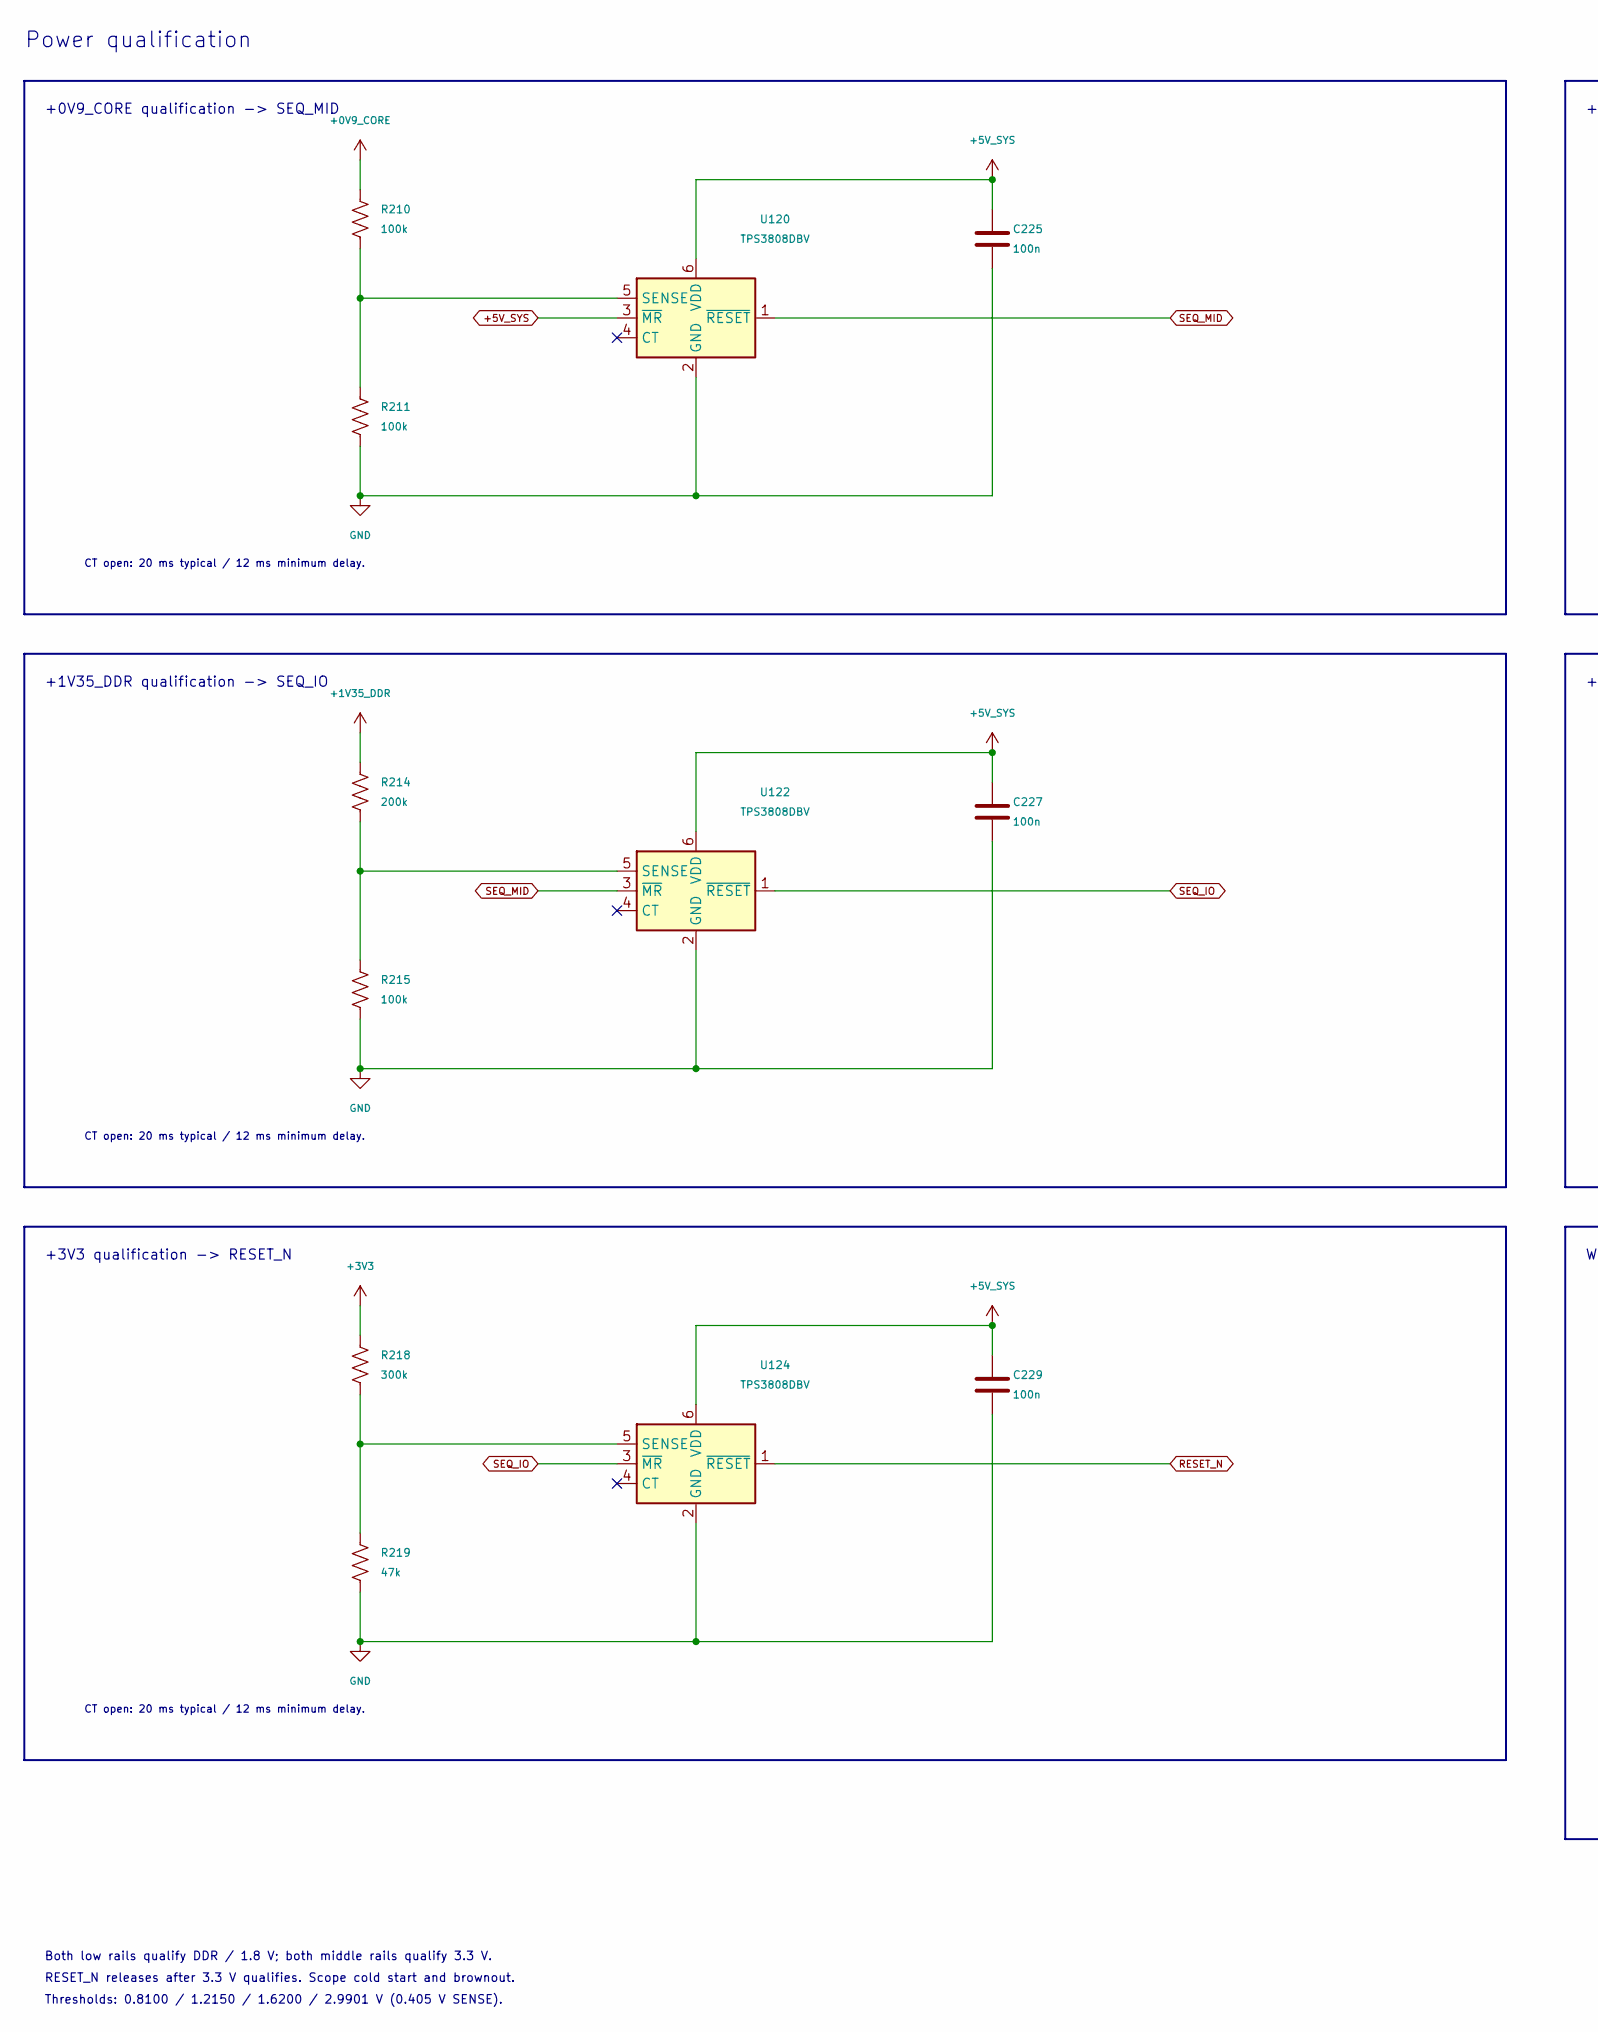
[picture p49: schematic 03_sequencing.kicad_sch, MujinaControl-S19 / Power qualification, part in row 1, column 1]

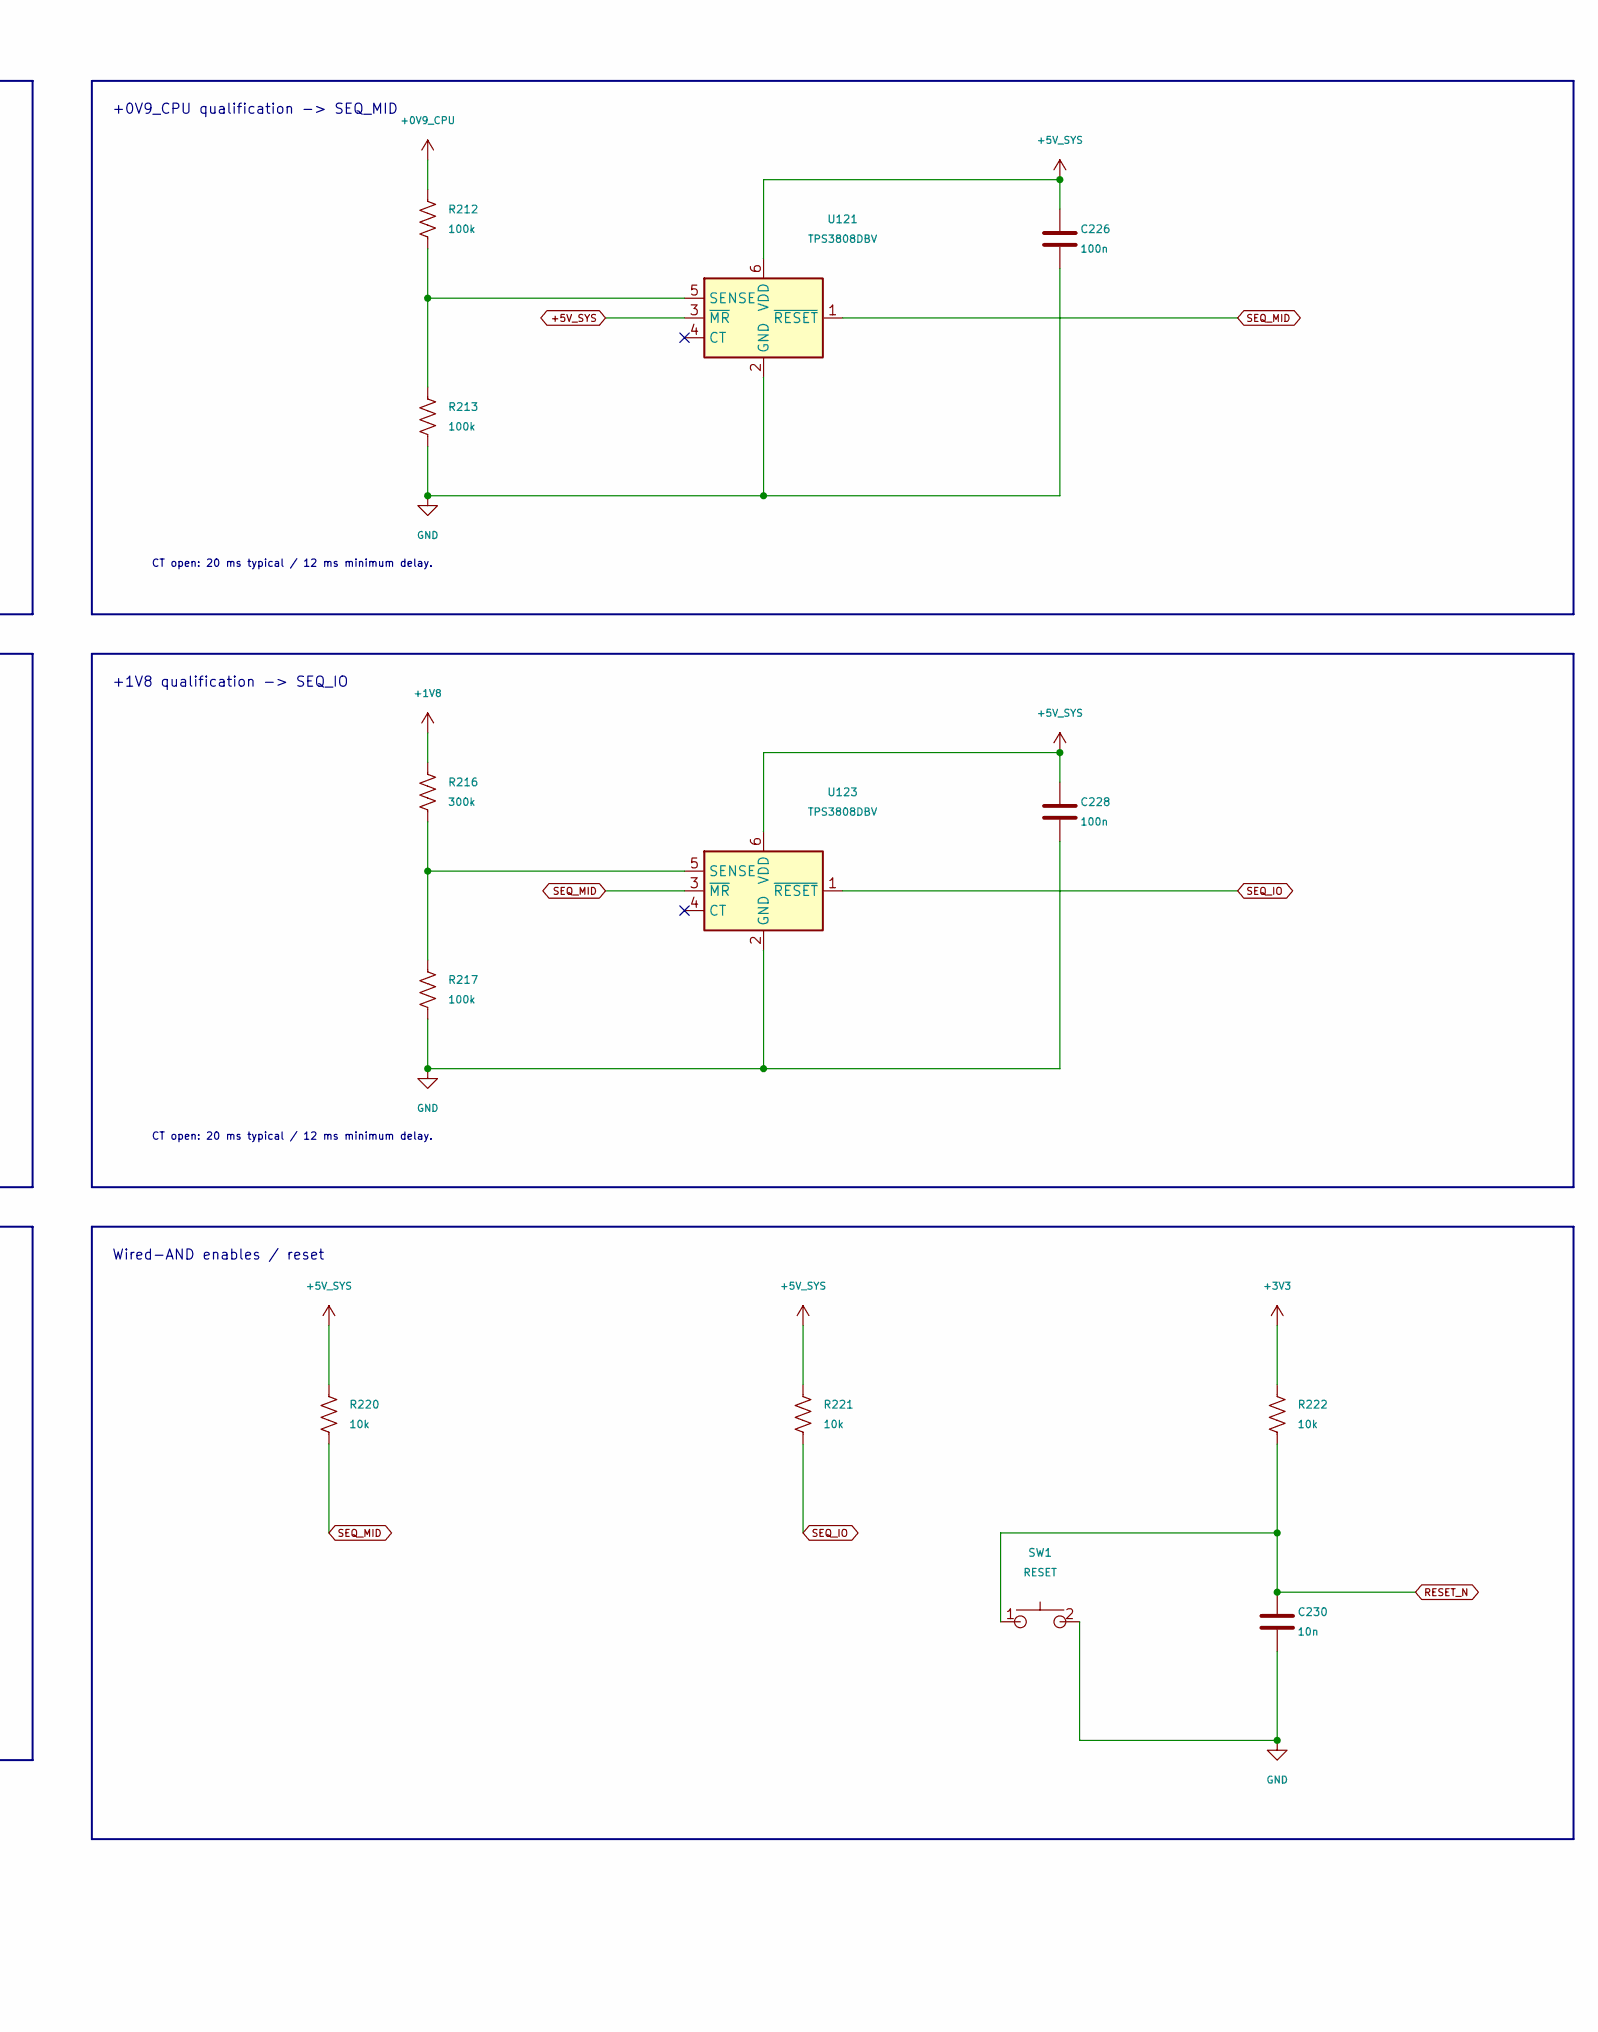
[picture p50: schematic 03_sequencing.kicad_sch, MujinaControl-S19 / Power qualification, part in row 1, column 2]

Parts:
C225, C226, C227, C228, C229: 100n; C_0402_1005Metric; MPN CL05B104KO5NNNC; LCSC C1525
C230: 10n; C_0402_1005Metric; MPN CL05B103KB5NNNC; LCSC C15195
R210, R211, R212, R213, R215, R217: 100k; R_0402_1005Metric; MPN 0402WGF1003TCE; LCSC C25741
R214: 200k; R_0402_1005Metric; MPN 0402WGF2003TCE; LCSC C25764
R216, R218: 300k; R_0402_1005Metric; MPN 0402WGF3003TCE; LCSC C25774
R219: 47k; R_0402_1005Metric; MPN 0402WGF4702TCE; LCSC C25792
R220, R221, R222: 10k; R_0402_1005Metric; MPN 0402WGF1002TCE; LCSC C25744
SW1: RESET; SW-SMD_TC-S3601-3.5-260G-F0.6; MPN TC-S3601-3.5-260G-F0.6; LCSC C49101620
U120, U121, U122, U123, U124: TPS3808DBV; SOT-23-6; MPN TPS3808G01DBVR-TP; LCSC C42394092

Connections:
+0V9_CORE: R210.1; also elsewhere on the board
+0V9_CPU: R212.1; also elsewhere on the board
+1V8: R216.1; also elsewhere on the board
+1V35_DDR: R214.1; also elsewhere on the board
+3V3: R218.1, R222.1; also elsewhere on the board
+5V_SYS: C225.1, C226.1, C227.1, C228.1, C229.1, R220.1, R221.1, U120.3 (~MR), U120.6 (VDD), U121.3 (~MR), U121.6 (VDD), U122.6 (VDD), U123.6 (VDD), U124.6 (VDD); also elsewhere on the board
GND: C225.2, C226.2, C227.2, C228.2, C229.2, C230.2, R211.2, R213.2, R215.2, R217.2, R219.2, SW1.2, U120.2 (GND), U121.2 (GND), U122.2 (GND), U123.2 (GND), U124.2 (GND); also elsewhere on the board
unnamed: R210.2, R211.1, U120.5 (SENSE)
unnamed: R212.2, R213.1, U121.5 (SENSE)
unnamed: R214.2, R215.1, U122.5 (SENSE)
unnamed: R216.2, R217.1, U123.5 (SENSE)
unnamed: R218.2, R219.1, U124.5 (SENSE)
RESET_N: C230.1, R222.2, SW1.1, U124.1 (~RESET); also elsewhere on the board
SEQ_IO: R221.2, U122.1 (~RESET), U123.1 (~RESET), U124.3 (~MR); also elsewhere on the board
SEQ_MID: R220.2, U120.1 (~RESET), U121.1 (~RESET), U122.3 (~MR), U123.3 (~MR); also elsewhere on the board

Notes on the sheet:
Wired-AND enables / reset
+1V8 qualification -> SEQ_IO
+0V9_CPU qualification -> SEQ_MID
+1V35_DDR qualification -> SEQ_IO
Thresholds: 0.8100 / 1.2150 / 1.6200 / 2.9901 V (0.405 V SENSE).
+3V3 qualification -> RESET_N
+0V9_CORE qualification -> SEQ_MID
Both low rails qualify DDR / 1.8 V; both middle rails qualify 3.3 V.
RESET_N releases after 3.3 V qualifies. Scope cold start and brownout.
Power qualification
CT open: 20 ms typical / 12 ms minimum delay.
