skot/MujinaControl-S19/MujinaControl-S19.kicad_pcb

## KiCad design MujinaControl-S19.kicad_pcb (continued)

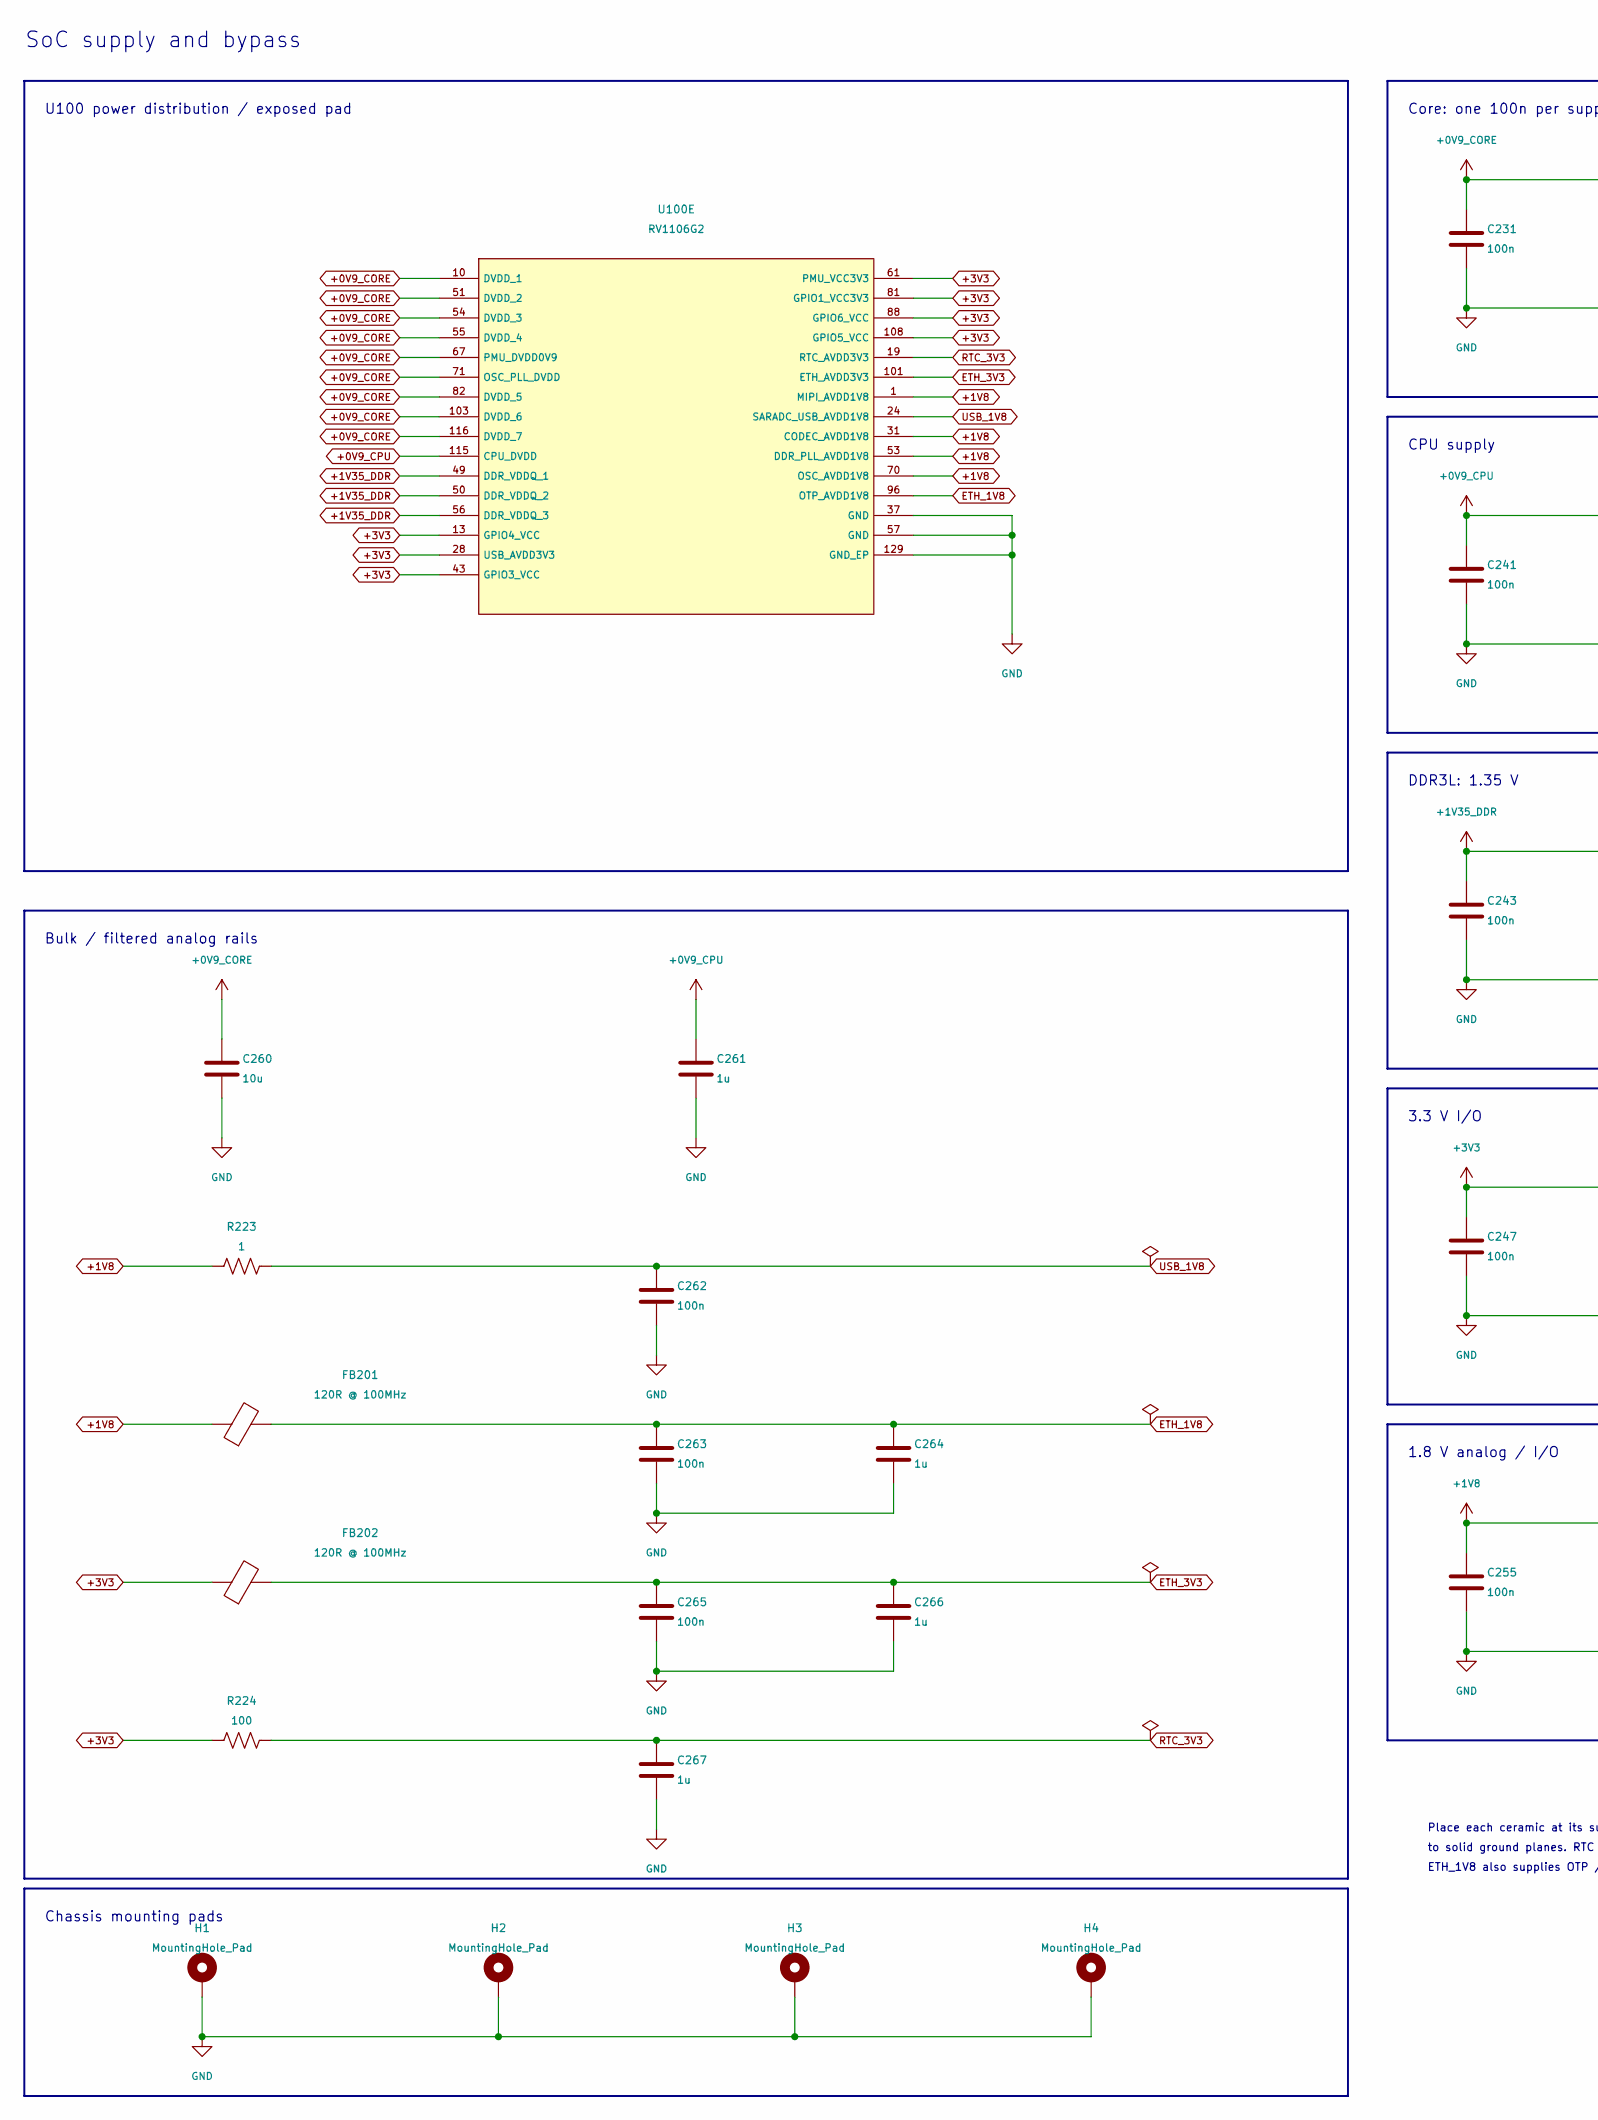
[picture p51: schematic 04_decoupling.kicad_sch, MujinaControl-S19 / SoC supply and bypass, part in row 1, column 1]

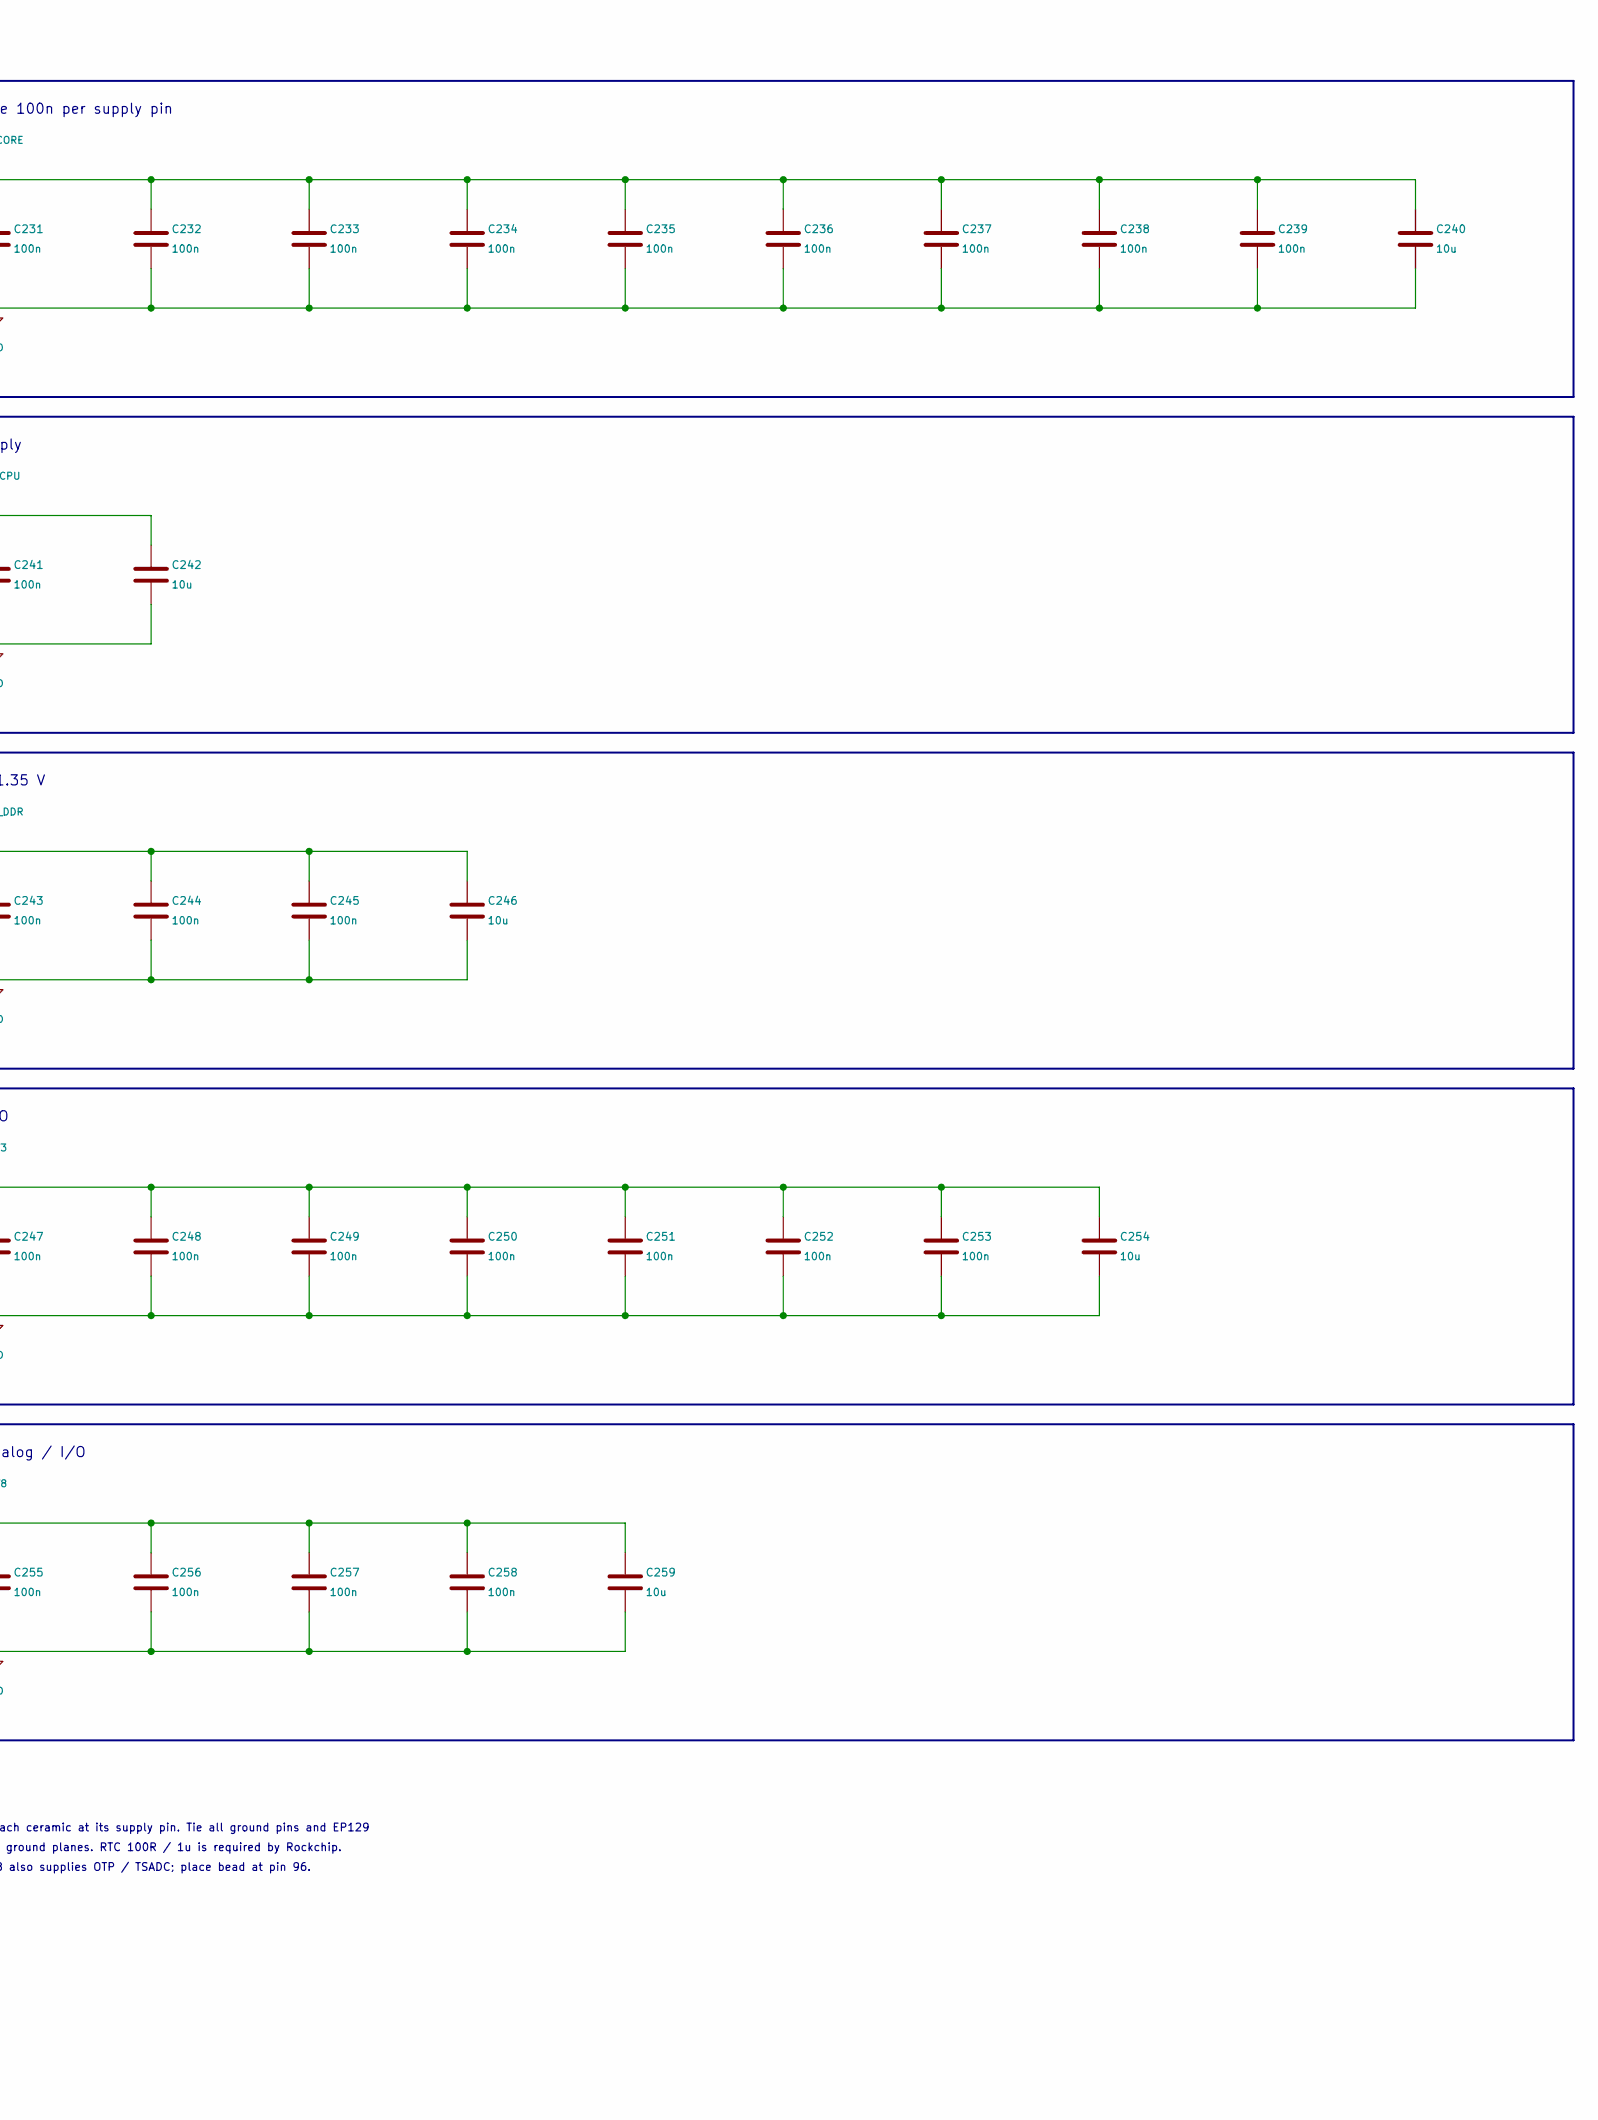
[picture p52: schematic 04_decoupling.kicad_sch, MujinaControl-S19 / SoC supply and bypass, part in row 1, column 2]

Parts:
C231, C232, C233, C234, C235, C236, C237, C238, C239, C241, C243, C244, C245, C247, C248, C249, C250, C251, C252, C253, C255, C256, C257, C258, C262, C263, C265: 100n; C_0402_1005Metric; MPN CL05B104KO5NNNC; LCSC C1525
C240, C242, C246, C254, C259, C260: 10u; C_0805_2012Metric; MPN CL21A106KAYNNNE; LCSC C15850
C261, C264, C266, C267: 1u; C_0402_1005Metric; MPN CL05A105KA5NQNC; LCSC C52923
FB201, FB202: 120R @ 100MHz; L_0402_1005Metric; MPN BLM15AG121SN1D; LCSC C85812
H1, H2, H3, H4: MountingHole_Pad; MountingHole_3mm_Pad; MPN PCB_MOUNTING_HOLE; LCSC N/A
R223: 1; R_0402_1005Metric; MPN 0402WGF100KTCE; LCSC C25086
R224: 100; R_0402_1005Metric; MPN 0402WGF1000TCE; LCSC C25076
U100: RV1106G2; Rockchip_QFN-128-1EP_12.3x12.3mm_P0.35mm_EP7x7mm; MPN RV1106G2; LCSC C5272606

Connections:
+0V9_CORE: C231.1, C232.1, C233.1, C234.1, C235.1, C236.1, C237.1, C238.1, C239.1, C240.1, C260.1, U100.10 (DVDD_1), U100.51 (DVDD_2), U100.54 (DVDD_3), U100.55 (DVDD_4), U100.67 (PMU_DVDD0V9), U100.71 (OSC_PLL_DVDD), U100.82 (DVDD_5), U100.103 (DVDD_6), U100.116 (DVDD_7); also elsewhere on the board
+0V9_CPU: C241.1, C242.1, C261.1, U100.115 (CPU_DVDD); also elsewhere on the board
+1V8: C255.1, C256.1, C257.1, C258.1, C259.1, FB201.1, R223.1, U100.1 (MIPI_AVDD1V8), U100.31 (CODEC_AVDD1V8), U100.53 (DDR_PLL_AVDD1V8), U100.70 (OSC_AVDD1V8); also elsewhere on the board
+1V35_DDR: C243.1, C244.1, C245.1, C246.1, U100.49 (DDR_VDDQ_1), U100.50 (DDR_VDDQ_2), U100.56 (DDR_VDDQ_3); also elsewhere on the board
+3V3: C247.1, C248.1, C249.1, C250.1, C251.1, C252.1, C253.1, C254.1, FB202.1, R224.1, U100.13 (GPIO4_VCC), U100.28 (USB_AVDD3V3), U100.43 (GPIO3_VCC), U100.61 (PMU_VCC3V3), U100.81 (GPIO1_VCC3V3), U100.88 (GPIO6_VCC), U100.108 (GPIO5_VCC); also elsewhere on the board
ETH_1V8: C263.1, C264.1, FB201.2, U100.96 (OTP_AVDD1V8)
ETH_3V3: C265.1, C266.1, FB202.2, U100.101 (ETH_AVDD3V3)
GND: C231.2, C232.2, C233.2, C234.2, C235.2, C236.2, C237.2, C238.2, C239.2, C240.2, C241.2, C242.2, C243.2, C244.2, C245.2, C246.2, C247.2, C248.2, C249.2, C250.2, C251.2, C252.2, C253.2, C254.2, C255.2, C256.2, C257.2, C258.2, C259.2, C260.2, C261.2, C262.2, C263.2, C264.2, C265.2, C266.2, C267.2, H1.1 (1_1), H2.1 (1_1), H3.1 (1_1), H4.1 (1_1), U100.37 (GND), U100.57 (GND), U100.129 (GND_EP); also elsewhere on the board
RTC_3V3: C267.1, R224.2, U100.19 (RTC_AVDD3V3)
USB_1V8: C262.1, R223.2, U100.24 (SARADC_USB_AVDD1V8)

Notes on the sheet:
DDR3L: 1.35 V
CPU supply
Place each ceramic at its supply pin. Tie all ground pins and EP129
SoC supply and bypass
1.8 V analog / I/O
ETH_1V8 also supplies OTP / TSADC; place bead at pin 96.
to solid ground planes. RTC 100R / 1u is required by Rockchip.
U100 power distribution / exposed pad
Bulk / filtered analog rails
Core: one 100n per supply pin
Chassis mounting pads
3.3 V I/O

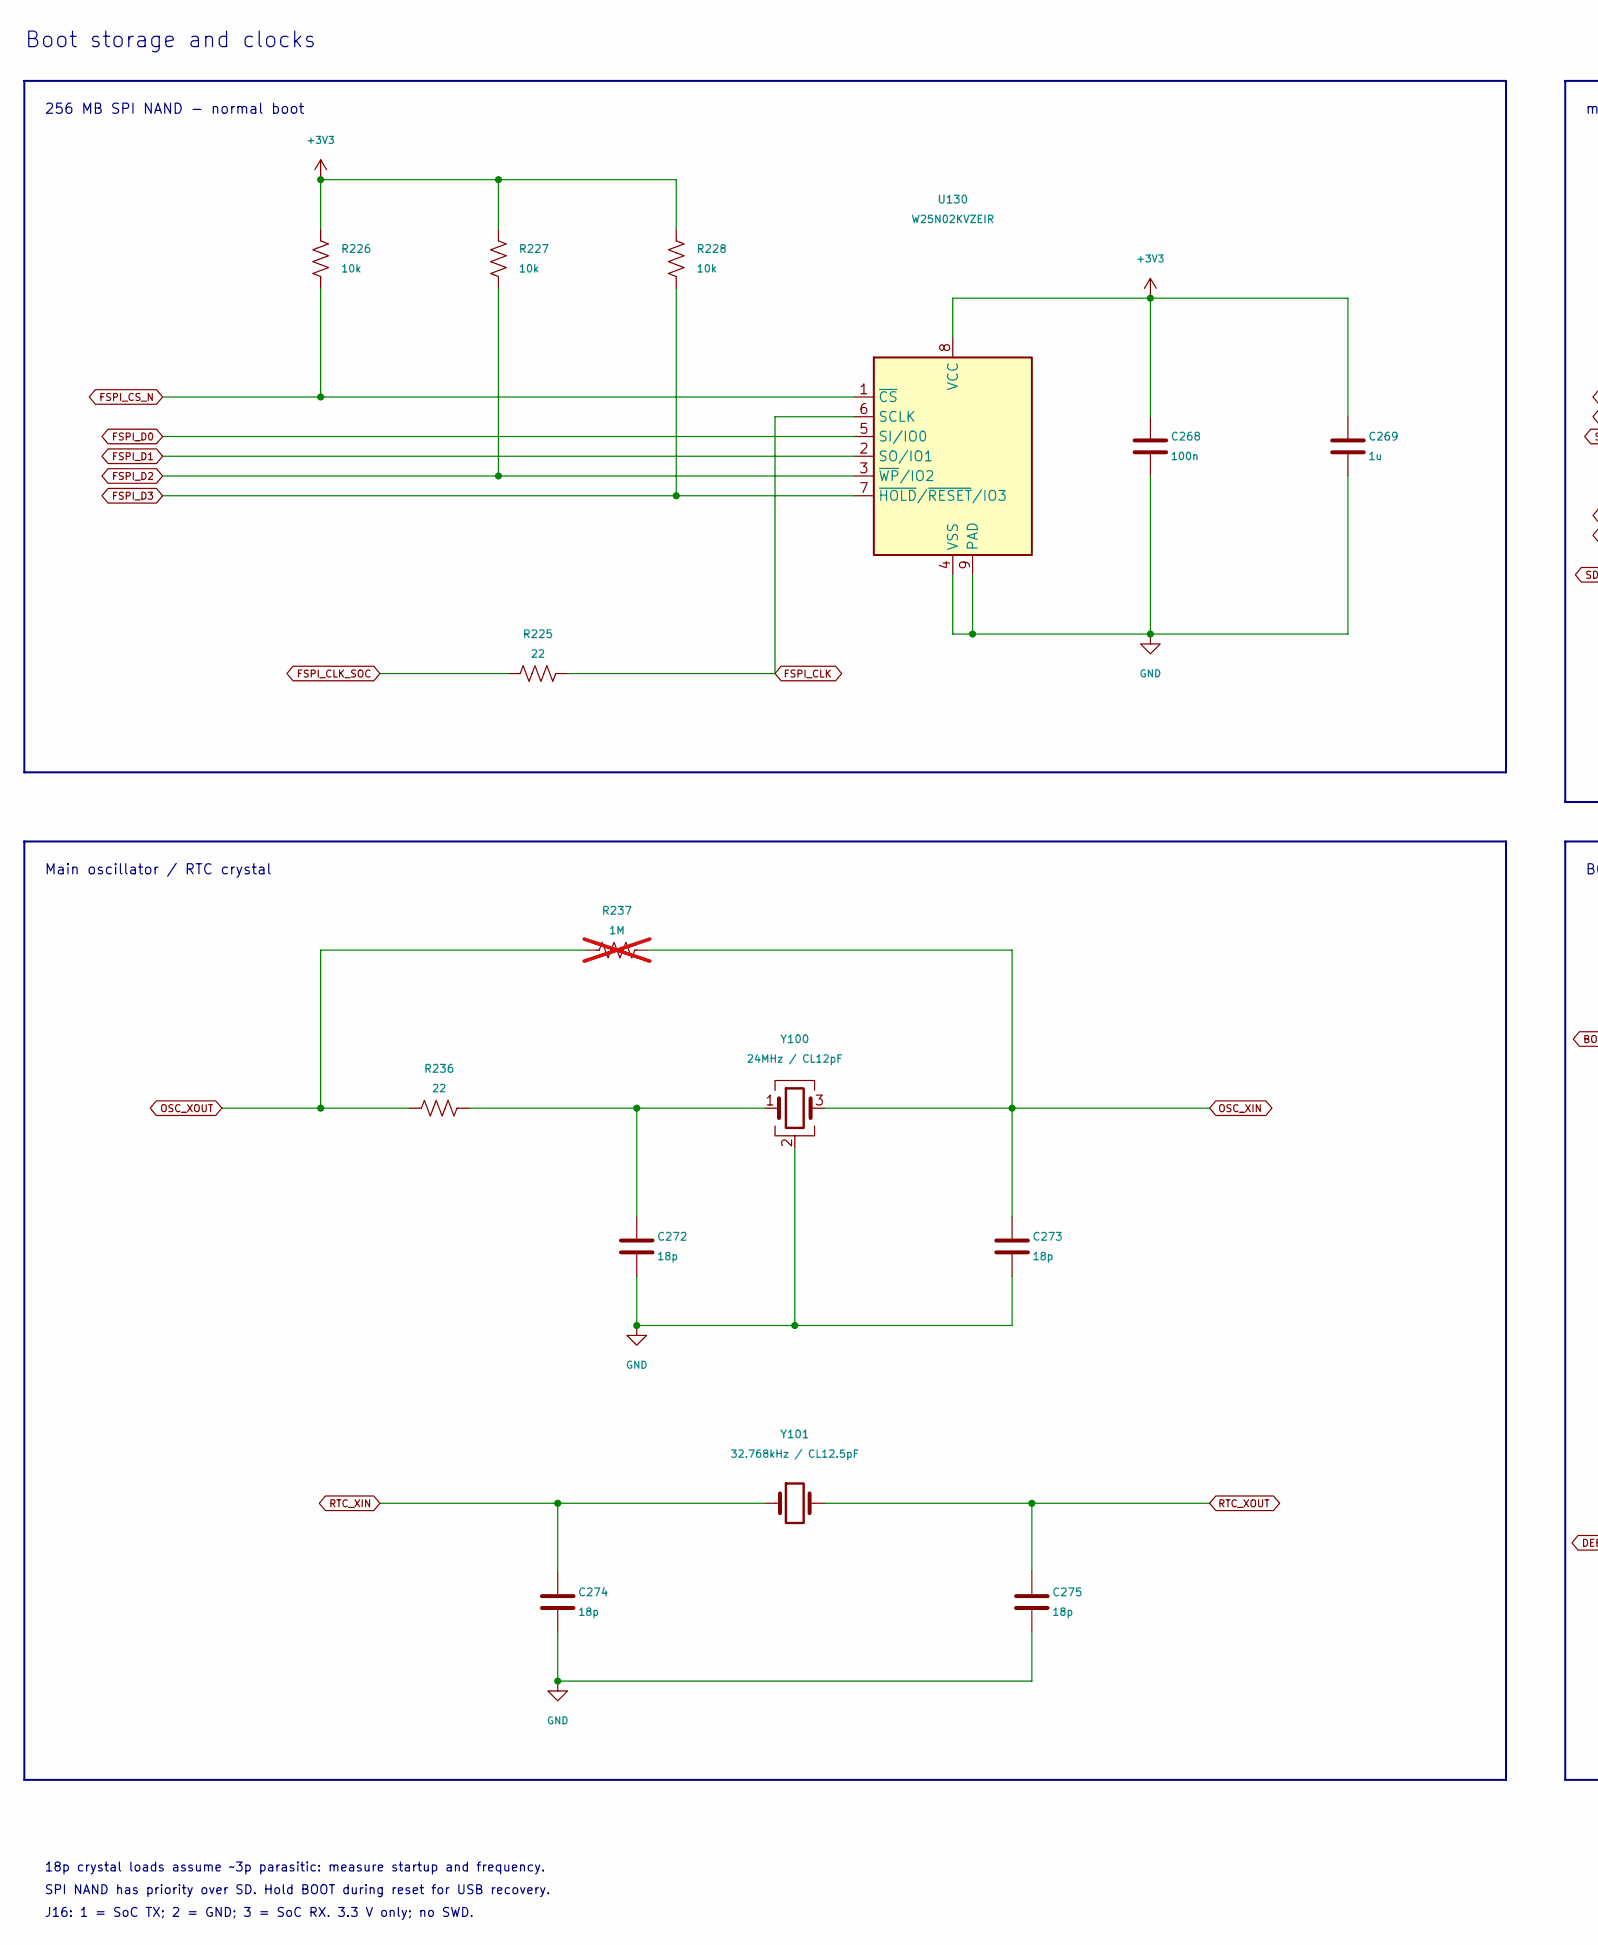
[picture p53: schematic 05_boot.kicad_sch, MujinaControl-S19 / Boot storage and clocks, part in row 1, column 1]

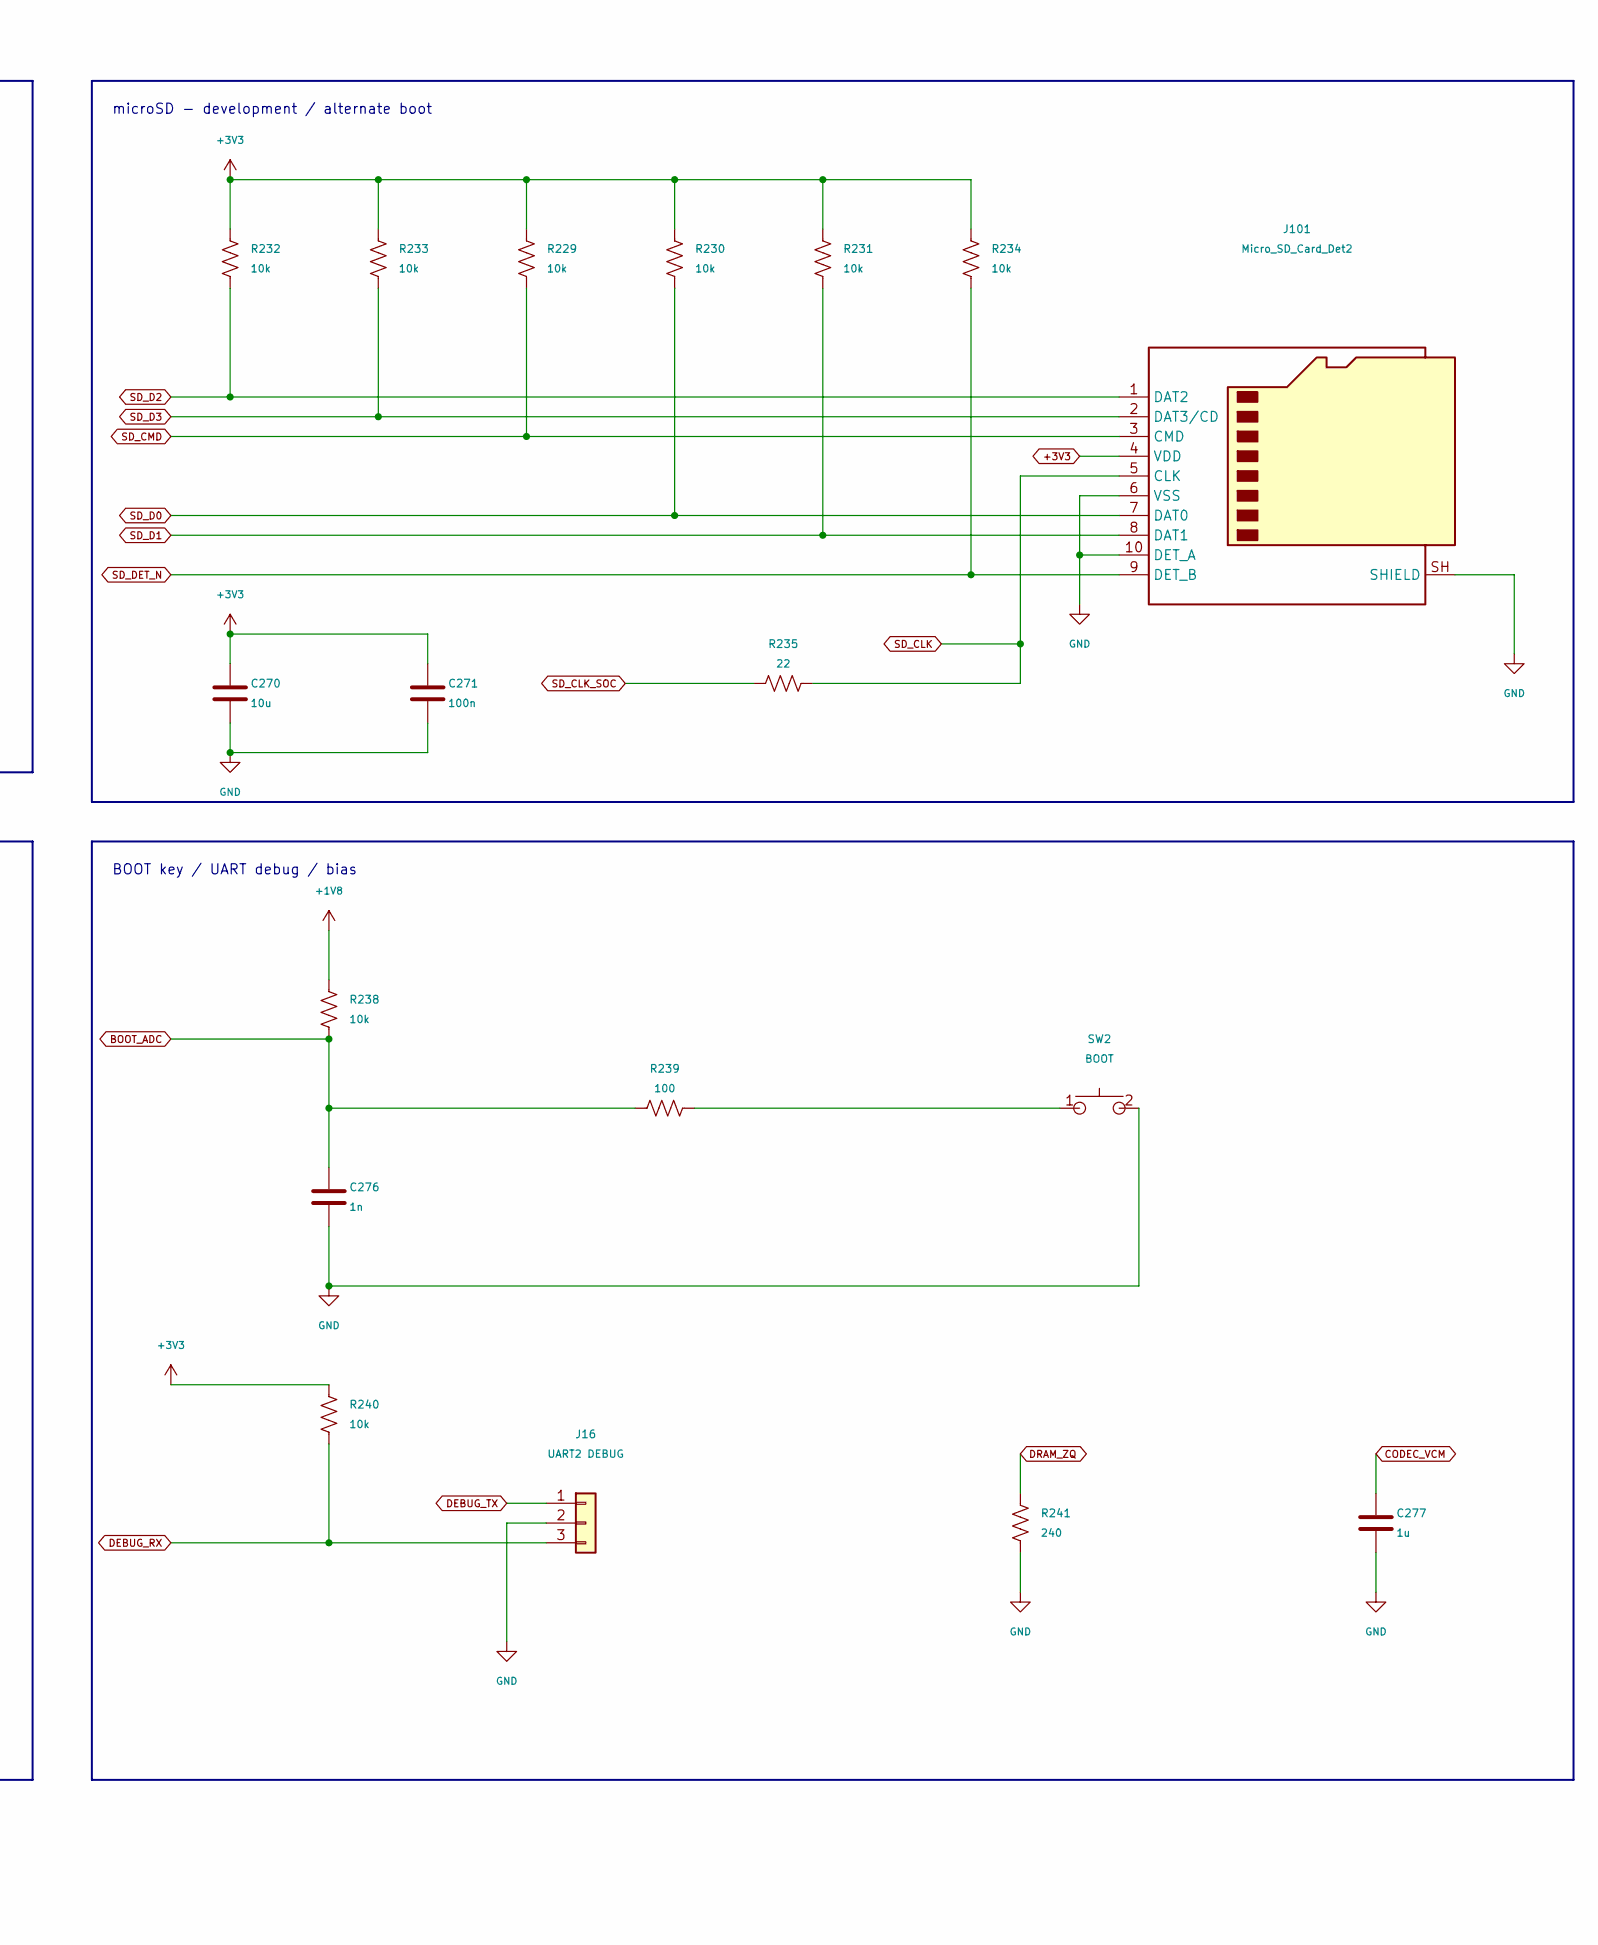
[picture p54: schematic 05_boot.kicad_sch, MujinaControl-S19 / Boot storage and clocks, part in row 1, column 2]

Parts:
C268, C271: 100n; C_0402_1005Metric; MPN CL05B104KO5NNNC; LCSC C1525
C269, C277: 1u; C_0402_1005Metric; MPN CL05A105KA5NQNC; LCSC C52923
C270: 10u; C_0805_2012Metric; MPN CL21A106KAYNNNE; LCSC C15850
C272, C273, C274, C275: 18p; C_0402_1005Metric; MPN 0402CG180J500NT; LCSC C1549
C276: 1n; C_0402_1005Metric; MPN 0402B102K500NT; LCSC C1523
J16: UART2 DEBUG; PinHeader_1x03_P2.54mm_Vertical; MPN 61300311121; LCSC C2915006
J101: Micro_SD_Card_Det2; microSD_HC_Hirose_DM3D-SF; MPN DM3D-SF; LCSC C719027
R225, R235, R236: 22; R_0402_1005Metric; MPN 0402WGF220JTCE; LCSC C25092
R226, R227, R228, R229, R230, R231, R232, R233, R234, R238, R240: 10k; R_0402_1005Metric; MPN 0402WGF1002TCE; LCSC C25744
R237: 1M; R_0402_1005Metric; MPN 0402WGF1004TCE; LCSC C26083; not fitted
R239: 100; R_0402_1005Metric; MPN 0402WGF1000TCE; LCSC C25076
R241: 240; R_0402_1005Metric; MPN RC0402FR-07240RL; LCSC C114755
SW2: BOOT; SW-SMD_TC-S3601-3.5-260G-F0.6; MPN TC-S3601-3.5-260G-F0.6; LCSC C49101620
U130: W25N02KVZEIR; WSON-8-1EP_8x6mm_P1.27mm_EP3.4x4.3mm; MPN W25N02KVZEIR; LCSC C3010298
Y100: 24MHz / CL12pF; Crystal_SMD_3225-4Pin_3.2x2.5mm; MPN X322524MOB4SI; LCSC C70590
Y101: 32.768kHz / CL12.5pF; Crystal_SMD_3215-2Pin_3.2x1.5mm; MPN Q13FC13500004; LCSC C32346

Connections:
+1V8: R238.1; also elsewhere on the board
+3V3: C268.1, C269.1, C270.1, C271.1, J101.4 (VDD), R226.1, R227.1, R228.1, R229.1, R230.1, R231.1, R232.1, R233.1, R234.1, R240.1, U130.8 (VCC); also elsewhere on the board
BOOT_ADC: C276.1, R238.2, R239.1; also elsewhere on the board
CODEC_VCM: C277.1; also elsewhere on the board
DEBUG_RX: J16.3, R240.2; also elsewhere on the board
DEBUG_TX: J16.1; also elsewhere on the board
DRAM_ZQ: R241.1; also elsewhere on the board
FSPI_CLK: R225.2, U130.6 (SCLK)
FSPI_CLK_SOC: R225.1; also elsewhere on the board
FSPI_CS_N: R226.2, U130.1 (~CS); also elsewhere on the board
FSPI_D0: U130.5 (SI/IO0); also elsewhere on the board
FSPI_D1: U130.2 (SO/IO1); also elsewhere on the board
FSPI_D2: R227.2, U130.3 (~WP/IO2); also elsewhere on the board
FSPI_D3: R228.2, U130.7 (~HOLD/~RESET/IO3); also elsewhere on the board
GND: C268.2, C269.2, C270.2, C271.2, C272.2, C273.2, C274.2, C275.2, C276.2, C277.2, J16.2, J101.6 (VSS), J101.10 (DET_A), J101.SH (SHIELD), R241.2, SW2.2, U130.4 (VSS), U130.9 (PAD), Y100.2 (G), Y100.4 (G); also elsewhere on the board
unnamed: C272.1, R236.2, Y100.1
unnamed: R239.2, SW2.1
OSC_XIN: C273.1, R237.2, Y100.3; also elsewhere on the board
OSC_XOUT: R236.1, R237.1; also elsewhere on the board
RTC_XIN: C274.1, Y101.1; also elsewhere on the board
RTC_XOUT: C275.1, Y101.2; also elsewhere on the board
SD_CLK: J101.5 (CLK), R235.2
SD_CLK_SOC: R235.1; also elsewhere on the board
SD_CMD: J101.3 (CMD), R229.2; also elsewhere on the board
SD_D0: J101.7 (DAT0), R230.2; also elsewhere on the board
SD_D1: J101.8 (DAT1), R231.2; also elsewhere on the board
SD_D2: J101.1 (DAT2), R232.2; also elsewhere on the board
SD_D3: J101.2 (DAT3/CD), R233.2; also elsewhere on the board
SD_DET_N: J101.9 (DET_B), R234.2; also elsewhere on the board

Notes on the sheet:
18p crystal loads assume ~3p parasitic: measure startup and frequency.
Main oscillator / RTC crystal
Boot storage and clocks
BOOT key / UART debug / bias
J16: 1 = SoC TX; 2 = GND; 3 = SoC RX. 3.3 V only; no SWD.
microSD - development / alternate boot
256 MB SPI NAND - normal boot
SPI NAND has priority over SD. Hold BOOT during reset for USB recovery.
