skot/MujinaControl-S19/MujinaControl-S19.kicad_pcb

## KiCad design MujinaControl-S19.kicad_pcb (continued)

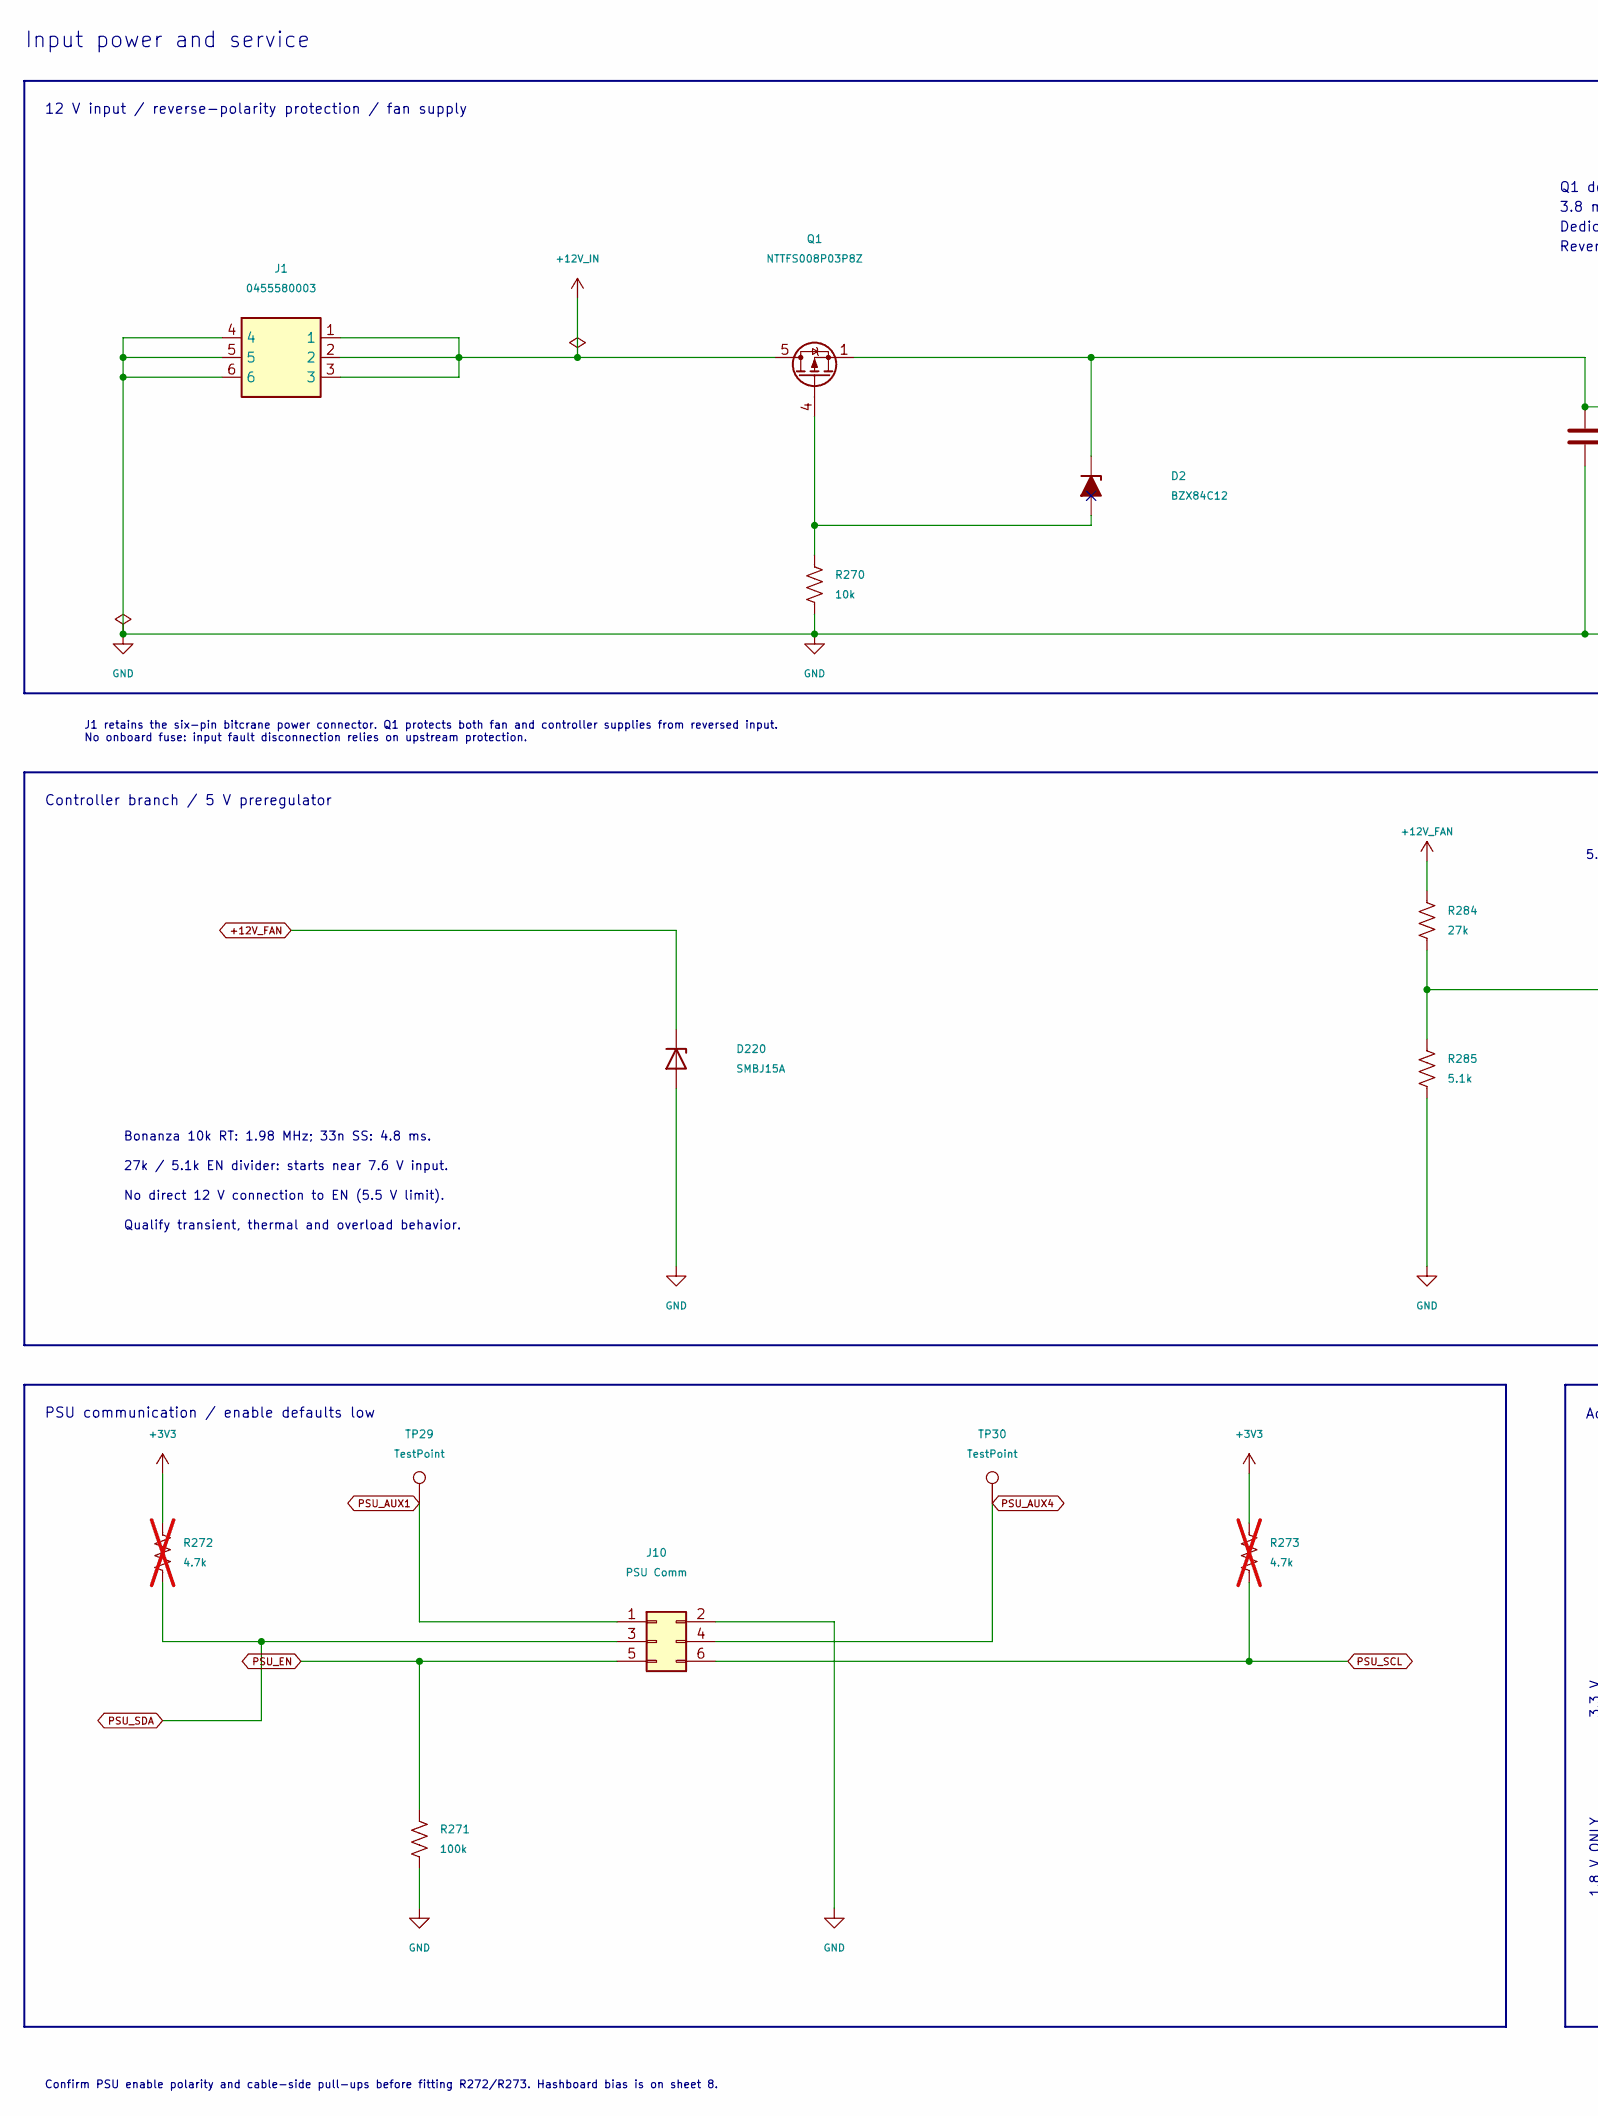
[picture p55: schematic 09_power_service.kicad_sch, MujinaControl-S19 / Input power and service, part in row 1, column 1]

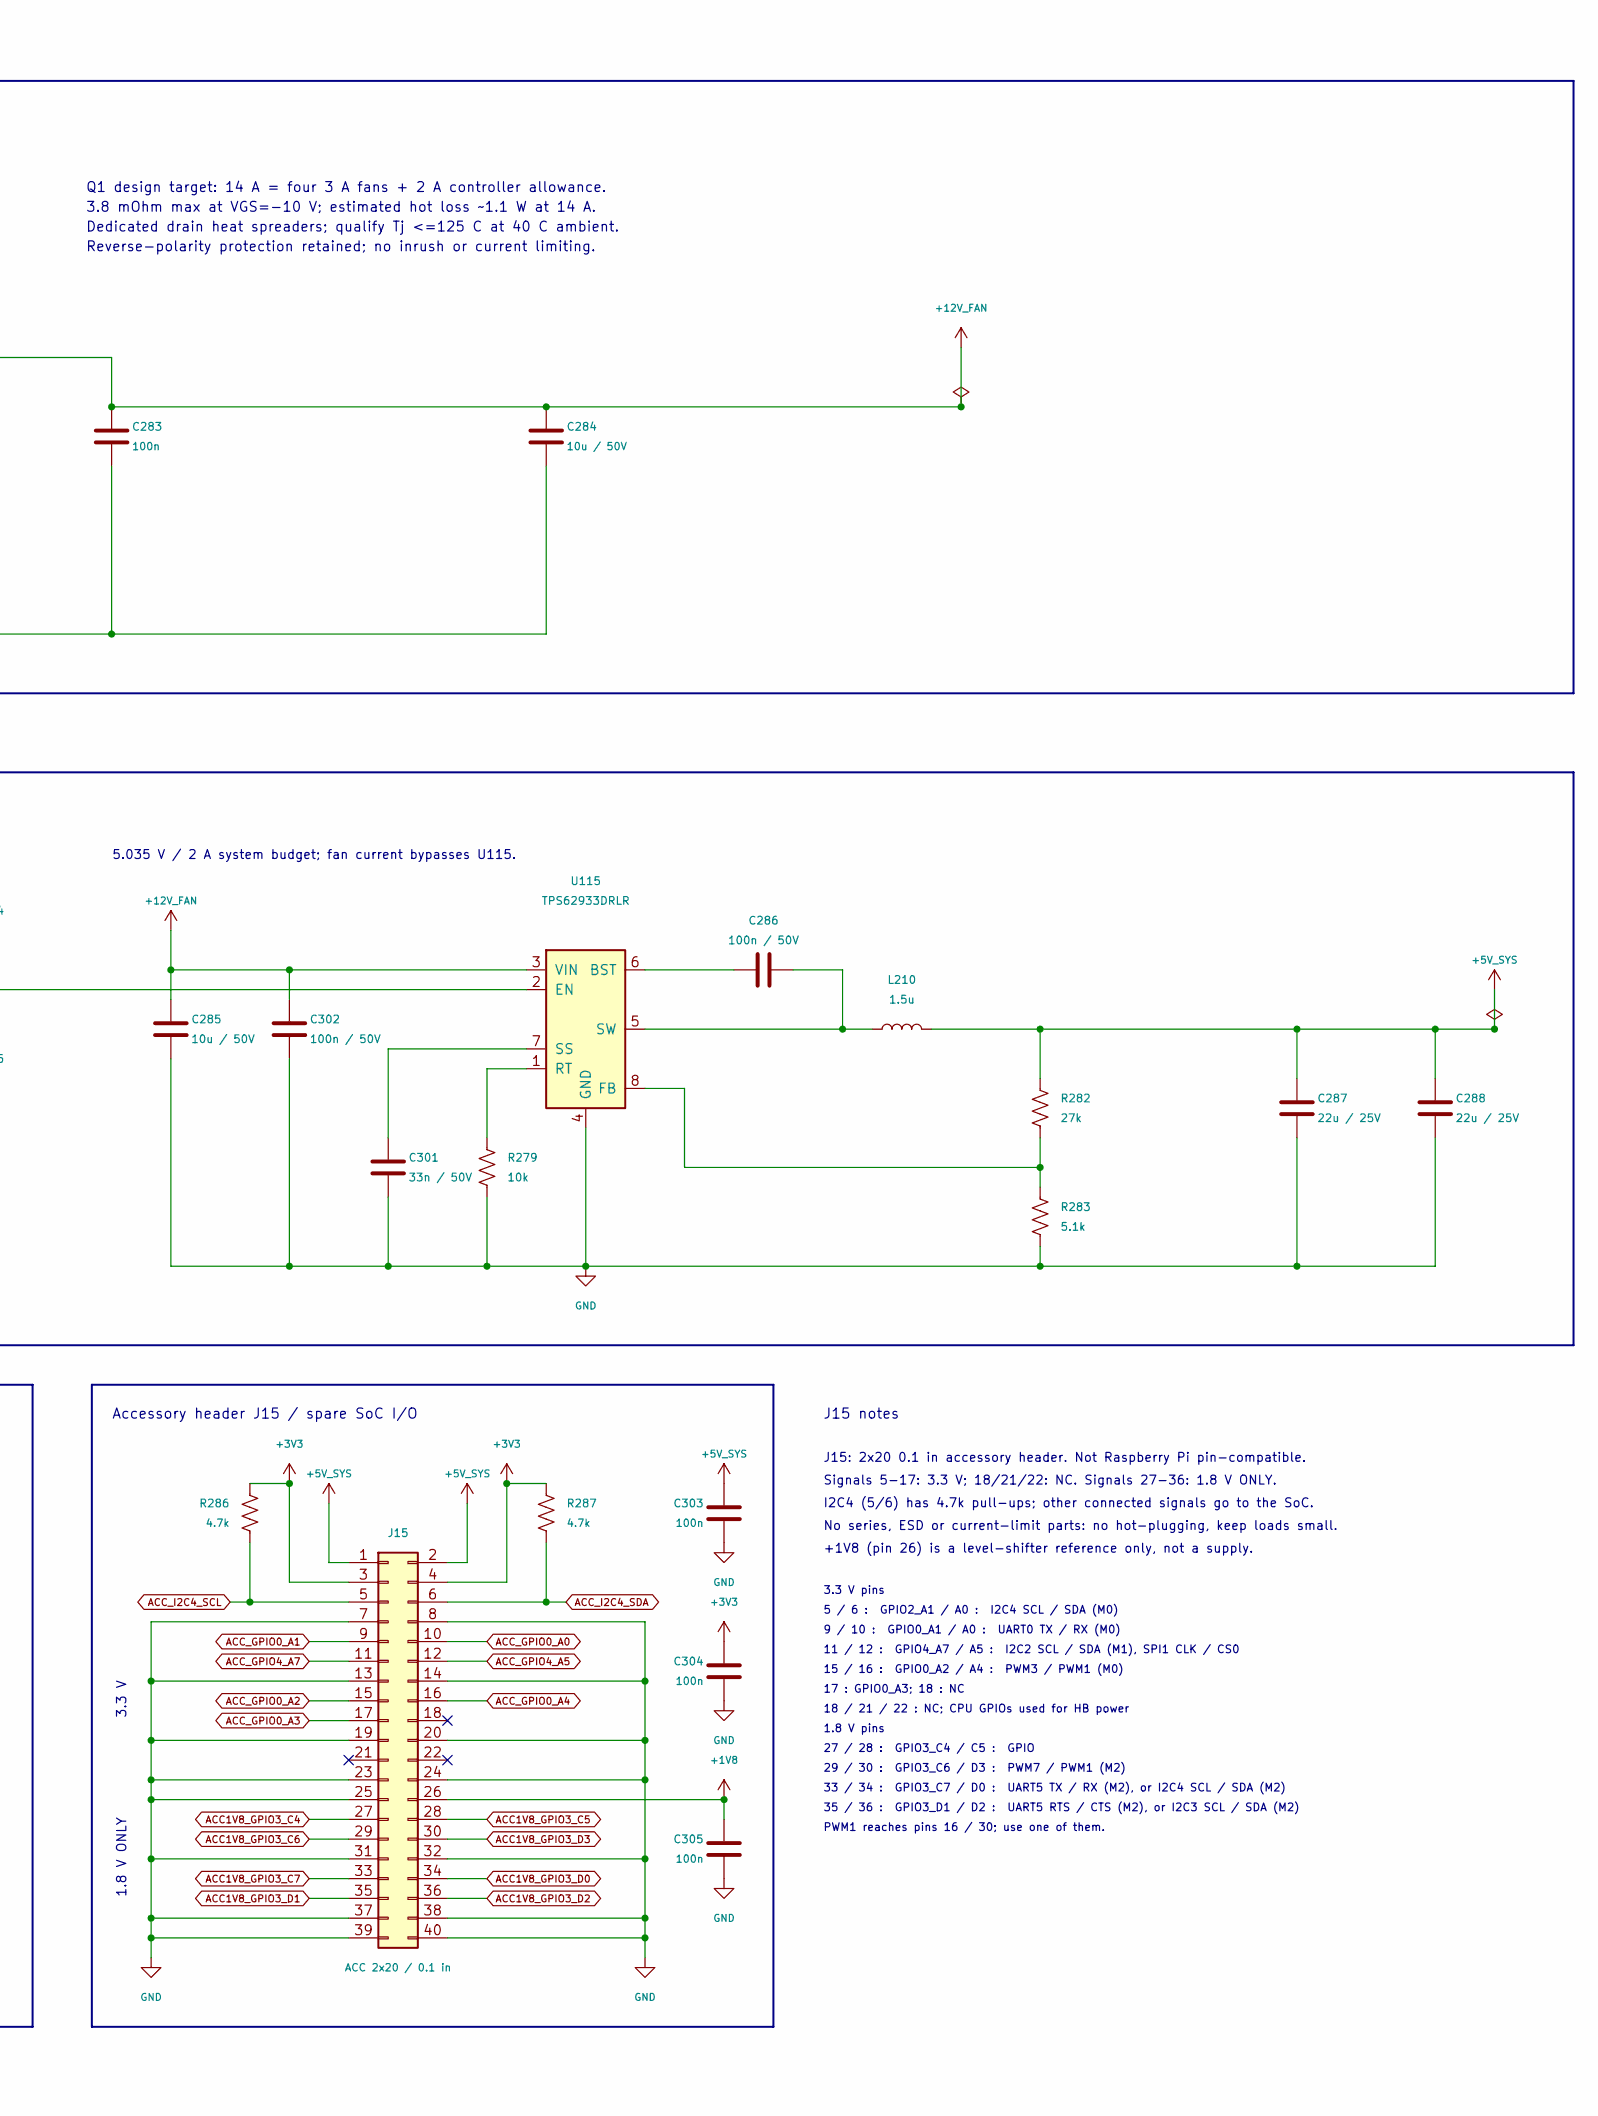
[picture p56: schematic 09_power_service.kicad_sch, MujinaControl-S19 / Input power and service, part in row 1, column 2]

Parts:
C283, C303, C304, C305: 100n; C_0402_1005Metric; MPN CL05B104KO5NNNC; LCSC C1525
C284, C285: 10u / 50V; C_1210_3225Metric; MPN CL32B106KBJNNNE; LCSC C138687
C286, C302: 100n / 50V; C_0402_1005Metric; MPN CL05B104KB54PNC; LCSC C307331
C287, C288: 22u / 25V; C_0805_2012Metric; MPN CL21A226MAQNNNE; LCSC C45783
C301: 33n / 50V; C_0603_1608Metric; MPN CL10B333KB8NNNC; LCSC C21117
D2: BZX84C12; SOT-23-3_L2.9-W1.6-P1.90-LS2.8-BR; MPN BZX84C12; LCSC C19077471
D220: SMBJ15A; D_SMB; MPN SMBJ15A; LCSC C19077569
J1: 0455580003; CONN-TH_50362462; MPN 50362462; LCSC C492365
J10: PSU Comm; CONN-TH_6P-P2.00_PHD-2X3A; MPN HC-PHD-2*3A; LCSC C2845614
J15: ACC 2x20 / 0.1 in; PinHeader_2x20_P2.54mm_Vertical; MPN PZ2.54-2*20; LCSC C5224014
L210: 1.5u; IND-SMD_L2.0-W1.6; MPN FTC201612S1R5MBCA; LCSC C5832350
Q1: NTTFS008P03P8Z; onsemi_WDFN-8_3.3x3.3mm_P0.65mm_CASE483AW; MPN NTTFS008P03P8Z; LCSC C894097
R270, R279: 10k; R_0402_1005Metric; MPN 0402WGF1002TCE; LCSC C25744
R271: 100k; R_0402_1005Metric; MPN 0402WGF1003TCE; LCSC C25741
R272, R273: 4.7k; R_0402_1005Metric; MPN 0402WGF4701TCE; LCSC C25900; not fitted
R282, R284: 27k; R_0402_1005Metric; MPN 0402WGF2702TCE; LCSC C25771
R283, R285: 5.1k; R_0402_1005Metric; MPN 0402WGF5101TCE; LCSC C25905
R286, R287: 4.7k; R_0402_1005Metric; MPN 0402WGF4701TCE; LCSC C25900
TP29, TP30: TestPoint; TestPoint_Pad_D1.0mm; MPN PCB_TESTPOINT; LCSC N/A
U115: TPS62933DRLR; SOT-583-8_L2.1-W1.2-P0.50-LS1.6-BR; MPN TPS62933DRLR; LCSC C3200405

Connections:
+1V8: C305.1, J15.26; also elsewhere on the board
+3V3: C304.1, J15.3, J15.4, R272.1, R273.1, R286.1, R287.1; also elsewhere on the board
+5V_SYS: C287.1, C288.1, C303.1, J15.1, J15.2, L210.2, R282.1; also elsewhere on the board
+12V_FAN: C283.1, C284.1, C285.1, C302.1, D2.3 (K), D220.1 (K), Q1.1 (S), Q1.2 (S), Q1.3 (S), R284.1, U115.3 (VIN); also elsewhere on the board
+12V_IN: J1.1, J1.2, J1.3, Q1.5 (D), Q1.6 (D), Q1.7 (D), Q1.8 (D)
ACC1V8_GPIO3_C4: J15.27; also elsewhere on the board
ACC1V8_GPIO3_C5: J15.28; also elsewhere on the board
ACC1V8_GPIO3_C6: J15.29; also elsewhere on the board
ACC1V8_GPIO3_C7: J15.33; also elsewhere on the board
ACC1V8_GPIO3_D0: J15.34; also elsewhere on the board
ACC1V8_GPIO3_D1: J15.35; also elsewhere on the board
ACC1V8_GPIO3_D2: J15.36; also elsewhere on the board
ACC1V8_GPIO3_D3: J15.30; also elsewhere on the board
ACC_GPIO0_A0: J15.10; also elsewhere on the board
ACC_GPIO0_A1: J15.9; also elsewhere on the board
ACC_GPIO0_A2: J15.15; also elsewhere on the board
ACC_GPIO0_A3: J15.17; also elsewhere on the board
ACC_GPIO0_A4: J15.16; also elsewhere on the board
ACC_GPIO4_A5: J15.12; also elsewhere on the board
ACC_GPIO4_A7: J15.11; also elsewhere on the board
ACC_I2C4_SCL: J15.5, R286.2; also elsewhere on the board
ACC_I2C4_SDA: J15.6, R287.2; also elsewhere on the board
GND: C283.2, C284.2, C285.2, C287.2, C288.2, C301.2, C302.2, C303.2, C304.2, C305.2, D220.2 (A), J1.4, J1.5, J1.6, J10.2, J15.7, J15.8, J15.13, J15.14, J15.19, J15.20, J15.23, J15.24, J15.25, J15.31, J15.32, J15.37, J15.38, J15.39, J15.40, R270.2, R271.2, R279.2, R283.2, R285.2, U115.4 (GND); also elsewhere on the board
unnamed: D2.1 (A), Q1.4 (G), R270.1
unnamed: C286.1, U115.6 (BST)
unnamed: R284.2, R285.1, U115.2 (EN)
unnamed: R282.2, R283.1, U115.8 (FB)
unnamed: R279.1, U115.1 (RT)
unnamed: C301.1, U115.7 (SS)
unnamed: C286.2, L210.1, U115.5 (SW)
PSU_AUX1: J10.1, TP29.1 (1_1)
PSU_AUX4: J10.4, TP30.1 (1_1)
PSU_EN: J10.5, R271.1; also elsewhere on the board
PSU_SCL: J10.6, R273.2; also elsewhere on the board
PSU_SDA: J10.3, R272.2; also elsewhere on the board

Notes on the sheet:
Controller branch / 5 V preregulator
17 : GPIO0_A3; 18 : NC
3.8 mOhm max at VGS=-10 V; estimated hot loss ~1.1 W at 14 A.
27 / 28 : GPIO3_C4 / C5 : GPIO
1.8 V pins
9 / 10 : GPIO0_A1 / A0 : UART0 TX / RX (M0)
J1 retains the six-pin bitcrane power connector. Q1 protects both fan and controller supplies from reversed input. No onboard fuse: input fault disconnection relies on upstream protection.
No series, ESD or current-limit parts: no hot-plugging, keep loads small.
Bonanza 10k RT: 1.98 MHz; 33n SS: 4.8 ms.
I2C4 (5/6) has 4.7k pull-ups; other connected signals go to the SoC.
3.3 V
Input power and service
Dedicated drain heat spreaders; qualify Tj <=125 C at 40 C ambient.
29 / 30 : GPIO3_C6 / D3 : PWM7 / PWM1 (M2)
J15: 2x20 0.1 in accessory header. Not Raspberry Pi pin-compatible.
33 / 34 : GPIO3_C7 / D0 : UART5 TX / RX (M2), or I2C4 SCL / SDA (M2)
Qualify transient, thermal and overload behavior.
Q1 design target: 14 A = four 3 A fans + 2 A controller allowance.
PWM1 reaches pins 16 / 30; use one of them.
PSU communication / enable defaults low
3.3 V pins
12 V input / reverse-polarity protection / fan supply
Reverse-polarity protection retained; no inrush or current limiting.
5 / 6 : GPIO2_A1 / A0 : I2C4 SCL / SDA (M0)
18 / 21 / 22 : NC; CPU GPIOs used for HB power
J15 notes
Signals 5-17: 3.3 V; 18/21/22: NC. Signals 27-36: 1.8 V ONLY.
Accessory header J15 / spare SoC I/O
+1V8 (pin 26) is a level-shifter reference only, not a supply.
11 / 12 : GPIO4_A7 / A5 : I2C2 SCL / SDA (M1), SPI1 CLK / CS0
27k / 5.1k EN divider: starts near 7.6 V input.
15 / 16 : GPIO0_A2 / A4 : PWM3 / PWM1 (M0)
1.8 V ONLY
35 / 36 : GPIO3_D1 / D2 : UART5 RTS / CTS (M2), or I2C3 SCL / SDA (M2)
Confirm PSU enable polarity and cable-side pull-ups before fitting R272/R273. Hashboard bias is on sheet 8.
5.035 V / 2 A system budget; fan current bypasses U115.
No direct 12 V connection to EN (5.5 V limit).

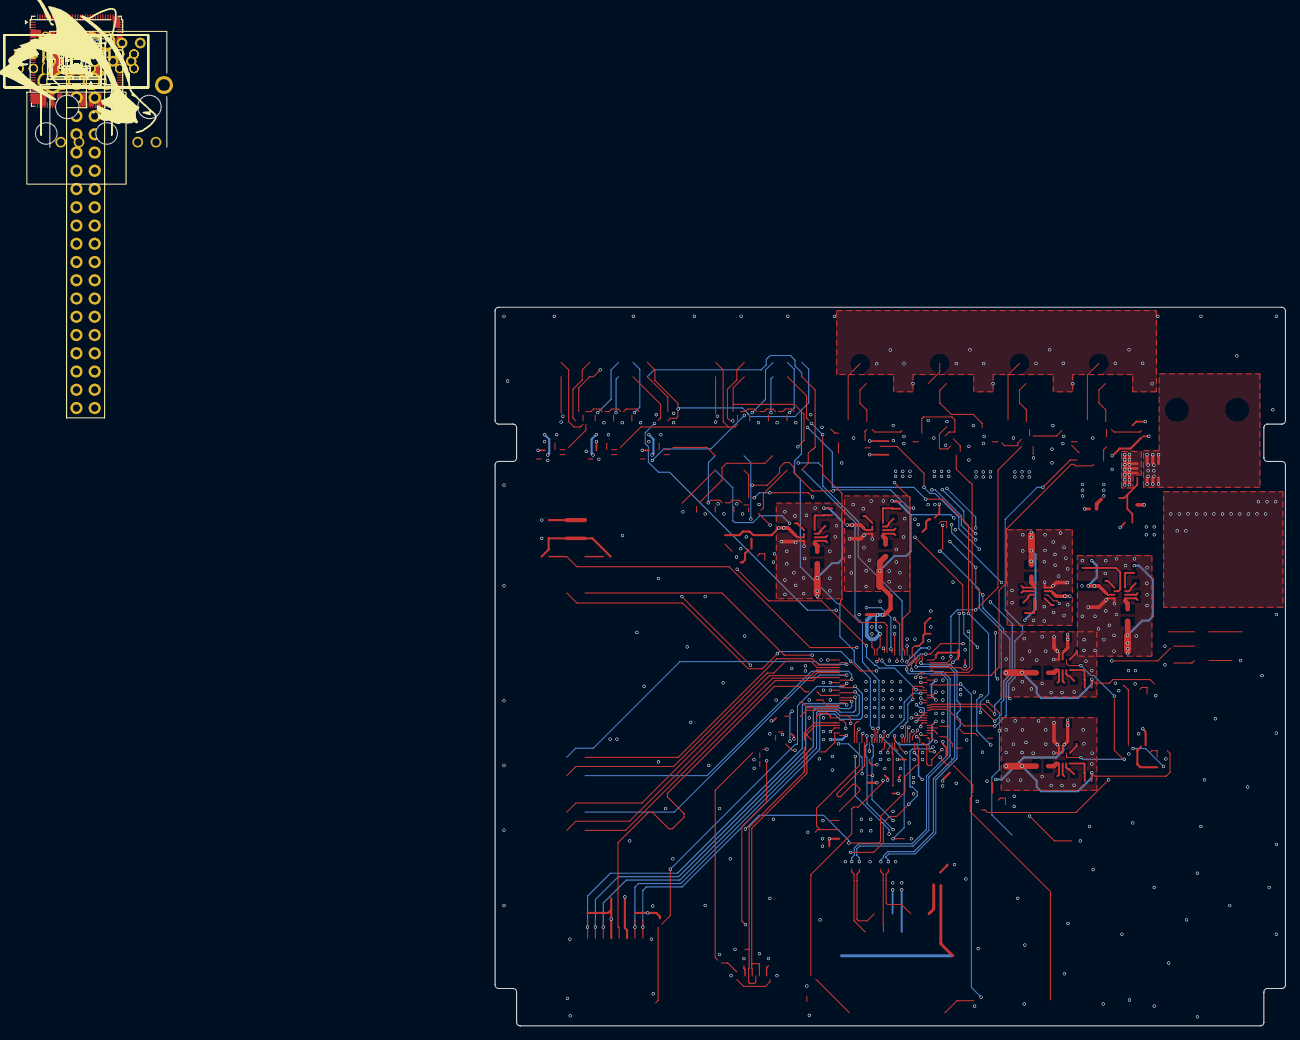
[picture p57: board MujinaControl-S19.kicad_pcb from above]

Board: 6 copper layers, 110.0 x 100.0 mm, 310 parts (0 on the bottom side), 179 nets.
