skot/MujinaControl-S19/(commit log)

2026-11-02 initial import.
    [01_soc.kicad_sch, 02_regulators.kicad_sch, 03_sequencing.kicad_sch, 04_decoupling.kicad_sch, 05_boot.kicad_sch, 06_network_usb.kicad_sch, 07_hashboards.kicad_sch, 08_fans.kicad_sch]
2026-11-07 Save six-layer board placement, initial routing, and 3D models
    Capture schematic refinements, component sourcing fields, footprint model attachments, stackup configuration, and initial RV1106 and power routing. Set all through-vias and routing defaults to 0.45/0.30 mm with a 0.075 mm minimum annular ring.
    Routing remains incomplete. Latest DRC retains the pre-resize baseline of 161 findings and 454 unconnected item pairs. Include design notes and preserve local automatic CAD history outside version control.
    [01_soc.kicad_sch, 02_regulators.kicad_sch, 03_sequencing.kicad_sch, 04_decoupling.kicad_sch, 05_boot.kicad_sch, 06_network_usb.kicad_sch, 07_hashboards.kicad_sch, 08_fans.kicad_sch]
2026-11-10 Update power stages and continue MujinaControl-S19 routing
    Convert all six regulators to TPS62933 with shared Bonanza parts and datasheet-guided placement and routing. Include the fan-supply protection upgrade, fan bulk capacitors, right-angle buttons, routing updates, footprint models, and design notes. The board remains a work in progress.
    [02_regulators.kicad_sch, 03_sequencing.kicad_sch, 05_boot.kicad_sch, 08_fans.kicad_sch, 09_power_service.kicad_sch, CP_Elec_6.3x7.7.step, C_0603_1608Metric.step, IND-SMD_L2.0-W1.6-H1.1.step]
2026-11-10 Advance MujinaControl-S19 routing: flash bus, SoC support and local nets
    Complete SPI NAND flash bus, flash supply, boot ADC, codec bias and DDR calibration routing. Advance local fan, hashboard-address, supervisor, clock and control routing. Add routing notes for both passes and update the fab file notes.
    Routing remains incomplete: 102 unconnected items and 75 DRC findings. Not for ordering.
    [MujinaControl-S19.kicad_pcb]
2026-11-10 Save reviewed placement, hashboard power controls and power routing
    [01_soc.kicad_sch, 02_regulators.kicad_sch, 07_hashboards.kicad_sch, 09_power_service.kicad_sch, MujinaControl-S19.kicad_pcb, MujinaControl-S19.kicad_sch, PinHeader_2x20_P2.54mm_Vertical.step, SOT-363_SC-70-6.step]
2026-11-12 Route the full board, clean up tracks, stitch ground
    - Route USB, Ethernet, SD card and SPI NAND with length matching to the
    RV1106 guide limits; route all remaining power drops and signals.
    0 unconnected items; DRC shows only the 67 findings that predate routing.
    - Processor fan-out: 1.8 V trunks moved to In2 strips, In3 used for slow
    signals, SD data group exits west, Ethernet pairs exit east.
    - Track clean-up: straighten machine-laid runs, merge duplicate copper,
    chamfer corners, re-route the most wasteful nets, re-match the SD clock.
    - Regulators: take the sequencing nets and the core sense line off the
    local ground pours; add 86 pour and 67 board ground stitching vias.
    - 1925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
    [MujinaControl-S19.kicad_pcb]
2026-11-12 Hide silkscreen refdes and clear all DRC findings
    - Hide the 43 reference designators on F.SilkS; only button labels remain
    - Fix J2 hole clearance, J1 courtyard, fan connector silk overlaps/edge clips
    - Bring SW1/SW2 and J16 library footprints in line with the board
    - Schematic parity: SW2 value BOOT, drop stray Q1 ki_fp_filters field
    - DRC: 0 violations, 0 unconnected, 0 parity; ERC: 0
    [05_boot.kicad_sch, 09_power_service.kicad_sch, MujinaControl-S19.kicad_pcb]
2026-11-12 README: bring up to date with the routed, DRC-clean board
    Describe the current hardware (TPS62933 bucks, TPS22919 hashboard
    switches, NTTFS008P03P8Z input FET, no fuse), six-layer routed PCB,
    fab assembly and parts status, pre-order review list, file layout,
    and full attribution including bitcrane and Braiins BCB100.
2026-11-12 README: add board render at the top
2026-11-12 Add Mujina logo artwork, move parts to fab basic/preferred stock, rev1
    - Mujina badger logo on the board; logo, wordmark and text footprints
    added to lib/Mujina.pretty
    - Parts checked against fab live stock (docs/bom-fab-stock.md): LCSC and
    MPN on every purchased part, 65 part numbers (24 basic, 9 preferred,
    32 extended); supervisor dividers retuned to trip at ~90 %
    - Schematic revision set to rev1
    - README: updated part counts and silkscreen artwork
    ERC 0; DRC 0 violations, 0 unconnected; 1 parity warning: J15 is
    excluded from BOM/position files on the board but not in the schematic.
    [01_soc.kicad_sch, 02_regulators.kicad_sch, 03_sequencing.kicad_sch, 04_decoupling.kicad_sch, 05_boot.kicad_sch, 06_network_usb.kicad_sch, 07_hashboards.kicad_sch, 08_fans.kicad_sch]
