skot/MujinaControl-S19/(notices)

Notices in the files:
3d/kicad/LED_0603_1608Metric.step:
Copyright (C) 2018, kicad StepUp
This work is licensed under the [Creative Commons CC-BY-SA 4.0 License](https://creativecommons.org/licenses/by-sa/4.0/legalcode),
with the following exception:
To the extent that the creation of electronic designs that use 'Licensed Material' can be considered to be 'Adapted Material',
You are free to use the library data in your own projects without the obligation to share your project files under this or any other license agreement.
3d/kicad/PinHeader_2x20_P2.54mm_Vertical.step:
Copyright (C) 2017, kicad StepUp
3d/kicad/D_SMB.step:
This program is free software: you can redistribute it and/or modify
it under the terms of the GNU General Public License as published by
the Free Software Foundation, either version 3 of the License, or
any later version.
itself might be covered by the GNU General Public License.
3d/kicad/Crystal_SMD_3215-2Pin_3.2x1.5mm.step:
Copyright (C) 2024, KiCAD
This work is licensed under the
[Creative Commons CC-BY-SA 4.0 License](https://creativecommons.org/licenses/by-sa/4.0/legalcode),
project files under this or any other license agreement. However, if you wish to distribute
3d/kicad/SOT-23-6.step:
Copyright (C) 2025, KiCAD
3d/raven/Rockchip_QFN-128-1EP_12.3x12.3mm_P0.35mm_EP7x7mm.step:
Copyright (C) 2026, KiCAD
